StevekDon/NaI-Tl-scintillator-gamma-ray-Digital-Multi-Channel-Analyzer/hardware/mechnical/zynq_box.stl

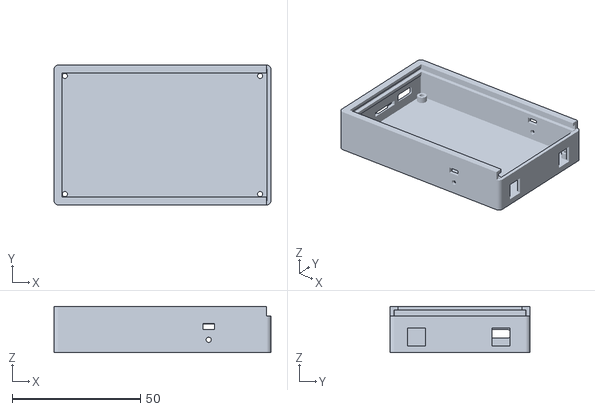
[picture p1: CAD file, 2026-01-17]
hardware/mechnical/zynq_box.stl
84.5 x 54.5 x 18.0
