StevekDon/NaI-Tl-scintillator-gamma-ray-Digital-Multi-Channel-Analyzer/hardware/mechnical/detector_cover.stl

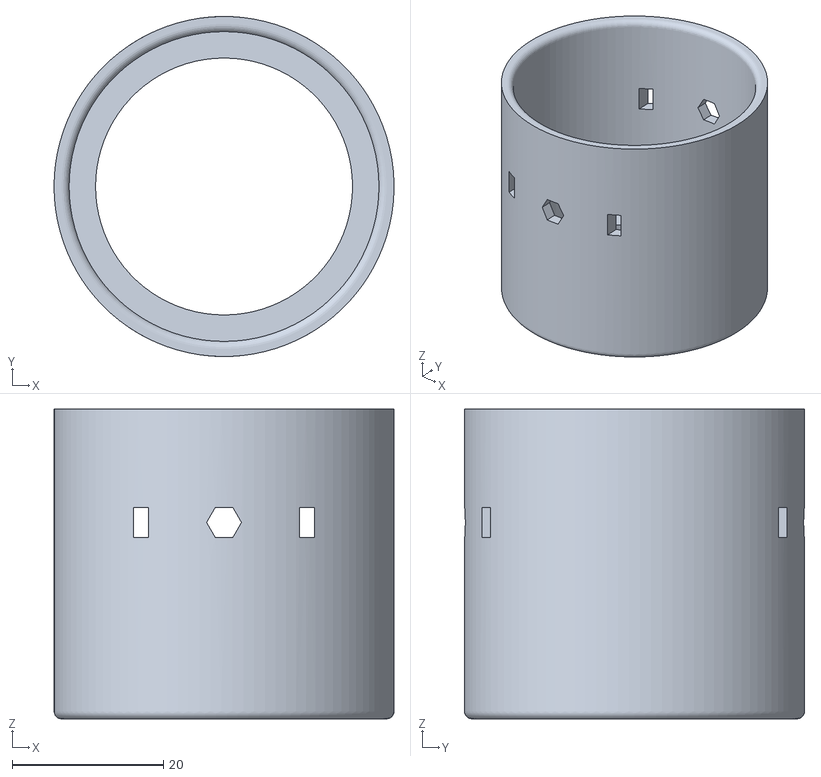
[picture p2: CAD file, 2026-01-17]
hardware/mechnical/detector_cover.stl
45.0 x 45.0 x 41.0
