StevekDon/NaI-Tl-scintillator-gamma-ray-Digital-Multi-Channel-Analyzer/hardware/mechnical/zynq_cover.stl

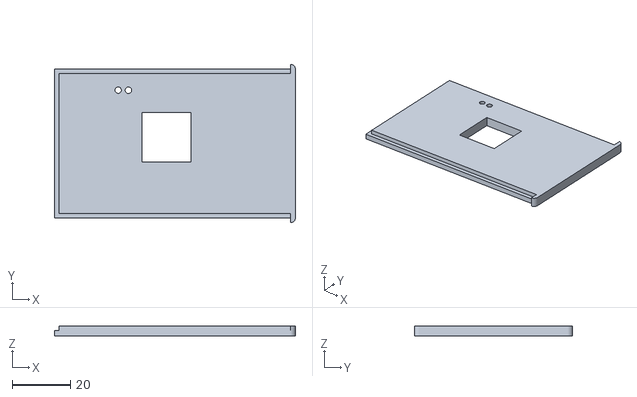
[picture p3: CAD file, 2026-01-17]
hardware/mechnical/zynq_cover.stl
82.9 x 54.5 x 3.60
