StevekDon/NaI-Tl-scintillator-gamma-ray-Digital-Multi-Channel-Analyzer/hardware/mechnical/3d_side_arm v6.stl

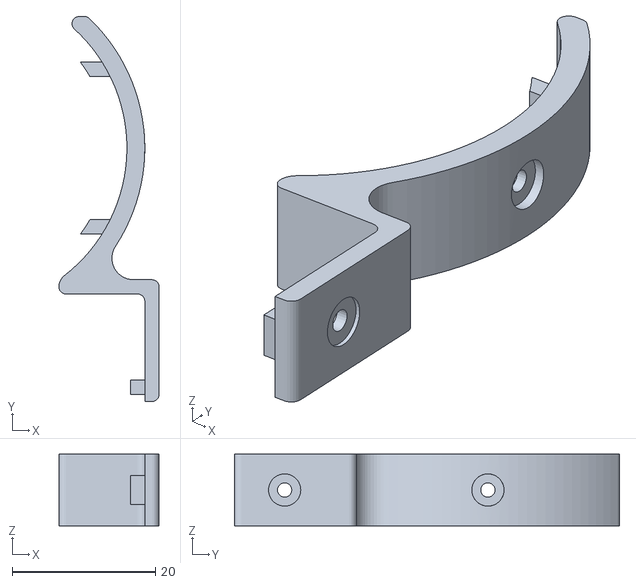
[picture p4: CAD file, 2026-01-17]
hardware/mechnical/3d_side_arm v6.stl
14.0 x 53.7 x 10.0
