StevekDon/NaI-Tl-scintillator-gamma-ray-Digital-Multi-Channel-Analyzer/hardware/schematics/PMT_PWR.pdf

## PMT负高压源 输入升压+12V

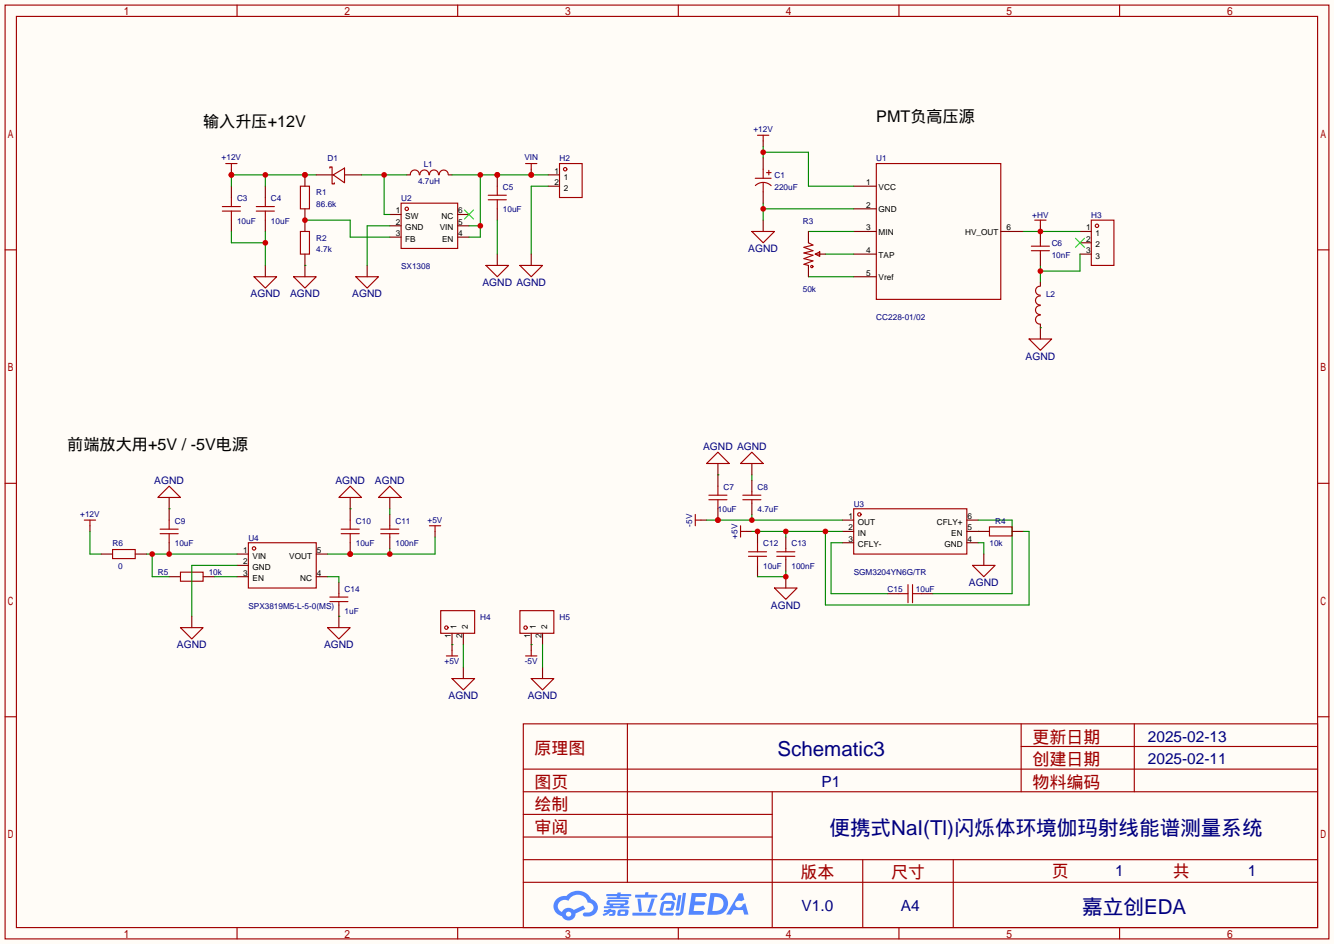
[picture p5: page 1]
