StevekDon/NaI-Tl-scintillator-gamma-ray-Digital-Multi-Channel-Analyzer/hardware/schematics/xilin_downloader.pdf

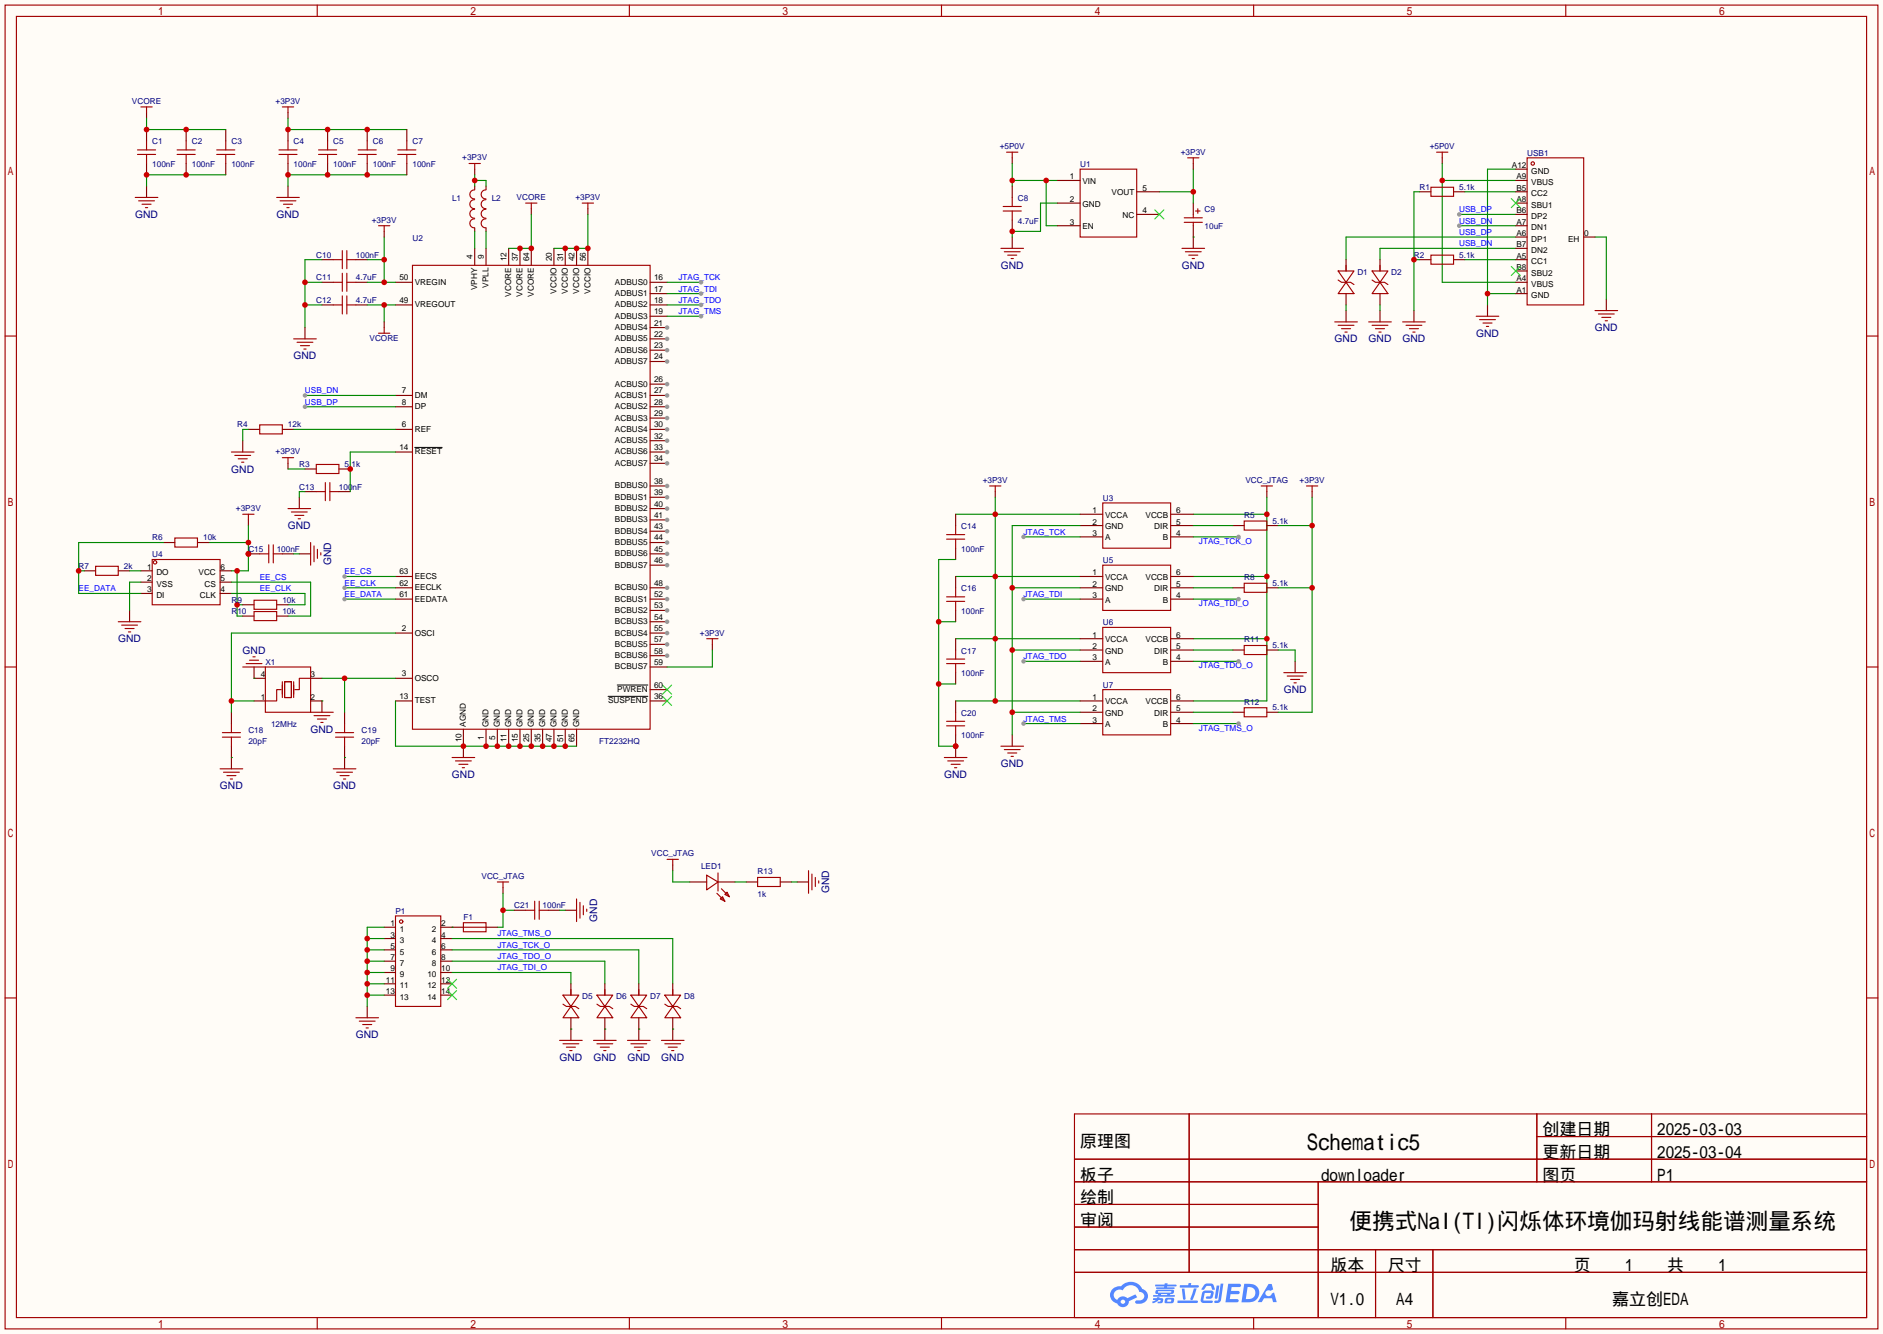
[picture p6: page 1]

GND GND

原理图 | Schematic5 | 创建日期 | 2025-03-03

更新日期 | 2025-03-04

板子 | downloader | 图页 | P1
绘制 | | 便携式NaI(Tl)闪烁体环境伽玛射线能谱测量系统
审阅

V1.0 | A4 | 嘉立创EDA
