StevekDon/NaI-Tl-scintillator-gamma-ray-Digital-Multi-Channel-Analyzer/hardware/schematics/zynq7020.pdf

审阅

绘制

版本

## 创建日期 物料编码

页 | 共

## 原理图

## 更新日期

尺寸

图页

V1.0 | A3

# 便携式NaI(Tl)闪烁体环境伽玛射线能谱测量系统

2025-08-05

# 2025-02-11 Schematic1_1

# BLOCK

# XC7Z020-2CLG400I

DDR3 2Gb | QSPI-FLASH | TF-CARD

AD9245

# 80MHz

# UART-PS PL-UARTLite JTAG

# PL 50.00MHz PS 33.33MHz

审阅

绘制

## 创建日期 物料编码

## 原理图

## 更新日期

图页

# 便携式NaI(Tl)闪烁体环境伽玛射线能谱测量系统

2025-07-16

# 2025-02-11 Schematic1_1

# POWER_TREE

+5P0V_IN | +1V0_S0 | +1V8_S0 | +1V35_S0 | +3V3_S0

# PS: VCCINT(1.0V) -> VCCPAUX&VCCPLL(1.8V) -> VCC_1.35V -> VCC_3V3 PL: VCCINT&VCCBRAM(1.0V) -> VCCAUX&VCCAUX_IO&VCCO_1V8(1.8V) -> VCC_3V3

+3V3_ADC | -3V3_ADC

+1.0V @ 3A

# PS: VCCINT(1.0V) -> VCCPAUX&VCCPLL(1.8V) -> VCC_1.35V -> VCC_3V3

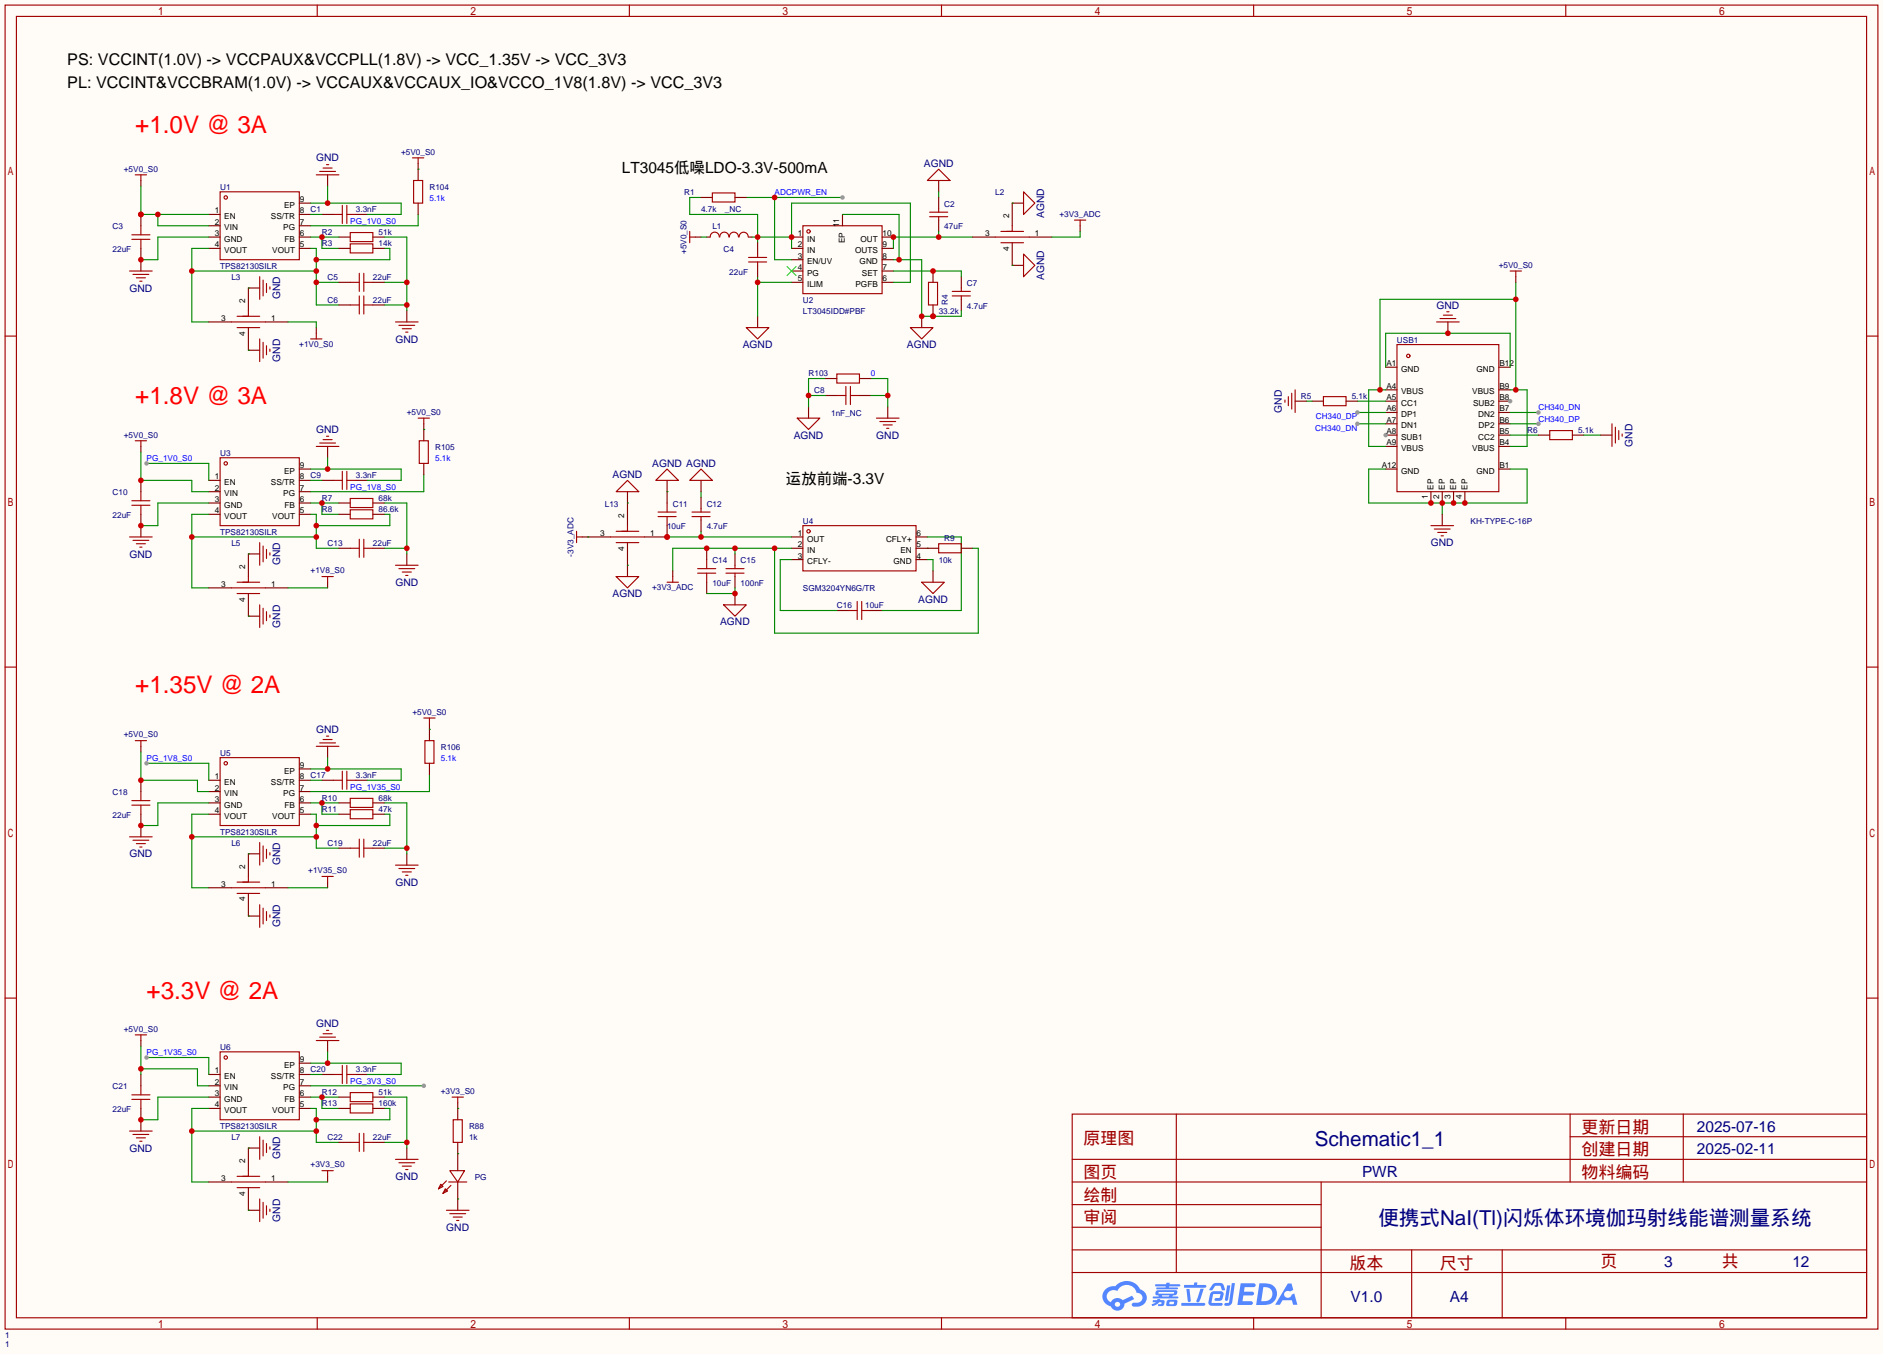
[picture p7: page 3]

PL: VCCINT&VCCBRAM(1.0V) -> VCCAUX&VCCAUX_IO&VCCO_1V8(1.8V) -> VCC_3V3

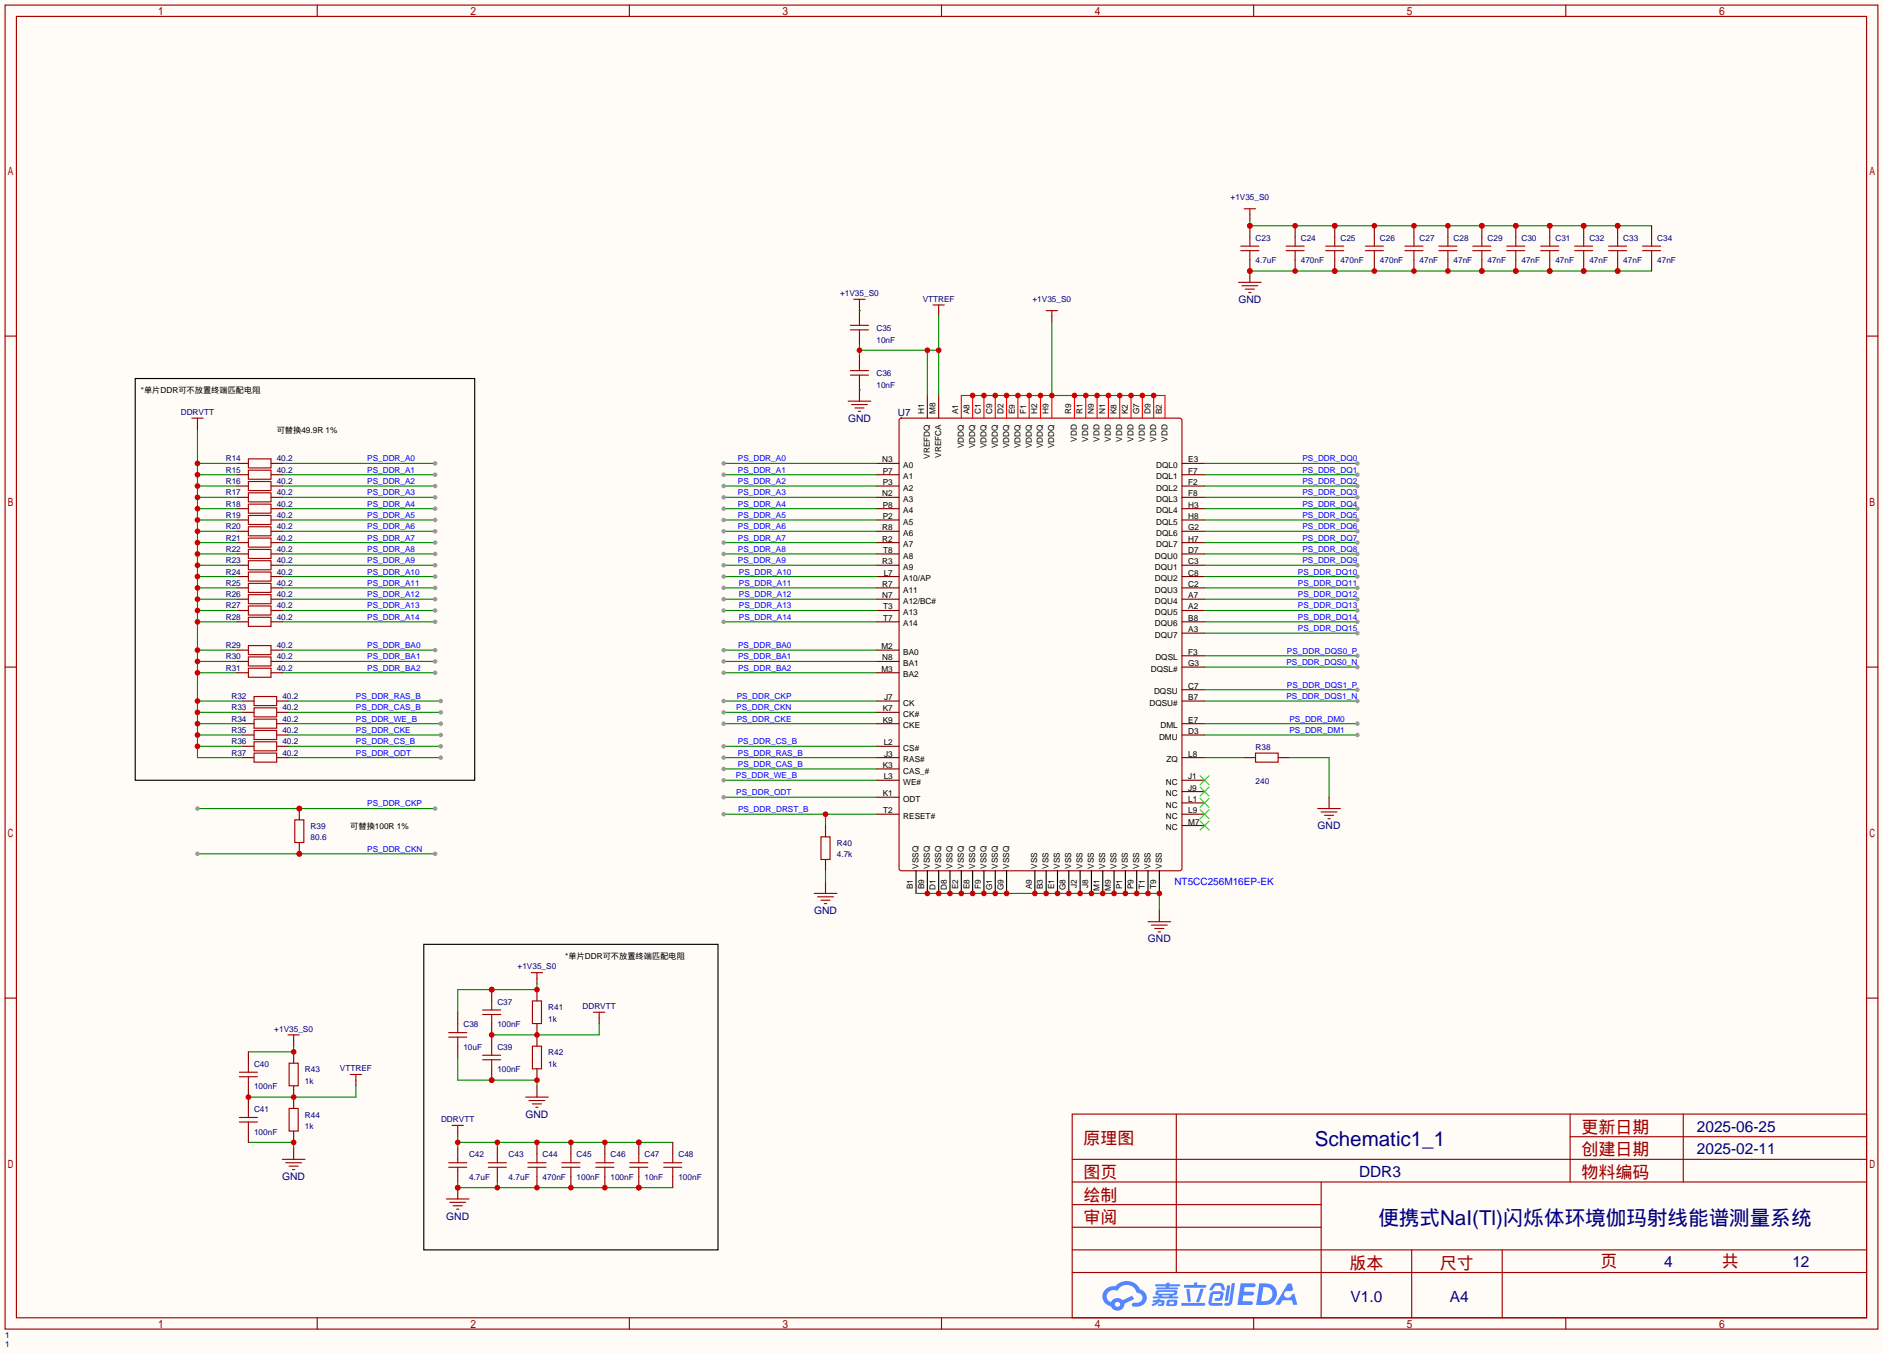
[picture p8: page 4]

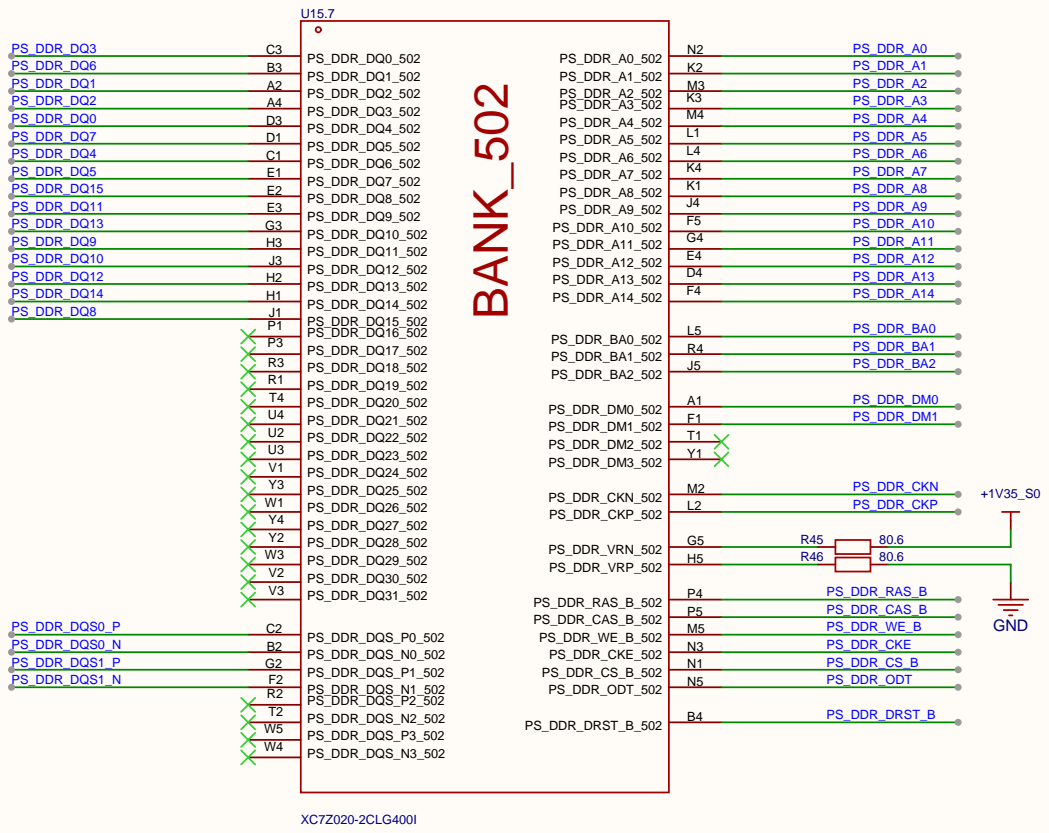
[picture p9: page 5]

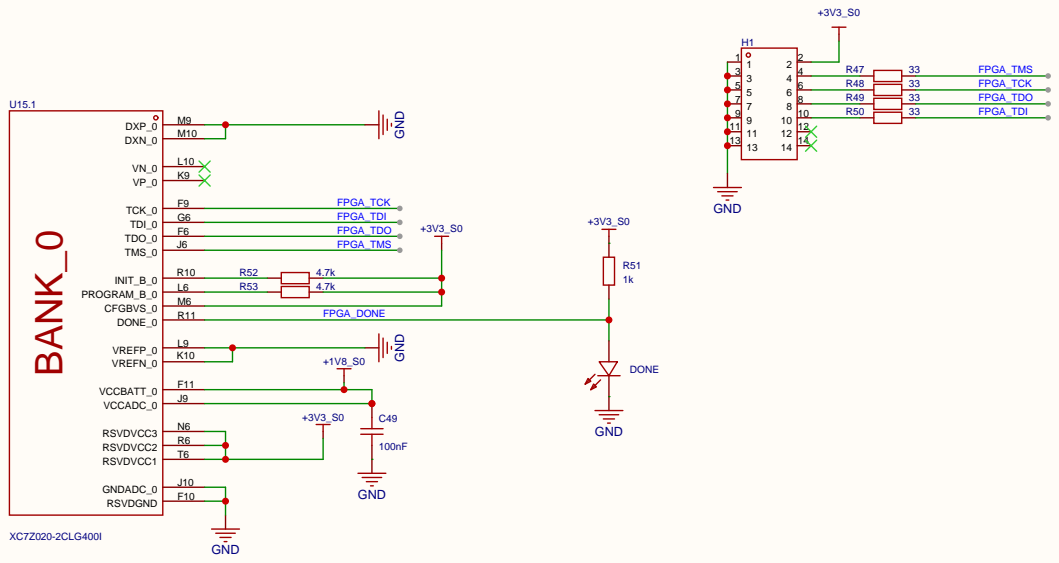
[picture p10: page 6]

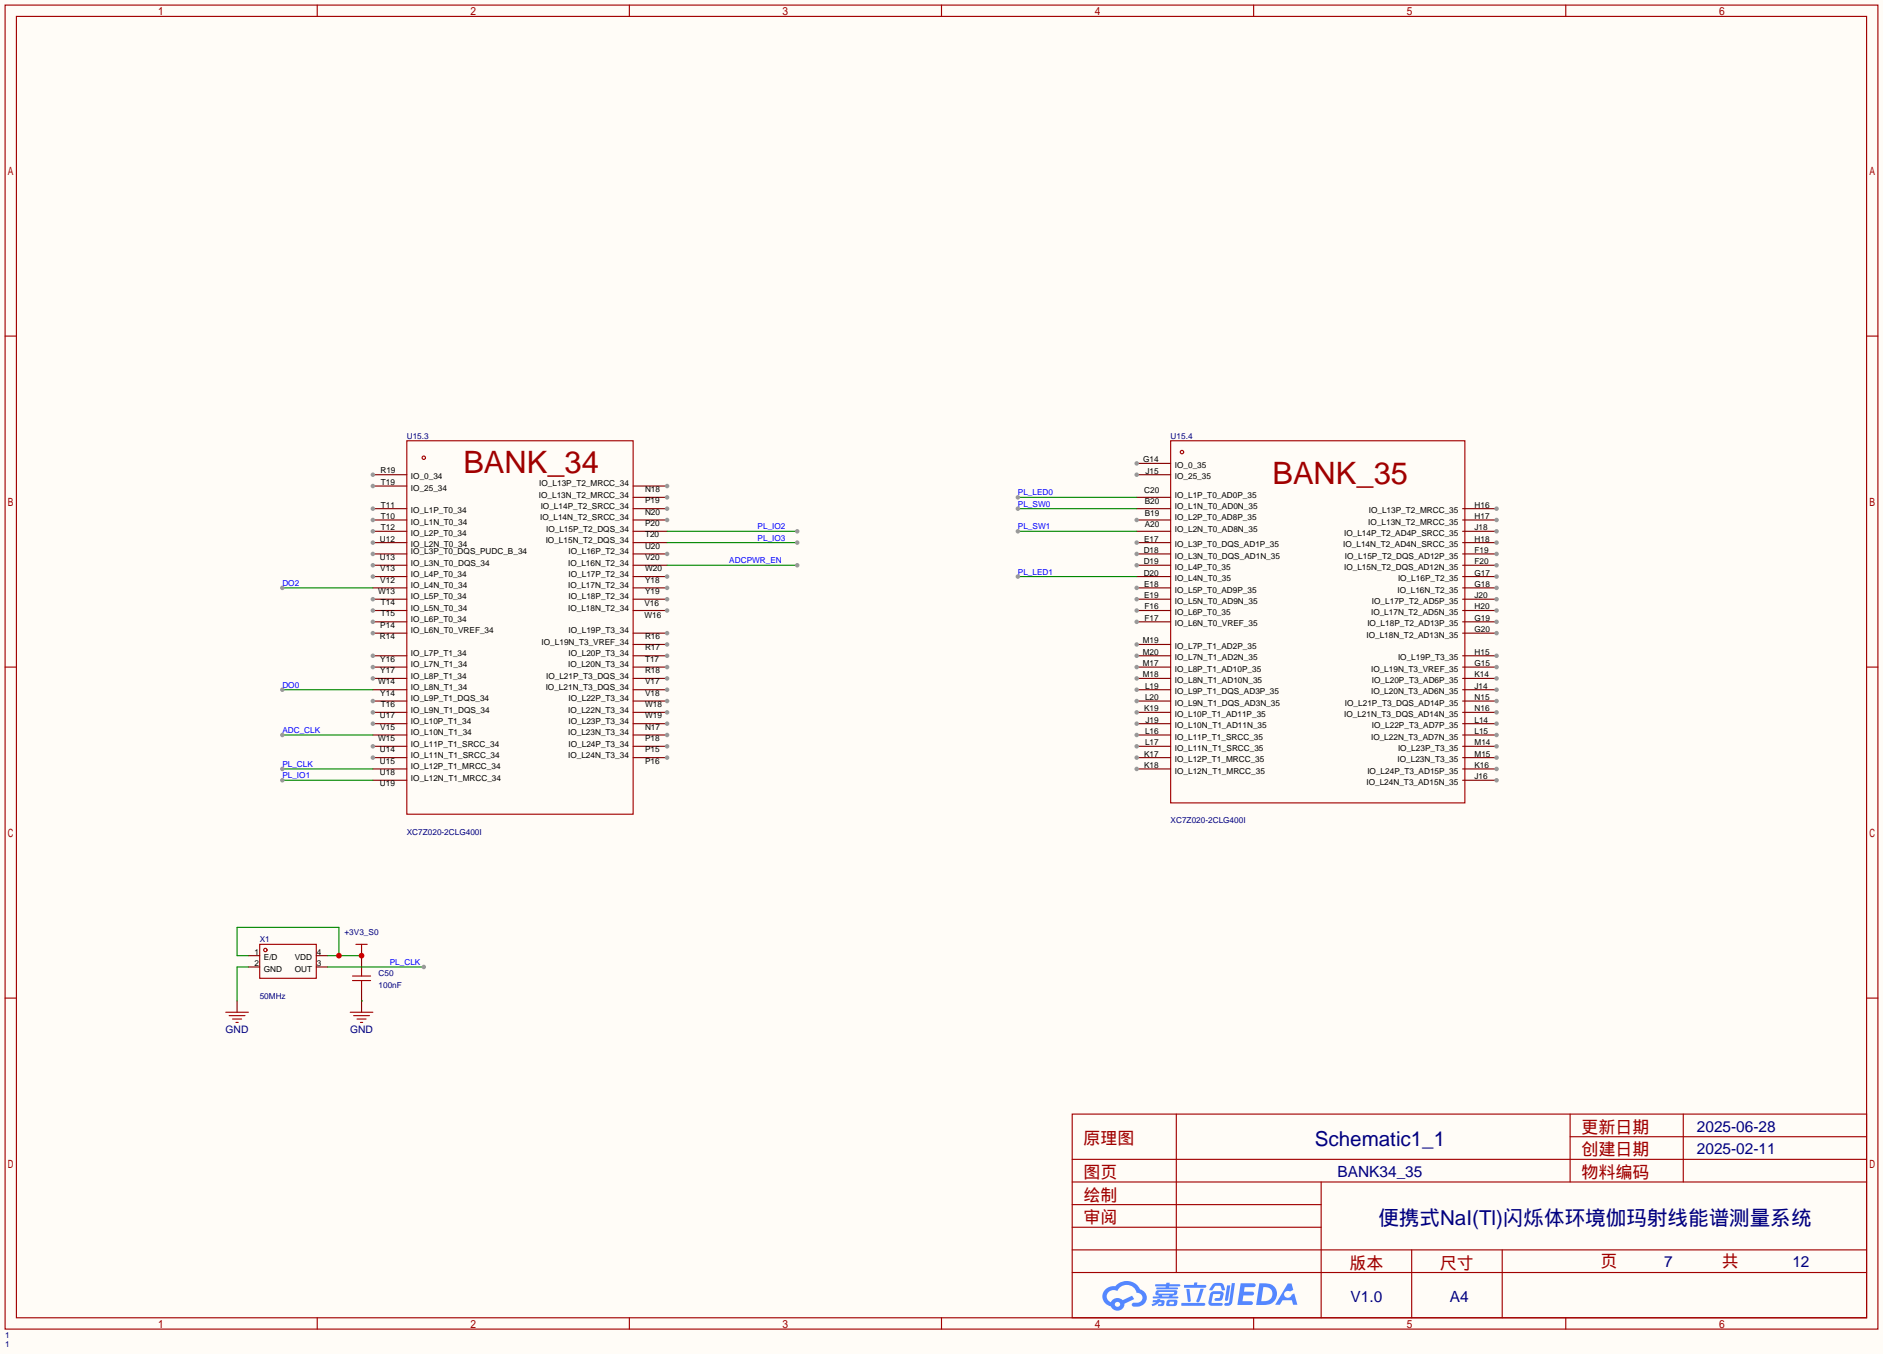
[picture p11: page 7]

# *BOOT OPTION

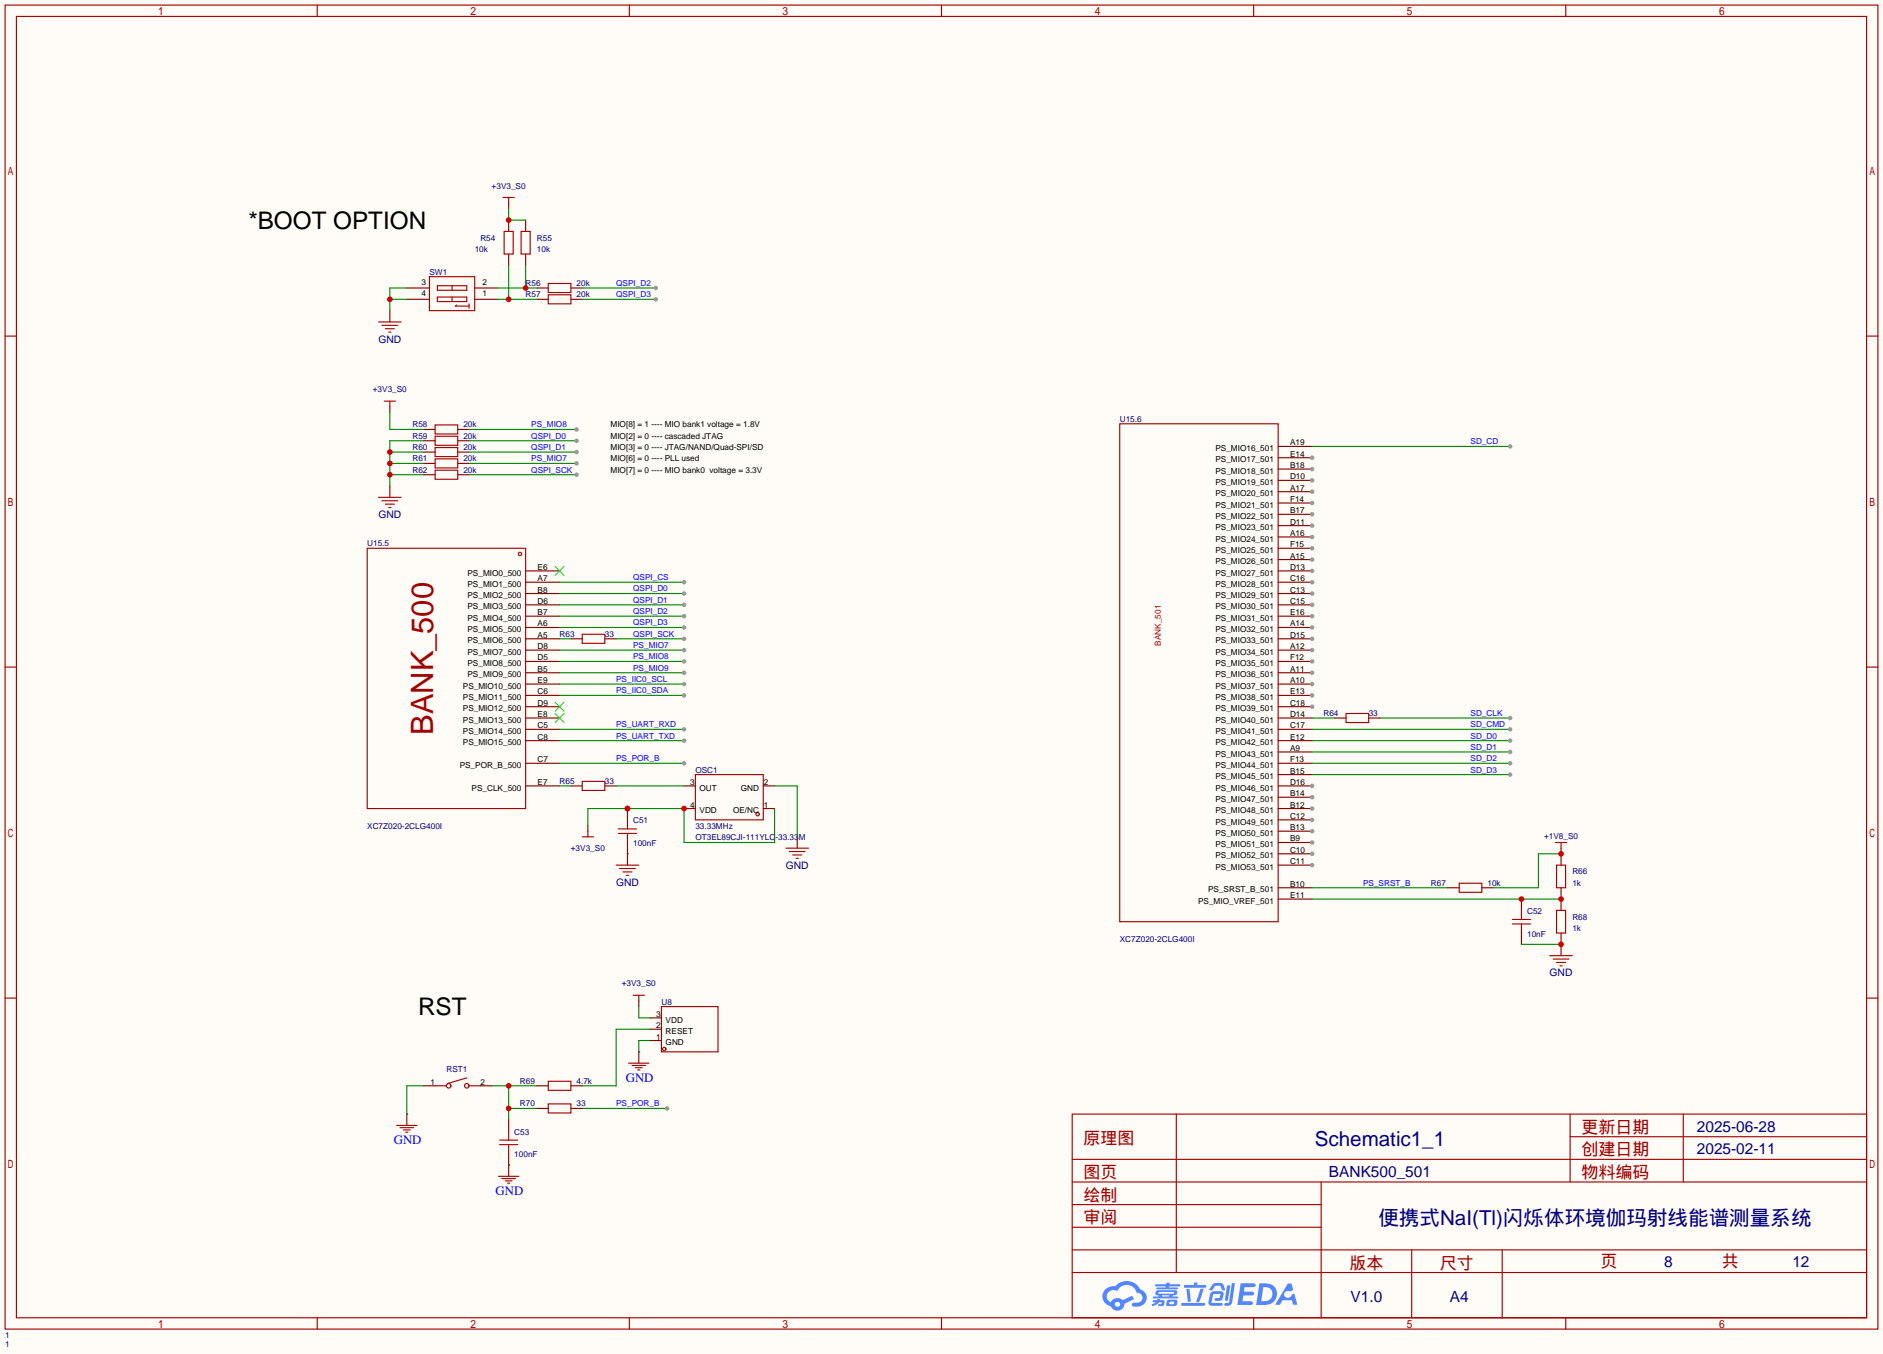
[picture p12: page 8]

MIO[8] = 1 ---- MIO bank1 voltage = 1.8V
MIO[2] = 0 ---- cascaded JTAG
MIO[3] = 0 ---- JTAG/NAND/Quad-SPI/SD
MIO[6] = 0 ---- PLL used
MIO[7] = 0 ---- MIO bank0 voltage = 3.3V

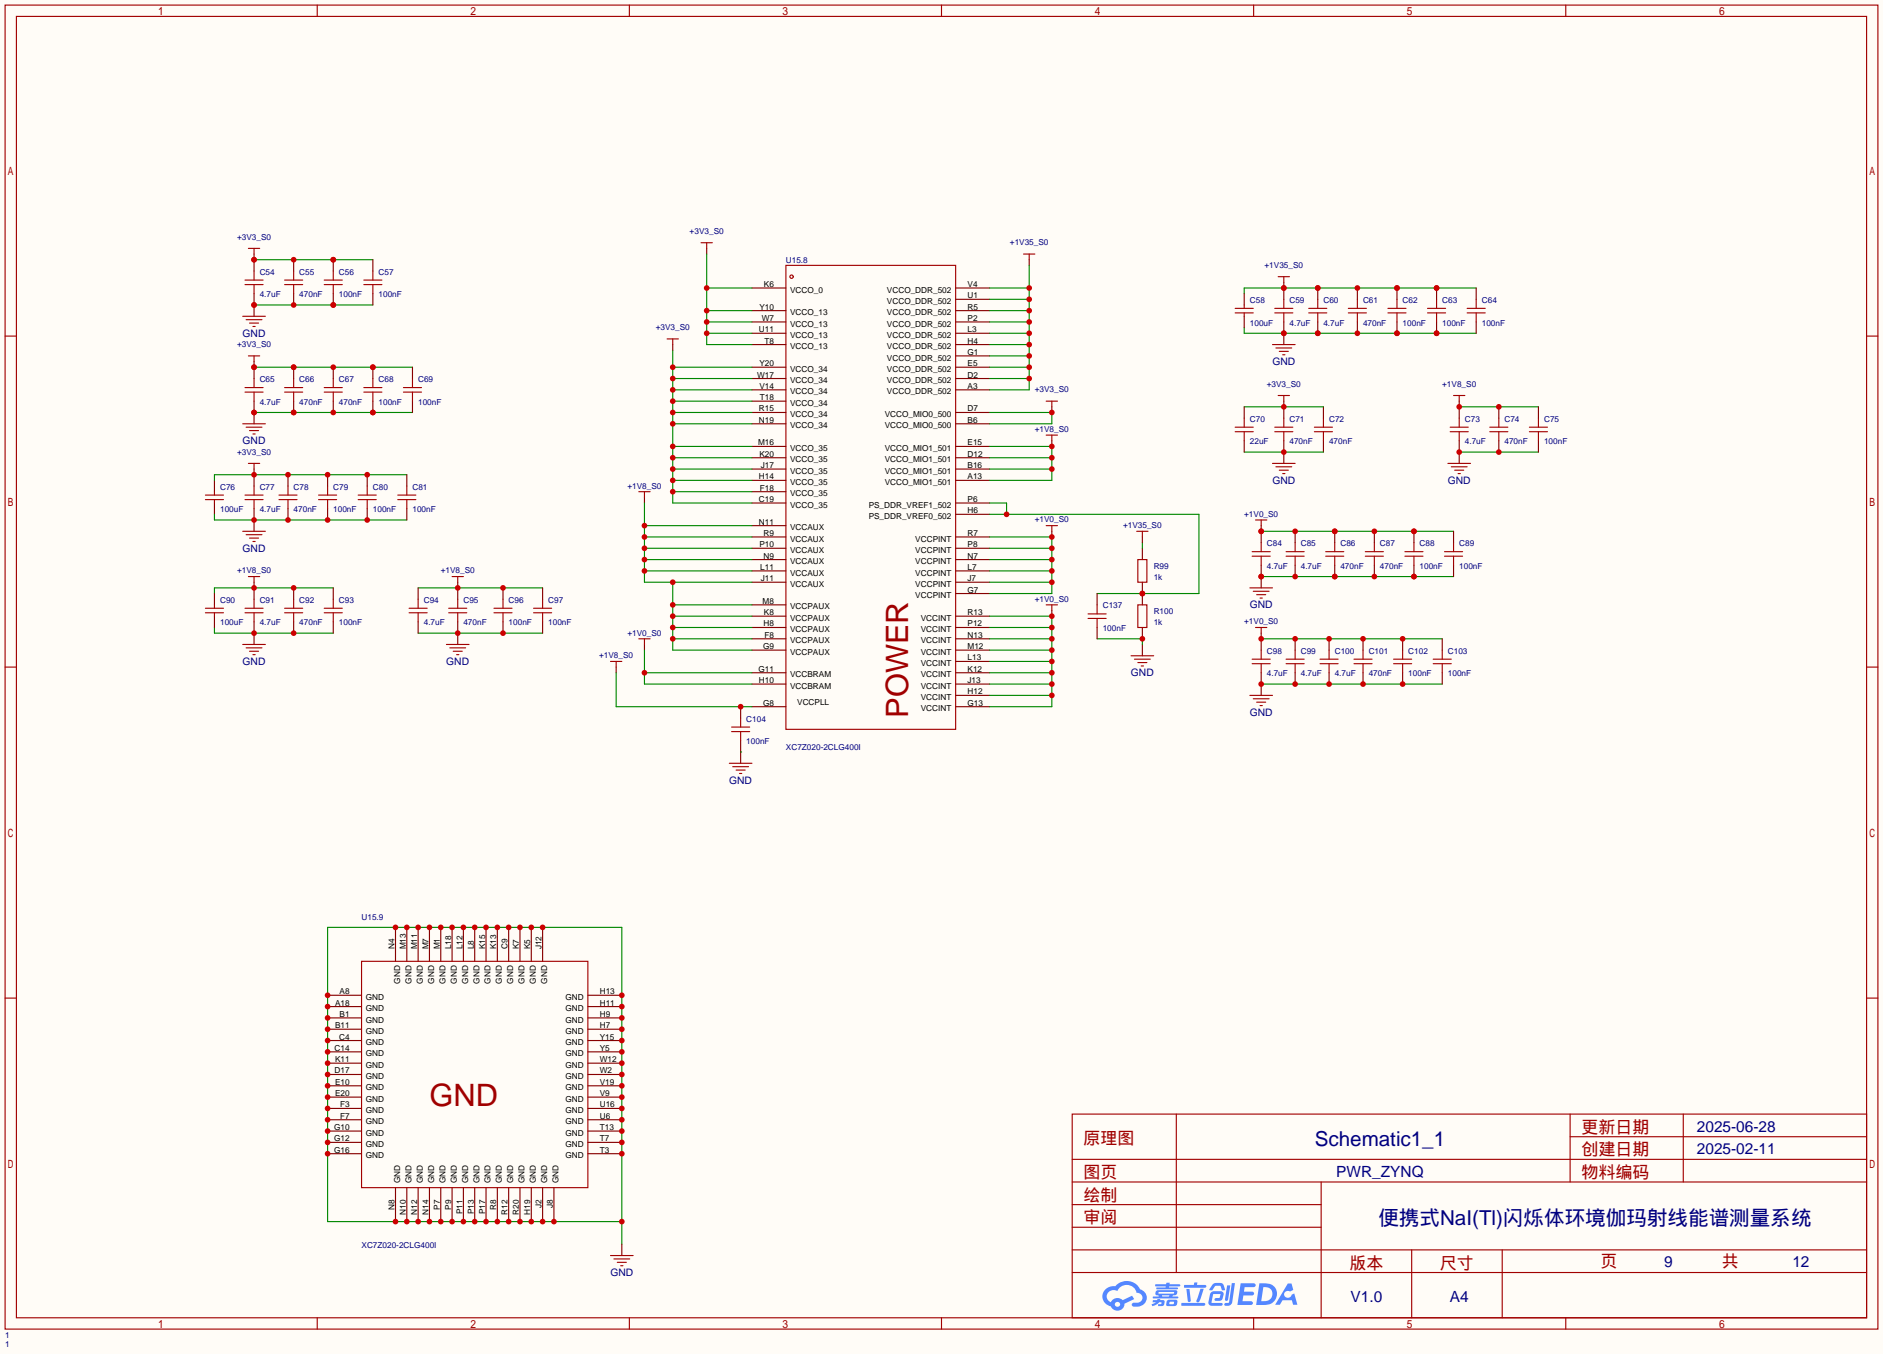
[picture p13: page 9]

GND J8 GND J12 GND K5 GND K7 GND C9 GND K13 GND K15 GND L8 GND L12 GND L18 GND M1 GND M7 GND M11 GND M13 GND N4 GND N8 GND N10 GND N12 GND N14 GND P7 GND P9 GND P11 GND P13 GND P17 GND R8 GND R12 GND R20

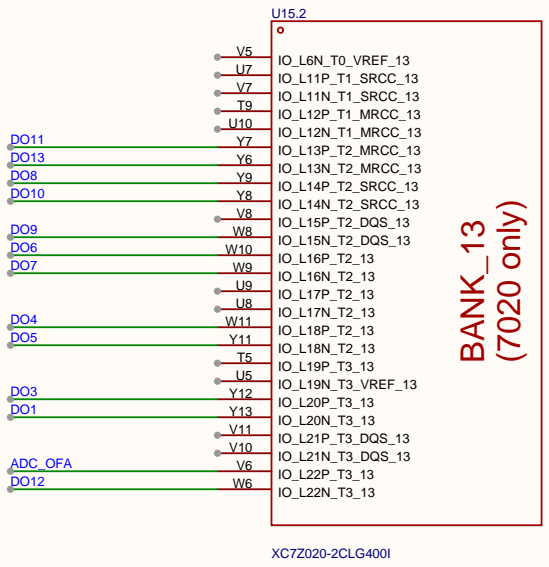
[picture p14: figure]
IO_L6N_T0_VREF_13 V5 IO_L11P_T1_SRCC_13 U7 IO_L11N_T1_SRCC_13 V7 IO_L12P_T1_MRCC_13 T9 IO_L12N_T1_MRCC_13 U10 IO_L13P_T2_MRCC_13 Y7 IO_L13N_T2_MRCC_13 Y6 IO_L14P_T2_SRCC_13 Y9 IO_L14N_T2_SRCC_13 Y8 IO_L15P_T2_DQS_13 V8 IO_L15N_T2_DQS_13 W8 IO_L16P_T2_13 W10 IO_L16N_T2_13 W9 IO_L17P_T2_13 U9 IO_L17N_T2_13 U8 IO_L18P_T2_13 W11 IO_L18N_T2_13 Y11 IO_L19P_T3_13 T5 IO_L19N_T3_VREF_13 U5 IO_L20P_T3_13 Y12 IO_L20N_T3_13 Y13 IO_L21P_T3_DQS_13 V11 IO_L21N_T3_DQS_13 V10 IO_L22P_T3_13 V6 IO_L22N_T3_13 W6; BANK_13; (7020 only); XC7Z020-2CLG400I; ADC_OFA DO12

审阅

绘制

## 创建日期 物料编码 页

共

## 原理图

## 更新日期

图页

# 便携式NaI(Tl)闪烁体环境伽玛射线能谱测量系统

2025-06-28

# 2025-02-11 Schematic1_1

# BANK13

# AD9245-80M

# *具体电阻取值或增益调整参考datasheet的Setting the Closed-Loop Gain & Terminating a Single-Ended Input部分

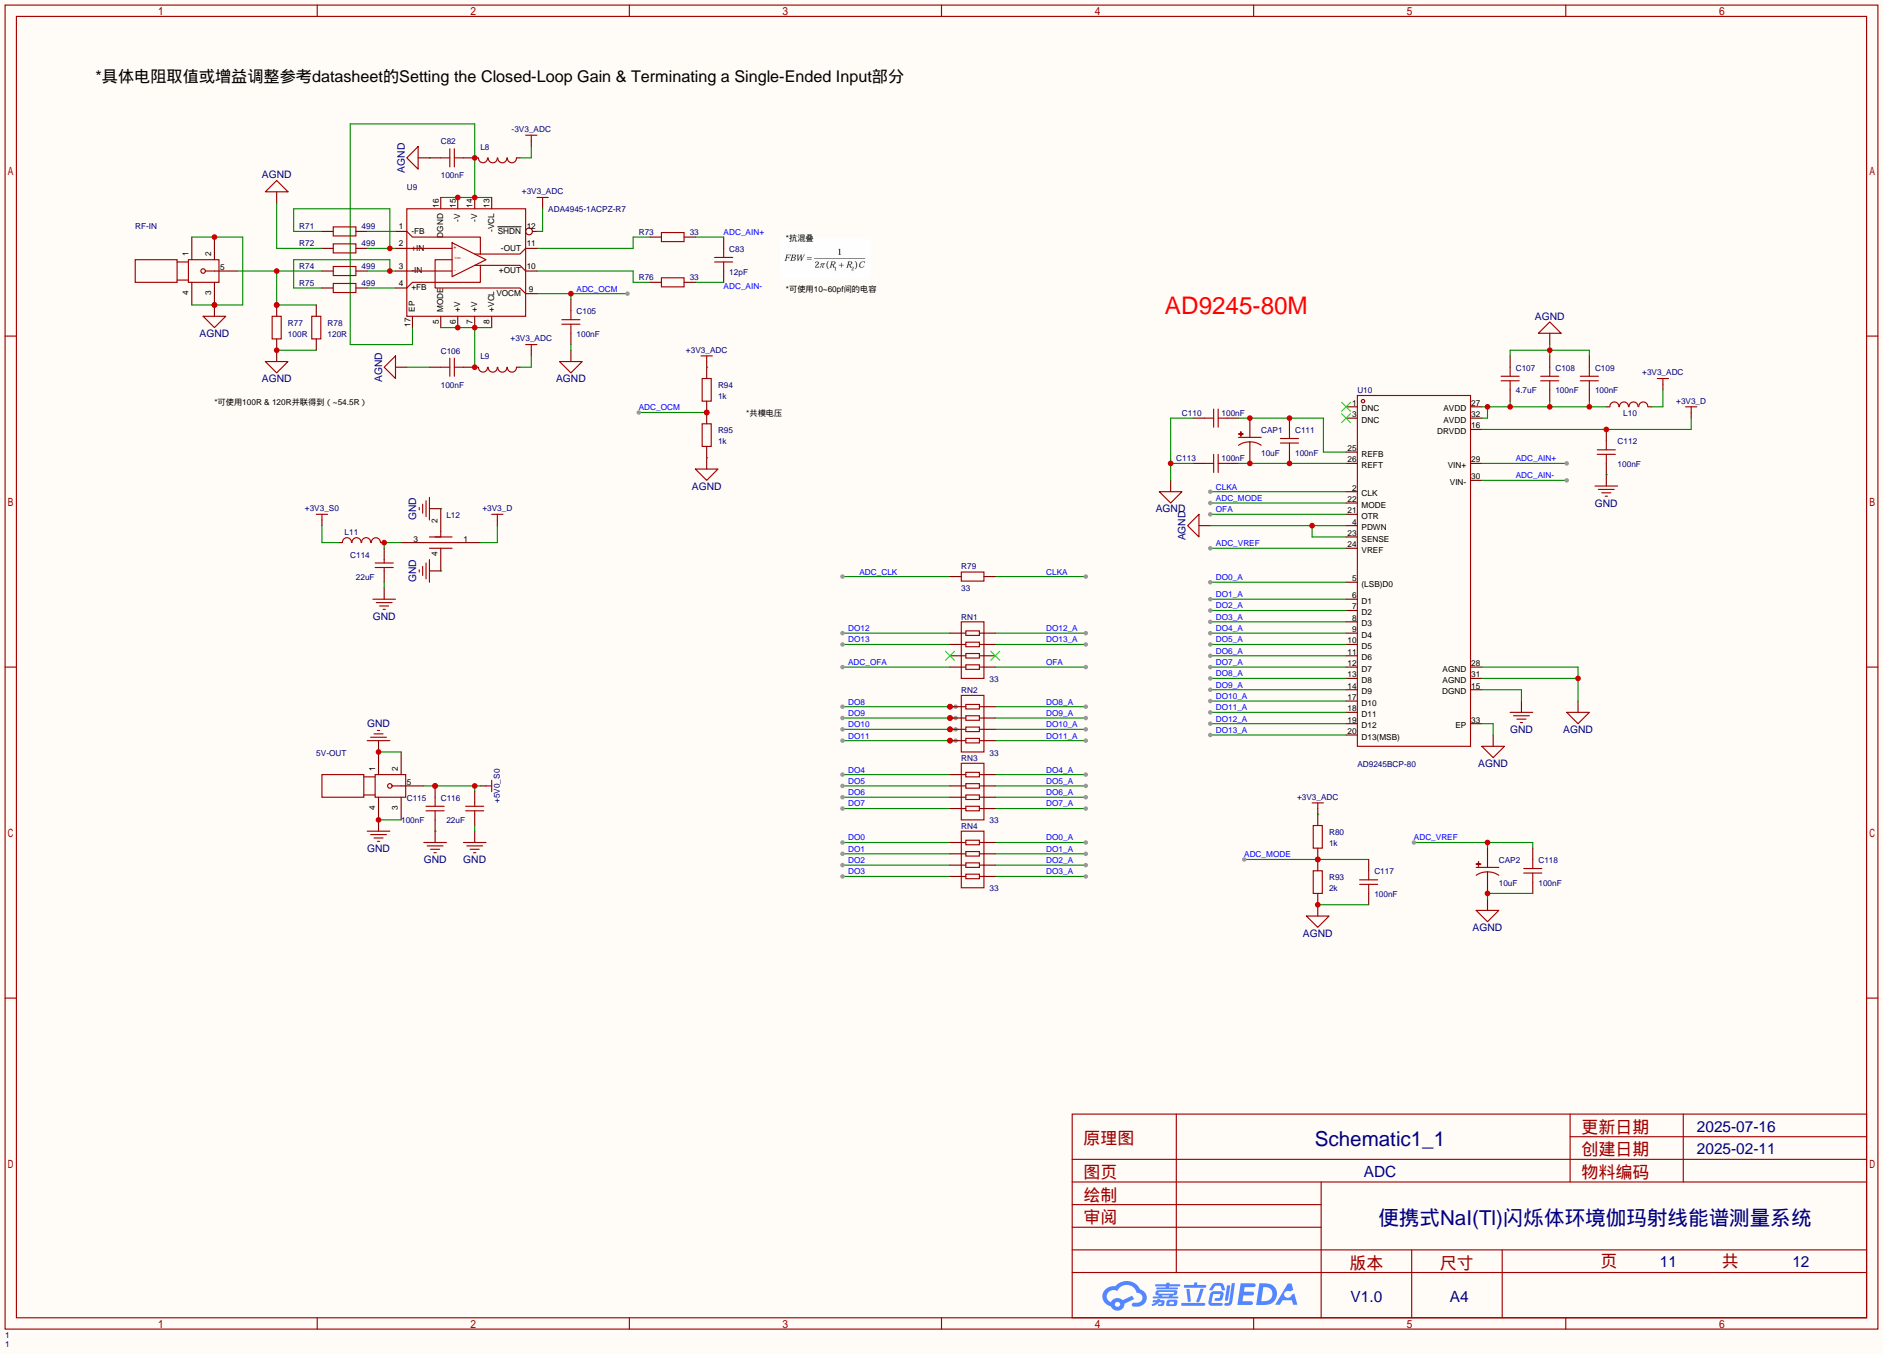
[picture p15: page 11]

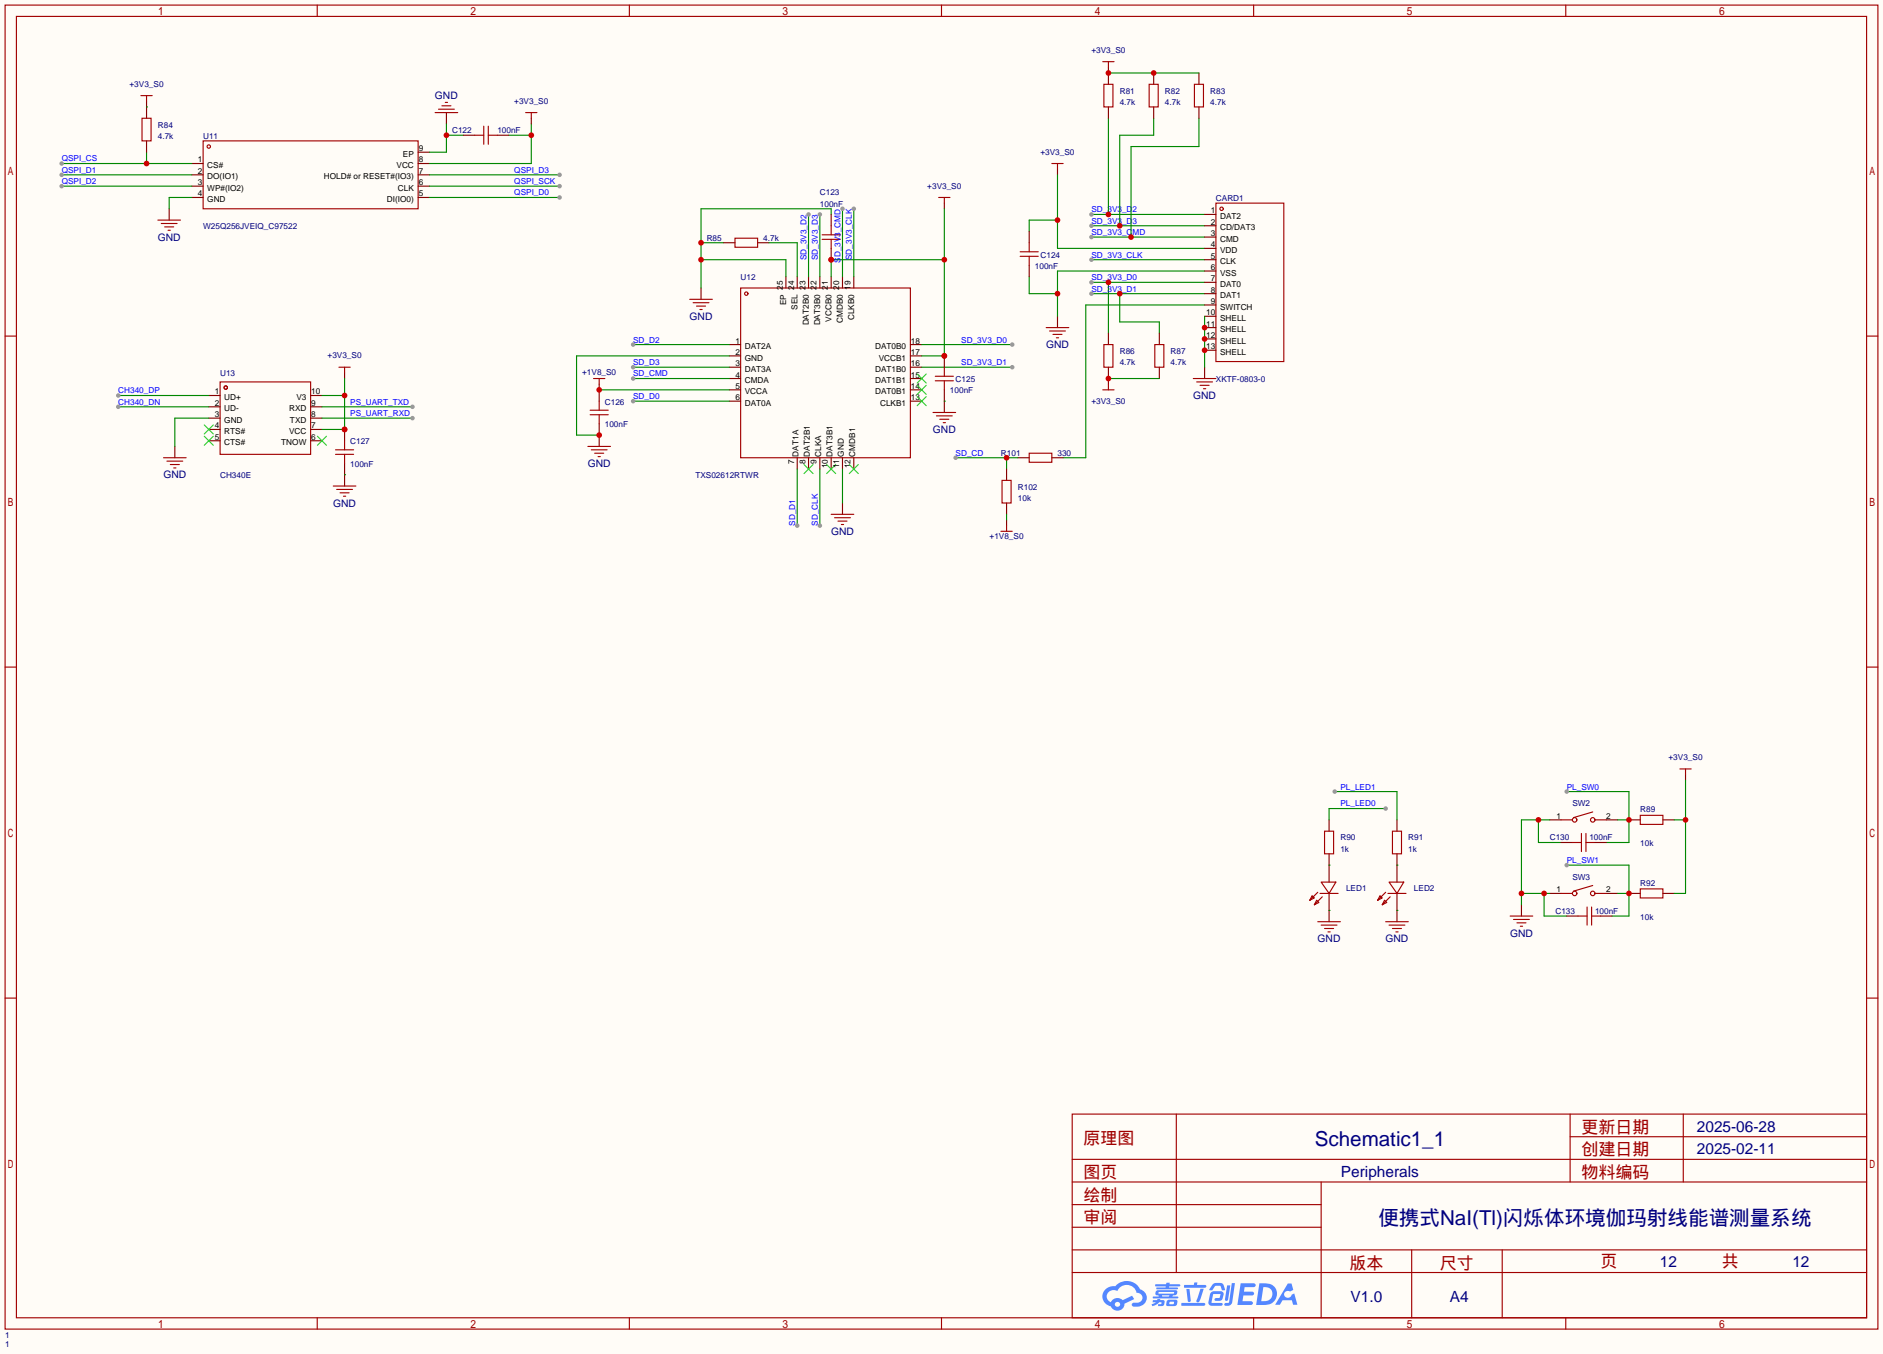
[picture p16: page 12]
