StevekDon/NaI-Tl-scintillator-gamma-ray-Digital-Multi-Channel-Analyzer/hardware/schematics/PMT_preAmp_1.pdf

## （包含preAmp、preAmp_2）

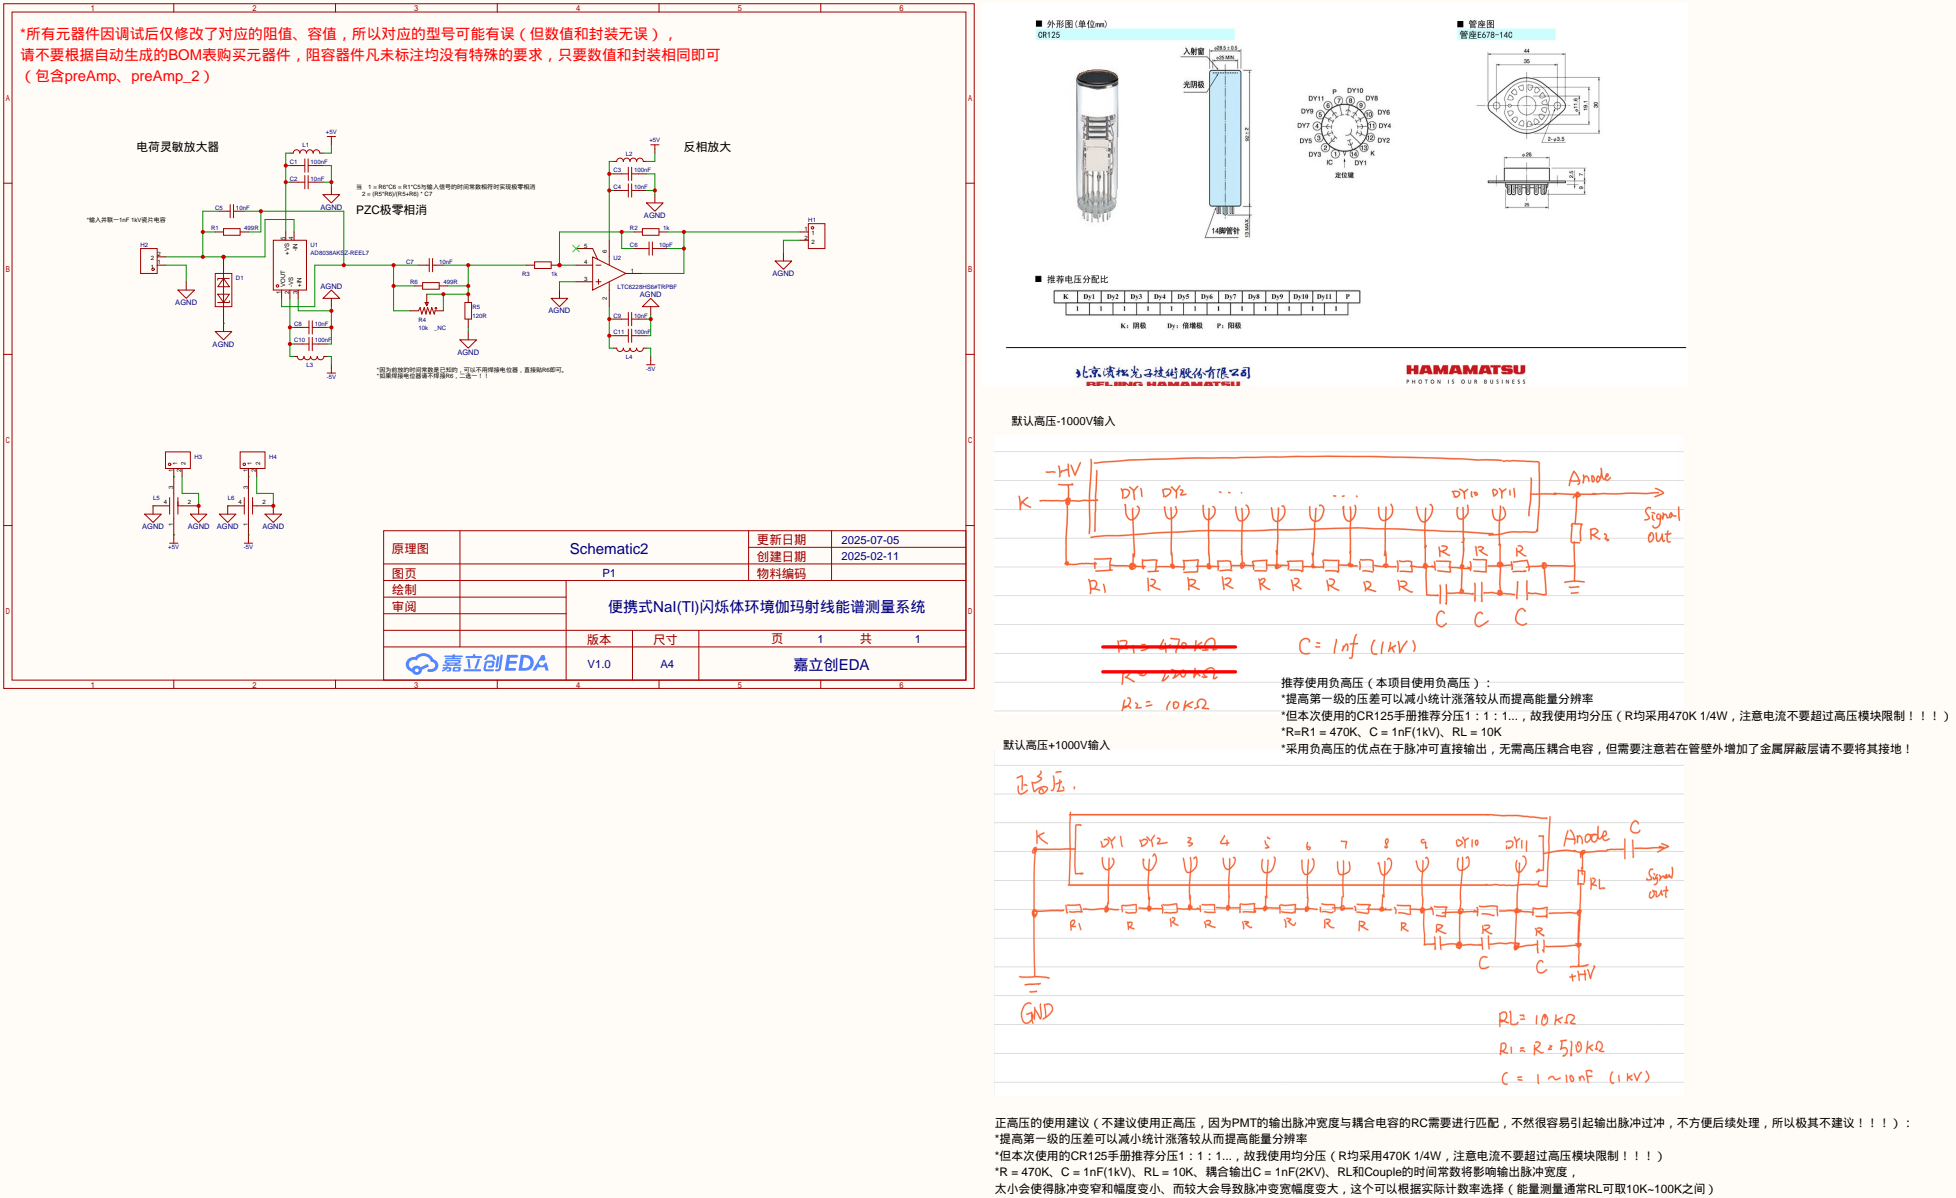
[picture p17: page 1]

*所有元器件因调试后仅修改了对应的阻值、容值，所以对应的型号可能有误（但数值和封装无误），
请不要根据自动生成的BOM表购买元器件，阻容器件凡未标注均没有特殊的要求，只要数值和封装相同即可

正高压的使用建议（不建议使用正高压，因为PMT的输出脉冲宽度与耦合电容的RC需要进行匹配，不然很容易引起输出脉冲过冲，不方便后续处理，所以极其不建议！！！）：
*提高第一级的压差可以减小统计涨落较从而提高能量分辨率
*但本次使用的CR125手册推荐分压1：1：1...，故我使用均分压（R均采用470K 1/4W，注意电流不要超过高压模块限制！！！）
*R = 470K、C = 1nF(1kV)、RL = 10K、耦合输出C = 1nF(2KV)、RL和Couple的时间常数将影响输出脉冲宽度，
太小会使得脉冲变窄和幅度变小、而较大会导致脉冲变宽幅度变大，这个可以根据实际计数率选择（能量测量通常RL可取10K~100K之间）
