StevekDon/NaI-Tl-scintillator-gamma-ray-Digital-Multi-Channel-Analyzer/hardware/schematics/PMT_preAmp_2.pdf

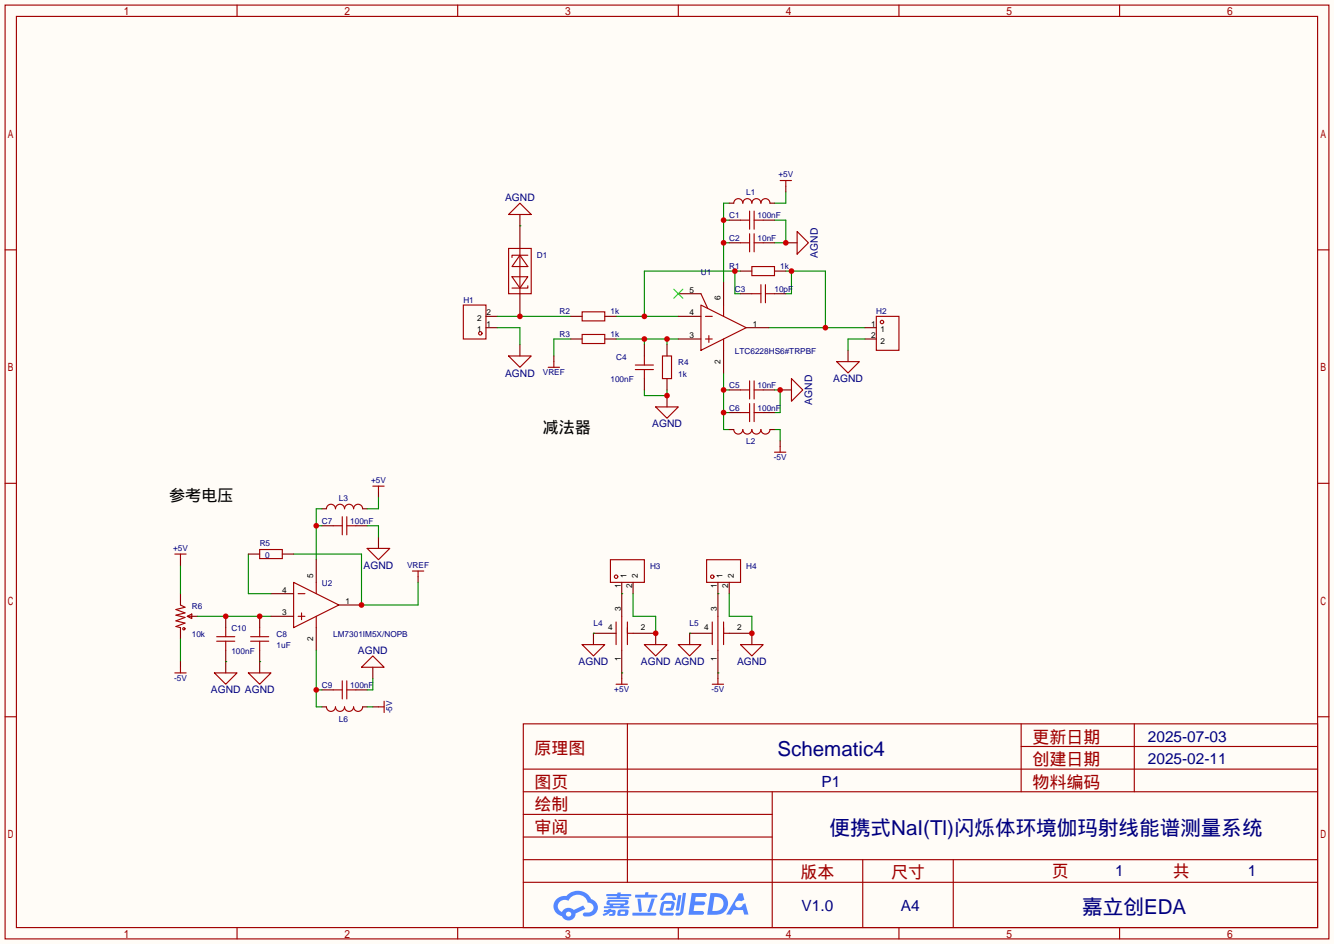
[picture p18: page 1]
