StevekDon/NaI-Tl-scintillator-gamma-ray-Digital-Multi-Channel-Analyzer/firmware/vivado/zynq_dmca.gen/sources_1/bd/system/ip/system_dmca_top_0_0/synth/system_dmca_top_0_0.v

// (c) Copyright 1995-2025 Xilinx, Inc. All rights reserved.
// 
// This file contains confidential and proprietary information
// of Xilinx, Inc. and is protected under U.S. and
// international copyright and other intellectual property
// laws.
// 
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
// CRITICAL APPLICATIONS
// Xilinx products are not designed or intended to be fail-
// safe, or for use in any application requiring fail-safe
// performance, such as life-support or safety devices or
// systems, Class III medical devices, nuclear facilities,
// applications related to the deployment of airbags, or any
// other applications that could lead to death, personal
// injury, or severe property or environmental damage
// (individually and collectively, "Critical
// Applications"). Customer assumes the sole risk and
// liability of any use of Xilinx products in Critical
// Applications, subject only to applicable laws and
// regulations governing limitations on product liability.
// 
// THIS COPYRIGHT NOTICE AND DISCLAIMER MUST BE RETAINED AS
// PART OF THIS FILE AT ALL TIMES.
// 
// DO NOT MODIFY THIS FILE.


// IP VLNV: xilinx.com:module_ref:dmca_top:1.0
// IP Revision: 1

(* X_CORE_INFO = "dmca_top,Vivado 2022.2" *)
(* CHECK_LICENSE_TYPE = "system_dmca_top_0_0,dmca_top,{}" *)
(* CORE_GENERATION_INFO = "system_dmca_top_0_0,dmca_top,{x_ipProduct=Vivado 2022.2,x_ipVendor=xilinx.com,x_ipLibrary=module_ref,x_ipName=dmca_top,x_ipVersion=1.0,x_ipCoreRevision=1,x_ipLanguage=VERILOG,x_ipSimLanguage=MIXED,AXISTREAM_DATA_W=32,REG_GLOBAL_LIMIT=300,ADC_BIT=14,CLK_FREQ_MHZ=80}" *)
(* IP_DEFINITION_SOURCE = "module_ref" *)
(* DowngradeIPIdentifiedWarnings = "yes" *)
module system_dmca_top_0_0 (
  sys_clk,
  sys_rstn,
  adc_datain,
  adc_dataout,
  adc_fir_datain,
  trapezd_data,
  triangle_data,
  M_AXIS_TVALID,
  M_AXIS_TDATA,
  M_AXIS_TLAST,
  M_AXIS_TREADY,
  M_AXIS_ARESETN,
  ms_en,
  na,
  nb,
  na_1,
  d_na,
  peak_thd,
  peak_thd_count,
  peak_top_delay,
  timer_counter
);

(* X_INTERFACE_PARAMETER = "XIL_INTERFACENAME sys_clk, ASSOCIATED_RESET sys_rstn, FREQ_HZ 8e+07, FREQ_TOLERANCE_HZ 0, PHASE 0.0, CLK_DOMAIN system_processing_system7_0_0_FCLK_CLK0, INSERT_VIP 0" *)
(* X_INTERFACE_INFO = "xilinx.com:signal:clock:1.0 sys_clk CLK" *)
input wire sys_clk;
(* X_INTERFACE_PARAMETER = "XIL_INTERFACENAME sys_rstn, POLARITY ACTIVE_LOW, INSERT_VIP 0" *)
(* X_INTERFACE_INFO = "xilinx.com:signal:reset:1.0 sys_rstn RST" *)
input wire sys_rstn;
input wire [13 : 0] adc_datain;
output wire [13 : 0] adc_dataout;
input wire [13 : 0] adc_fir_datain;
output wire [16 : 0] trapezd_data;
output wire [16 : 0] triangle_data;
(* X_INTERFACE_INFO = "xilinx.com:interface:axis:1.0 M_AXIS TVALID" *)
output wire M_AXIS_TVALID;
(* X_INTERFACE_INFO = "xilinx.com:interface:axis:1.0 M_AXIS TDATA" *)
output wire [31 : 0] M_AXIS_TDATA;
(* X_INTERFACE_INFO = "xilinx.com:interface:axis:1.0 M_AXIS TLAST" *)
output wire M_AXIS_TLAST;
(* X_INTERFACE_PARAMETER = "XIL_INTERFACENAME M_AXIS, TDATA_NUM_BYTES 4, TDEST_WIDTH 0, TID_WIDTH 0, TUSER_WIDTH 0, HAS_TREADY 1, HAS_TSTRB 0, HAS_TKEEP 0, HAS_TLAST 1, FREQ_HZ 80000000, PHASE 0.0, LAYERED_METADATA undef, INSERT_VIP 0" *)
(* X_INTERFACE_INFO = "xilinx.com:interface:axis:1.0 M_AXIS TREADY" *)
input wire M_AXIS_TREADY;
(* X_INTERFACE_PARAMETER = "XIL_INTERFACENAME M_AXIS_ARESETN, POLARITY ACTIVE_LOW, INSERT_VIP 0" *)
(* X_INTERFACE_INFO = "xilinx.com:signal:reset:1.0 M_AXIS_ARESETN RST" *)
input wire M_AXIS_ARESETN;
input wire ms_en;
input wire [9 : 0] na;
input wire [9 : 0] nb;
input wire [15 : 0] na_1;
input wire [15 : 0] d_na;
input wire [15 : 0] peak_thd;
input wire [7 : 0] peak_thd_count;
input wire [7 : 0] peak_top_delay;
output wire [31 : 0] timer_counter;

  dmca_top #(
    .AXISTREAM_DATA_W(32),
    .REG_GLOBAL_LIMIT(300),
    .ADC_BIT(14),
    .CLK_FREQ_MHZ(80)
  ) inst (
    .sys_clk(sys_clk),
    .sys_rstn(sys_rstn),
    .adc_datain(adc_datain),
    .adc_dataout(adc_dataout),
    .adc_fir_datain(adc_fir_datain),
    .trapezd_data(trapezd_data),
    .triangle_data(triangle_data),
    .M_AXIS_TVALID(M_AXIS_TVALID),
    .M_AXIS_TDATA(M_AXIS_TDATA),
    .M_AXIS_TLAST(M_AXIS_TLAST),
    .M_AXIS_TREADY(M_AXIS_TREADY),
    .M_AXIS_ARESETN(M_AXIS_ARESETN),
    .ms_en(ms_en),
    .na(na),
    .nb(nb),
    .na_1(na_1),
    .d_na(d_na),
    .peak_thd(peak_thd),
    .peak_thd_count(peak_thd_count),
    .peak_top_delay(peak_top_delay),
    .timer_counter(timer_counter)
  );
endmodule
