StevekDon/NaI-Tl-scintillator-gamma-ray-Digital-Multi-Channel-Analyzer/firmware/vivado/zynq_dmca.gen/sources_1/bd/system/ip/system_axi_ctrl_0_0/system_axi_ctrl_0_0_stub.vhdl

-- Copyright 1986-2022 Xilinx, Inc. All Rights Reserved.
-- --------------------------------------------------------------------------------
-- Tool Version: Vivado v.2022.2 (win64) Build 3671981 Fri Oct 14 05:00:03 MDT 2022
-- Date        : Wed Jun  4 22:19:16 2025
-- Host        : Steve running 64-bit major release  (build 9200)
-- Command     : write_vhdl -force -mode synth_stub
--               c:/Users/Steve/Desktop/zynq7020/vivado_prj/zynq_dmca/zynq_dmca/zynq_dmca.gen/sources_1/bd/system/ip/system_axi_ctrl_0_0/system_axi_ctrl_0_0_stub.vhdl
-- Design      : system_axi_ctrl_0_0
-- Purpose     : Stub declaration of top-level module interface
-- Device      : xc7z020clg400-2
-- --------------------------------------------------------------------------------
library IEEE;
use IEEE.STD_LOGIC_1164.ALL;

entity system_axi_ctrl_0_0 is
  Port ( 
    s00_axi_aclk : in STD_LOGIC;
    s00_axi_aresetn : in STD_LOGIC;
    s00_axi_awaddr : in STD_LOGIC_VECTOR ( 4 downto 0 );
    s00_axi_awprot : in STD_LOGIC_VECTOR ( 2 downto 0 );
    s00_axi_awvalid : in STD_LOGIC;
    s00_axi_awready : out STD_LOGIC;
    s00_axi_wdata : in STD_LOGIC_VECTOR ( 31 downto 0 );
    s00_axi_wstrb : in STD_LOGIC_VECTOR ( 3 downto 0 );
    s00_axi_wvalid : in STD_LOGIC;
    s00_axi_wready : out STD_LOGIC;
    s00_axi_bresp : out STD_LOGIC_VECTOR ( 1 downto 0 );
    s00_axi_bvalid : out STD_LOGIC;
    s00_axi_bready : in STD_LOGIC;
    s00_axi_araddr : in STD_LOGIC_VECTOR ( 4 downto 0 );
    s00_axi_arprot : in STD_LOGIC_VECTOR ( 2 downto 0 );
    s00_axi_arvalid : in STD_LOGIC;
    s00_axi_arready : out STD_LOGIC;
    s00_axi_rdata : out STD_LOGIC_VECTOR ( 31 downto 0 );
    s00_axi_rresp : out STD_LOGIC_VECTOR ( 1 downto 0 );
    s00_axi_rvalid : out STD_LOGIC;
    s00_axi_rready : in STD_LOGIC;
    timer_counter : in STD_LOGIC_VECTOR ( 31 downto 0 );
    na : out STD_LOGIC_VECTOR ( 15 downto 0 );
    nb : out STD_LOGIC_VECTOR ( 15 downto 0 );
    na_1 : out STD_LOGIC_VECTOR ( 15 downto 0 );
    d_na : out STD_LOGIC_VECTOR ( 15 downto 0 );
    peak_thd : out STD_LOGIC_VECTOR ( 15 downto 0 );
    peak_thd_count : out STD_LOGIC_VECTOR ( 7 downto 0 );
    peak_top_delay : out STD_LOGIC_VECTOR ( 7 downto 0 );
    adc_pwr_en : out STD_LOGIC;
    ms_en : out STD_LOGIC
  );

end system_axi_ctrl_0_0;

architecture stub of system_axi_ctrl_0_0 is
attribute syn_black_box : boolean;
attribute black_box_pad_pin : string;
attribute syn_black_box of stub : architecture is true;
attribute black_box_pad_pin of stub : architecture is "s00_axi_aclk,s00_axi_aresetn,s00_axi_awaddr[4:0],s00_axi_awprot[2:0],s00_axi_awvalid,s00_axi_awready,s00_axi_wdata[31:0],s00_axi_wstrb[3:0],s00_axi_wvalid,s00_axi_wready,s00_axi_bresp[1:0],s00_axi_bvalid,s00_axi_bready,s00_axi_araddr[4:0],s00_axi_arprot[2:0],s00_axi_arvalid,s00_axi_arready,s00_axi_rdata[31:0],s00_axi_rresp[1:0],s00_axi_rvalid,s00_axi_rready,timer_counter[31:0],na[15:0],nb[15:0],na_1[15:0],d_na[15:0],peak_thd[15:0],peak_thd_count[7:0],peak_top_delay[7:0],adc_pwr_en,ms_en";
attribute X_CORE_INFO : string;
attribute X_CORE_INFO of stub : architecture is "axi_ctrl_v0_1_0,Vivado 2022.2";
begin
end;
