StevekDon/NaI-Tl-scintillator-gamma-ray-Digital-Multi-Channel-Analyzer/firmware/vivado/zynq_dmca.gen/sources_1/bd/system/ip/system_xlconcat_0_0/synth/system_xlconcat_0_0.v

// (c) Copyright 1995-2025 Xilinx, Inc. All rights reserved.
// 
// This file contains confidential and proprietary information
// of Xilinx, Inc. and is protected under U.S. and
// international copyright and other intellectual property
// laws.
// 
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
// CRITICAL APPLICATIONS
// Xilinx products are not designed or intended to be fail-
// safe, or for use in any application requiring fail-safe
// performance, such as life-support or safety devices or
// systems, Class III medical devices, nuclear facilities,
// applications related to the deployment of airbags, or any
// other applications that could lead to death, personal
// injury, or severe property or environmental damage
// (individually and collectively, "Critical
// Applications"). Customer assumes the sole risk and
// liability of any use of Xilinx products in Critical
// Applications, subject only to applicable laws and
// regulations governing limitations on product liability.
// 
// THIS COPYRIGHT NOTICE AND DISCLAIMER MUST BE RETAINED AS
// PART OF THIS FILE AT ALL TIMES.
// 
// DO NOT MODIFY THIS FILE.


// IP VLNV: xilinx.com:ip:xlconcat:2.1
// IP Revision: 4

(* X_CORE_INFO = "xlconcat_v2_1_4_xlconcat,Vivado 2022.2" *)
(* CHECK_LICENSE_TYPE = "system_xlconcat_0_0,xlconcat_v2_1_4_xlconcat,{}" *)
(* CORE_GENERATION_INFO = "system_xlconcat_0_0,xlconcat_v2_1_4_xlconcat,{x_ipProduct=Vivado 2022.2,x_ipVendor=xilinx.com,x_ipLibrary=ip,x_ipName=xlconcat,x_ipVersion=2.1,x_ipCoreRevision=4,x_ipLanguage=VERILOG,x_ipSimLanguage=MIXED,IN0_WIDTH=1,IN1_WIDTH=1,IN2_WIDTH=1,IN3_WIDTH=1,IN4_WIDTH=1,IN5_WIDTH=1,IN6_WIDTH=1,IN7_WIDTH=1,IN8_WIDTH=1,IN9_WIDTH=1,IN10_WIDTH=1,IN11_WIDTH=1,IN12_WIDTH=1,IN13_WIDTH=1,IN14_WIDTH=1,IN15_WIDTH=1,IN16_WIDTH=1,IN17_WIDTH=1,IN18_WIDTH=1,IN19_WIDTH=1,IN20_WIDTH=1,IN21_WIDTH=1,IN22_WIDTH=1,IN23_W\
IDTH=1,IN24_WIDTH=1,IN25_WIDTH=1,IN26_WIDTH=1,IN27_WIDTH=1,IN28_WIDTH=1,IN29_WIDTH=1,IN30_WIDTH=1,IN31_WIDTH=1,IN32_WIDTH=1,IN33_WIDTH=1,IN34_WIDTH=1,IN35_WIDTH=1,IN36_WIDTH=1,IN37_WIDTH=1,IN38_WIDTH=1,IN39_WIDTH=1,IN40_WIDTH=1,IN41_WIDTH=1,IN42_WIDTH=1,IN43_WIDTH=1,IN44_WIDTH=1,IN45_WIDTH=1,IN46_WIDTH=1,IN47_WIDTH=1,IN48_WIDTH=1,IN49_WIDTH=1,IN50_WIDTH=1,IN51_WIDTH=1,IN52_WIDTH=1,IN53_WIDTH=1,IN54_WIDTH=1,IN55_WIDTH=1,IN56_WIDTH=1,IN57_WIDTH=1,IN58_WIDTH=1,IN59_WIDTH=1,IN60_WIDTH=1,IN61_WIDTH=1\
,IN62_WIDTH=1,IN63_WIDTH=1,IN64_WIDTH=1,IN65_WIDTH=1,IN66_WIDTH=1,IN67_WIDTH=1,IN68_WIDTH=1,IN69_WIDTH=1,IN70_WIDTH=1,IN71_WIDTH=1,IN72_WIDTH=1,IN73_WIDTH=1,IN74_WIDTH=1,IN75_WIDTH=1,IN76_WIDTH=1,IN77_WIDTH=1,IN78_WIDTH=1,IN79_WIDTH=1,IN80_WIDTH=1,IN81_WIDTH=1,IN82_WIDTH=1,IN83_WIDTH=1,IN84_WIDTH=1,IN85_WIDTH=1,IN86_WIDTH=1,IN87_WIDTH=1,IN88_WIDTH=1,IN89_WIDTH=1,IN90_WIDTH=1,IN91_WIDTH=1,IN92_WIDTH=1,IN93_WIDTH=1,IN94_WIDTH=1,IN95_WIDTH=1,IN96_WIDTH=1,IN97_WIDTH=1,IN98_WIDTH=1,IN99_WIDTH=1,IN100\
_WIDTH=1,IN101_WIDTH=1,IN102_WIDTH=1,IN103_WIDTH=1,IN104_WIDTH=1,IN105_WIDTH=1,IN106_WIDTH=1,IN107_WIDTH=1,IN108_WIDTH=1,IN109_WIDTH=1,IN110_WIDTH=1,IN111_WIDTH=1,IN112_WIDTH=1,IN113_WIDTH=1,IN114_WIDTH=1,IN115_WIDTH=1,IN116_WIDTH=1,IN117_WIDTH=1,IN118_WIDTH=1,IN119_WIDTH=1,IN120_WIDTH=1,IN121_WIDTH=1,IN122_WIDTH=1,IN123_WIDTH=1,IN124_WIDTH=1,IN125_WIDTH=1,IN126_WIDTH=1,IN127_WIDTH=1,dout_width=2,NUM_PORTS=2}" *)
(* DowngradeIPIdentifiedWarnings = "yes" *)
module system_xlconcat_0_0 (
  In0,
  In1,
  dout
);

input wire [0 : 0] In0;
input wire [0 : 0] In1;
output wire [1 : 0] dout;

  xlconcat_v2_1_4_xlconcat #(
    .IN0_WIDTH(1),
    .IN1_WIDTH(1),
    .IN2_WIDTH(1),
    .IN3_WIDTH(1),
    .IN4_WIDTH(1),
    .IN5_WIDTH(1),
    .IN6_WIDTH(1),
    .IN7_WIDTH(1),
    .IN8_WIDTH(1),
    .IN9_WIDTH(1),
    .IN10_WIDTH(1),
    .IN11_WIDTH(1),
    .IN12_WIDTH(1),
    .IN13_WIDTH(1),
    .IN14_WIDTH(1),
    .IN15_WIDTH(1),
    .IN16_WIDTH(1),
    .IN17_WIDTH(1),
    .IN18_WIDTH(1),
    .IN19_WIDTH(1),
    .IN20_WIDTH(1),
    .IN21_WIDTH(1),
    .IN22_WIDTH(1),
    .IN23_WIDTH(1),
    .IN24_WIDTH(1),
    .IN25_WIDTH(1),
    .IN26_WIDTH(1),
    .IN27_WIDTH(1),
    .IN28_WIDTH(1),
    .IN29_WIDTH(1),
    .IN30_WIDTH(1),
    .IN31_WIDTH(1),
    .IN32_WIDTH(1),
    .IN33_WIDTH(1),
    .IN34_WIDTH(1),
    .IN35_WIDTH(1),
    .IN36_WIDTH(1),
    .IN37_WIDTH(1),
    .IN38_WIDTH(1),
    .IN39_WIDTH(1),
    .IN40_WIDTH(1),
    .IN41_WIDTH(1),
    .IN42_WIDTH(1),
    .IN43_WIDTH(1),
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
    .In114(1'B0),
    .In115(1'B0),
    .In116(1'B0),
    .In117(1'B0),
    .In118(1'B0),
    .In119(1'B0),
    .In120(1'B0),
    .In121(1'B0),
    .In122(1'B0),
    .In123(1'B0),
    .In124(1'B0),
    .In125(1'B0),
    .In126(1'B0),
    .In127(1'B0),
    .dout(dout)
  );
endmodule
