StevekDon/NaI-Tl-scintillator-gamma-ray-Digital-Multi-Channel-Analyzer/firmware/vivado/zynq_dmca.gen/sources_1/bd/system/synth/system.v

//Copyright 1986-2022 Xilinx, Inc. All Rights Reserved.
//--------------------------------------------------------------------------------
//Tool Version: Vivado v.2022.2 (win64) Build 3671981 Fri Oct 14 05:00:03 MDT 2022
//Date        : Sun Jul  6 14:56:05 2025
//Host        : Steve running 64-bit major release  (build 9200)
//Command     : generate_target system.bd
//Design      : system
//Purpose     : IP block netlist
//--------------------------------------------------------------------------------
`timescale 1 ps / 1 ps

module m00_couplers_imp_1H7AUOX
   (M_ACLK,
    M_ARESETN,
    M_AXI_araddr,
    M_AXI_arready,
    M_AXI_arvalid,
    M_AXI_awaddr,
    M_AXI_awready,
    M_AXI_awvalid,
    M_AXI_bready,
    M_AXI_bresp,
    M_AXI_bvalid,
    M_AXI_rdata,
    M_AXI_rready,
    M_AXI_rresp,
    M_AXI_rvalid,
    M_AXI_wdata,
    M_AXI_wready,
    M_AXI_wvalid,
    S_ACLK,
    S_ARESETN,
    S_AXI_araddr,
    S_AXI_arready,
    S_AXI_arvalid,
    S_AXI_awaddr,
    S_AXI_awready,
    S_AXI_awvalid,
    S_AXI_bready,
    S_AXI_bresp,
    S_AXI_bvalid,
    S_AXI_rdata,
    S_AXI_rready,
    S_AXI_rresp,
    S_AXI_rvalid,
    S_AXI_wdata,
    S_AXI_wready,
    S_AXI_wvalid);
  input M_ACLK;
  input M_ARESETN;
  output [31:0]M_AXI_araddr;
  input [0:0]M_AXI_arready;
  output [0:0]M_AXI_arvalid;
  output [31:0]M_AXI_awaddr;
  input [0:0]M_AXI_awready;
  output [0:0]M_AXI_awvalid;
  output [0:0]M_AXI_bready;
  input [1:0]M_AXI_bresp;
  input [0:0]M_AXI_bvalid;
  input [31:0]M_AXI_rdata;
  output [0:0]M_AXI_rready;
  input [1:0]M_AXI_rresp;
  input [0:0]M_AXI_rvalid;
  output [31:0]M_AXI_wdata;
  input [0:0]M_AXI_wready;
  output [0:0]M_AXI_wvalid;
  input S_ACLK;
  input S_ARESETN;
  input [31:0]S_AXI_araddr;
  output [0:0]S_AXI_arready;
  input [0:0]S_AXI_arvalid;
  input [31:0]S_AXI_awaddr;
  output [0:0]S_AXI_awready;
  input [0:0]S_AXI_awvalid;
  input [0:0]S_AXI_bready;
  output [1:0]S_AXI_bresp;
  output [0:0]S_AXI_bvalid;
  output [31:0]S_AXI_rdata;
  input [0:0]S_AXI_rready;
  output [1:0]S_AXI_rresp;
  output [0:0]S_AXI_rvalid;
  input [31:0]S_AXI_wdata;
  output [0:0]S_AXI_wready;
  input [0:0]S_AXI_wvalid;

  wire [31:0]m00_couplers_to_m00_couplers_ARADDR;
  wire [0:0]m00_couplers_to_m00_couplers_ARREADY;
  wire [0:0]m00_couplers_to_m00_couplers_ARVALID;
  wire [31:0]m00_couplers_to_m00_couplers_AWADDR;
  wire [0:0]m00_couplers_to_m00_couplers_AWREADY;
  wire [0:0]m00_couplers_to_m00_couplers_AWVALID;
  wire [0:0]m00_couplers_to_m00_couplers_BREADY;
  wire [1:0]m00_couplers_to_m00_couplers_BRESP;
  wire [0:0]m00_couplers_to_m00_couplers_BVALID;
  wire [31:0]m00_couplers_to_m00_couplers_RDATA;
  wire [0:0]m00_couplers_to_m00_couplers_RREADY;
  wire [1:0]m00_couplers_to_m00_couplers_RRESP;
  wire [0:0]m00_couplers_to_m00_couplers_RVALID;
  wire [31:0]m00_couplers_to_m00_couplers_WDATA;
  wire [0:0]m00_couplers_to_m00_couplers_WREADY;
  wire [0:0]m00_couplers_to_m00_couplers_WVALID;

  assign M_AXI_araddr[31:0] = m00_couplers_to_m00_couplers_ARADDR;
  assign M_AXI_arvalid[0] = m00_couplers_to_m00_couplers_ARVALID;
  assign M_AXI_awaddr[31:0] = m00_couplers_to_m00_couplers_AWADDR;
  assign M_AXI_awvalid[0] = m00_couplers_to_m00_couplers_AWVALID;
  assign M_AXI_bready[0] = m00_couplers_to_m00_couplers_BREADY;
  assign M_AXI_rready[0] = m00_couplers_to_m00_couplers_RREADY;
  assign M_AXI_wdata[31:0] = m00_couplers_to_m00_couplers_WDATA;
  assign M_AXI_wvalid[0] = m00_couplers_to_m00_couplers_WVALID;
  assign S_AXI_arready[0] = m00_couplers_to_m00_couplers_ARREADY;
  assign S_AXI_awready[0] = m00_couplers_to_m00_couplers_AWREADY;
  assign S_AXI_bresp[1:0] = m00_couplers_to_m00_couplers_BRESP;
  assign S_AXI_bvalid[0] = m00_couplers_to_m00_couplers_BVALID;
  assign S_AXI_rdata[31:0] = m00_couplers_to_m00_couplers_RDATA;
  assign S_AXI_rresp[1:0] = m00_couplers_to_m00_couplers_RRESP;
  assign S_AXI_rvalid[0] = m00_couplers_to_m00_couplers_RVALID;
  assign S_AXI_wready[0] = m00_couplers_to_m00_couplers_WREADY;
  assign m00_couplers_to_m00_couplers_ARADDR = S_AXI_araddr[31:0];
  assign m00_couplers_to_m00_couplers_ARREADY = M_AXI_arready[0];
  assign m00_couplers_to_m00_couplers_ARVALID = S_AXI_arvalid[0];
  assign m00_couplers_to_m00_couplers_AWADDR = S_AXI_awaddr[31:0];
  assign m00_couplers_to_m00_couplers_AWREADY = M_AXI_awready[0];
  assign m00_couplers_to_m00_couplers_AWVALID = S_AXI_awvalid[0];
  assign m00_couplers_to_m00_couplers_BREADY = S_AXI_bready[0];
  assign m00_couplers_to_m00_couplers_BRESP = M_AXI_bresp[1:0];
  assign m00_couplers_to_m00_couplers_BVALID = M_AXI_bvalid[0];
  assign m00_couplers_to_m00_couplers_RDATA = M_AXI_rdata[31:0];
  assign m00_couplers_to_m00_couplers_RREADY = S_AXI_rready[0];
  assign m00_couplers_to_m00_couplers_RRESP = M_AXI_rresp[1:0];
  assign m00_couplers_to_m00_couplers_RVALID = M_AXI_rvalid[0];
  assign m00_couplers_to_m00_couplers_WDATA = S_AXI_wdata[31:0];
  assign m00_couplers_to_m00_couplers_WREADY = M_AXI_wready[0];
  assign m00_couplers_to_m00_couplers_WVALID = S_AXI_wvalid[0];
endmodule

module m01_couplers_imp_4Y7TYO
   (M_ACLK,
    M_ARESETN,
    M_AXI_araddr,
    M_AXI_arready,
    M_AXI_arvalid,
    M_AXI_awaddr,
    M_AXI_awready,
    M_AXI_awvalid,
    M_AXI_bready,
    M_AXI_bresp,
    M_AXI_bvalid,
    M_AXI_rdata,
    M_AXI_rready,
    M_AXI_rresp,
    M_AXI_rvalid,
    M_AXI_wdata,
    M_AXI_wready,
    M_AXI_wstrb,
    M_AXI_wvalid,
    S_ACLK,
    S_ARESETN,
    S_AXI_araddr,
    S_AXI_arready,
    S_AXI_arvalid,
    S_AXI_awaddr,
    S_AXI_awready,
    S_AXI_awvalid,
    S_AXI_bready,
    S_AXI_bresp,
    S_AXI_bvalid,
    S_AXI_rdata,
    S_AXI_rready,
    S_AXI_rresp,
    S_AXI_rvalid,
    S_AXI_wdata,
    S_AXI_wready,
    S_AXI_wstrb,
    S_AXI_wvalid);
  input M_ACLK;
  input M_ARESETN;
  output [31:0]M_AXI_araddr;
  input [0:0]M_AXI_arready;
  output [0:0]M_AXI_arvalid;
  output [31:0]M_AXI_awaddr;
  input [0:0]M_AXI_awready;
  output [0:0]M_AXI_awvalid;
  output [0:0]M_AXI_bready;
  input [1:0]M_AXI_bresp;
  input [0:0]M_AXI_bvalid;
  input [31:0]M_AXI_rdata;
  output [0:0]M_AXI_rready;
  input [1:0]M_AXI_rresp;
  input [0:0]M_AXI_rvalid;
  output [31:0]M_AXI_wdata;
  input [0:0]M_AXI_wready;
  output [3:0]M_AXI_wstrb;
  output [0:0]M_AXI_wvalid;
  input S_ACLK;
  input S_ARESETN;
  input [31:0]S_AXI_araddr;
  output [0:0]S_AXI_arready;
  input [0:0]S_AXI_arvalid;
  input [31:0]S_AXI_awaddr;
  output [0:0]S_AXI_awready;
  input [0:0]S_AXI_awvalid;
  input [0:0]S_AXI_bready;
  output [1:0]S_AXI_bresp;
  output [0:0]S_AXI_bvalid;
  output [31:0]S_AXI_rdata;
  input [0:0]S_AXI_rready;
  output [1:0]S_AXI_rresp;
  output [0:0]S_AXI_rvalid;
  input [31:0]S_AXI_wdata;
  output [0:0]S_AXI_wready;
  input [3:0]S_AXI_wstrb;
  input [0:0]S_AXI_wvalid;

  wire [31:0]m01_couplers_to_m01_couplers_ARADDR;
  wire [0:0]m01_couplers_to_m01_couplers_ARREADY;
  wire [0:0]m01_couplers_to_m01_couplers_ARVALID;
  wire [31:0]m01_couplers_to_m01_couplers_AWADDR;
  wire [0:0]m01_couplers_to_m01_couplers_AWREADY;
  wire [0:0]m01_couplers_to_m01_couplers_AWVALID;
  wire [0:0]m01_couplers_to_m01_couplers_BREADY;
  wire [1:0]m01_couplers_to_m01_couplers_BRESP;
  wire [0:0]m01_couplers_to_m01_couplers_BVALID;
  wire [31:0]m01_couplers_to_m01_couplers_RDATA;
  wire [0:0]m01_couplers_to_m01_couplers_RREADY;
  wire [1:0]m01_couplers_to_m01_couplers_RRESP;
  wire [0:0]m01_couplers_to_m01_couplers_RVALID;
  wire [31:0]m01_couplers_to_m01_couplers_WDATA;
  wire [0:0]m01_couplers_to_m01_couplers_WREADY;
  wire [3:0]m01_couplers_to_m01_couplers_WSTRB;
  wire [0:0]m01_couplers_to_m01_couplers_WVALID;

  assign M_AXI_araddr[31:0] = m01_couplers_to_m01_couplers_ARADDR;
  assign M_AXI_arvalid[0] = m01_couplers_to_m01_couplers_ARVALID;
  assign M_AXI_awaddr[31:0] = m01_couplers_to_m01_couplers_AWADDR;
  assign M_AXI_awvalid[0] = m01_couplers_to_m01_couplers_AWVALID;
  assign M_AXI_bready[0] = m01_couplers_to_m01_couplers_BREADY;
  assign M_AXI_rready[0] = m01_couplers_to_m01_couplers_RREADY;
  assign M_AXI_wdata[31:0] = m01_couplers_to_m01_couplers_WDATA;
  assign M_AXI_wstrb[3:0] = m01_couplers_to_m01_couplers_WSTRB;
  assign M_AXI_wvalid[0] = m01_couplers_to_m01_couplers_WVALID;
  assign S_AXI_arready[0] = m01_couplers_to_m01_couplers_ARREADY;
  assign S_AXI_awready[0] = m01_couplers_to_m01_couplers_AWREADY;
  assign S_AXI_bresp[1:0] = m01_couplers_to_m01_couplers_BRESP;
  assign S_AXI_bvalid[0] = m01_couplers_to_m01_couplers_BVALID;
  assign S_AXI_rdata[31:0] = m01_couplers_to_m01_couplers_RDATA;
  assign S_AXI_rresp[1:0] = m01_couplers_to_m01_couplers_RRESP;
  assign S_AXI_rvalid[0] = m01_couplers_to_m01_couplers_RVALID;
  assign S_AXI_wready[0] = m01_couplers_to_m01_couplers_WREADY;
  assign m01_couplers_to_m01_couplers_ARADDR = S_AXI_araddr[31:0];
  assign m01_couplers_to_m01_couplers_ARREADY = M_AXI_arready[0];
  assign m01_couplers_to_m01_couplers_ARVALID = S_AXI_arvalid[0];
  assign m01_couplers_to_m01_couplers_AWADDR = S_AXI_awaddr[31:0];
  assign m01_couplers_to_m01_couplers_AWREADY = M_AXI_awready[0];
  assign m01_couplers_to_m01_couplers_AWVALID = S_AXI_awvalid[0];
  assign m01_couplers_to_m01_couplers_BREADY = S_AXI_bready[0];
  assign m01_couplers_to_m01_couplers_BRESP = M_AXI_bresp[1:0];
  assign m01_couplers_to_m01_couplers_BVALID = M_AXI_bvalid[0];
  assign m01_couplers_to_m01_couplers_RDATA = M_AXI_rdata[31:0];
  assign m01_couplers_to_m01_couplers_RREADY = S_AXI_rready[0];
  assign m01_couplers_to_m01_couplers_RRESP = M_AXI_rresp[1:0];
  assign m01_couplers_to_m01_couplers_RVALID = M_AXI_rvalid[0];
  assign m01_couplers_to_m01_couplers_WDATA = S_AXI_wdata[31:0];
  assign m01_couplers_to_m01_couplers_WREADY = M_AXI_wready[0];
  assign m01_couplers_to_m01_couplers_WSTRB = S_AXI_wstrb[3:0];
  assign m01_couplers_to_m01_couplers_WVALID = S_AXI_wvalid[0];
endmodule

module m02_couplers_imp_FKL2TE
   (M_ACLK,
    M_ARESETN,
    M_AXI_araddr,
    M_AXI_arprot,
    M_AXI_arready,
    M_AXI_arvalid,
    M_AXI_awaddr,
    M_AXI_awprot,
    M_AXI_awready,
    M_AXI_awvalid,
    M_AXI_bready,
    M_AXI_bresp,
    M_AXI_bvalid,
    M_AXI_rdata,
    M_AXI_rready,
    M_AXI_rresp,
    M_AXI_rvalid,
    M_AXI_wdata,
    M_AXI_wready,
    M_AXI_wstrb,
    M_AXI_wvalid,
    S_ACLK,
    S_ARESETN,
    S_AXI_araddr,
    S_AXI_arprot,
    S_AXI_arready,
    S_AXI_arvalid,
    S_AXI_awaddr,
    S_AXI_awprot,
    S_AXI_awready,
    S_AXI_awvalid,
    S_AXI_bready,
    S_AXI_bresp,
    S_AXI_bvalid,
    S_AXI_rdata,
    S_AXI_rready,
    S_AXI_rresp,
    S_AXI_rvalid,
    S_AXI_wdata,
    S_AXI_wready,
    S_AXI_wstrb,
    S_AXI_wvalid);
  input M_ACLK;
  input M_ARESETN;
  output [31:0]M_AXI_araddr;
  output [2:0]M_AXI_arprot;
  input M_AXI_arready;
  output M_AXI_arvalid;
  output [31:0]M_AXI_awaddr;
  output [2:0]M_AXI_awprot;
  input M_AXI_awready;
  output M_AXI_awvalid;
  output M_AXI_bready;
  input [1:0]M_AXI_bresp;
  input M_AXI_bvalid;
  input [31:0]M_AXI_rdata;
  output M_AXI_rready;
  input [1:0]M_AXI_rresp;
  input M_AXI_rvalid;
  output [31:0]M_AXI_wdata;
  input M_AXI_wready;
  output [3:0]M_AXI_wstrb;
  output M_AXI_wvalid;
  input S_ACLK;
  input S_ARESETN;
  input [31:0]S_AXI_araddr;
  input [2:0]S_AXI_arprot;
  output S_AXI_arready;
  input S_AXI_arvalid;
  input [31:0]S_AXI_awaddr;
  input [2:0]S_AXI_awprot;
  output S_AXI_awready;
  input S_AXI_awvalid;
  input S_AXI_bready;
  output [1:0]S_AXI_bresp;
  output S_AXI_bvalid;
  output [31:0]S_AXI_rdata;
  input S_AXI_rready;
  output [1:0]S_AXI_rresp;
  output S_AXI_rvalid;
  input [31:0]S_AXI_wdata;
  output S_AXI_wready;
  input [3:0]S_AXI_wstrb;
  input S_AXI_wvalid;

  wire [31:0]m02_couplers_to_m02_couplers_ARADDR;
  wire [2:0]m02_couplers_to_m02_couplers_ARPROT;
  wire m02_couplers_to_m02_couplers_ARREADY;
  wire m02_couplers_to_m02_couplers_ARVALID;
  wire [31:0]m02_couplers_to_m02_couplers_AWADDR;
  wire [2:0]m02_couplers_to_m02_couplers_AWPROT;
  wire m02_couplers_to_m02_couplers_AWREADY;
  wire m02_couplers_to_m02_couplers_AWVALID;
  wire m02_couplers_to_m02_couplers_BREADY;
  wire [1:0]m02_couplers_to_m02_couplers_BRESP;
  wire m02_couplers_to_m02_couplers_BVALID;
  wire [31:0]m02_couplers_to_m02_couplers_RDATA;
  wire m02_couplers_to_m02_couplers_RREADY;
  wire [1:0]m02_couplers_to_m02_couplers_RRESP;
  wire m02_couplers_to_m02_couplers_RVALID;
  wire [31:0]m02_couplers_to_m02_couplers_WDATA;
  wire m02_couplers_to_m02_couplers_WREADY;
  wire [3:0]m02_couplers_to_m02_couplers_WSTRB;
  wire m02_couplers_to_m02_couplers_WVALID;

  assign M_AXI_araddr[31:0] = m02_couplers_to_m02_couplers_ARADDR;
  assign M_AXI_arprot[2:0] = m02_couplers_to_m02_couplers_ARPROT;
  assign M_AXI_arvalid = m02_couplers_to_m02_couplers_ARVALID;
  assign M_AXI_awaddr[31:0] = m02_couplers_to_m02_couplers_AWADDR;
  assign M_AXI_awprot[2:0] = m02_couplers_to_m02_couplers_AWPROT;
  assign M_AXI_awvalid = m02_couplers_to_m02_couplers_AWVALID;
  assign M_AXI_bready = m02_couplers_to_m02_couplers_BREADY;
  assign M_AXI_rready = m02_couplers_to_m02_couplers_RREADY;
  assign M_AXI_wdata[31:0] = m02_couplers_to_m02_couplers_WDATA;
  assign M_AXI_wstrb[3:0] = m02_couplers_to_m02_couplers_WSTRB;
  assign M_AXI_wvalid = m02_couplers_to_m02_couplers_WVALID;
  assign S_AXI_arready = m02_couplers_to_m02_couplers_ARREADY;
  assign S_AXI_awready = m02_couplers_to_m02_couplers_AWREADY;
  assign S_AXI_bresp[1:0] = m02_couplers_to_m02_couplers_BRESP;
  assign S_AXI_bvalid = m02_couplers_to_m02_couplers_BVALID;
  assign S_AXI_rdata[31:0] = m02_couplers_to_m02_couplers_RDATA;
  assign S_AXI_rresp[1:0] = m02_couplers_to_m02_couplers_RRESP;
  assign S_AXI_rvalid = m02_couplers_to_m02_couplers_RVALID;
  assign S_AXI_wready = m02_couplers_to_m02_couplers_WREADY;
  assign m02_couplers_to_m02_couplers_ARADDR = S_AXI_araddr[31:0];
  assign m02_couplers_to_m02_couplers_ARPROT = S_AXI_arprot[2:0];
  assign m02_couplers_to_m02_couplers_ARREADY = M_AXI_arready;
  assign m02_couplers_to_m02_couplers_ARVALID = S_AXI_arvalid;
  assign m02_couplers_to_m02_couplers_AWADDR = S_AXI_awaddr[31:0];
  assign m02_couplers_to_m02_couplers_AWPROT = S_AXI_awprot[2:0];
  assign m02_couplers_to_m02_couplers_AWREADY = M_AXI_awready;
  assign m02_couplers_to_m02_couplers_AWVALID = S_AXI_awvalid;
  assign m02_couplers_to_m02_couplers_BREADY = S_AXI_bready;
  assign m02_couplers_to_m02_couplers_BRESP = M_AXI_bresp[1:0];
  assign m02_couplers_to_m02_couplers_BVALID = M_AXI_bvalid;
  assign m02_couplers_to_m02_couplers_RDATA = M_AXI_rdata[31:0];
  assign m02_couplers_to_m02_couplers_RREADY = S_AXI_rready;
  assign m02_couplers_to_m02_couplers_RRESP = M_AXI_rresp[1:0];
  assign m02_couplers_to_m02_couplers_RVALID = M_AXI_rvalid;
  assign m02_couplers_to_m02_couplers_WDATA = S_AXI_wdata[31:0];
  assign m02_couplers_to_m02_couplers_WREADY = M_AXI_wready;
  assign m02_couplers_to_m02_couplers_WSTRB = S_AXI_wstrb[3:0];
  assign m02_couplers_to_m02_couplers_WVALID = S_AXI_wvalid;
endmodule

module s00_couplers_imp_11SE3QO
   (M_ACLK,
    M_ARESETN,
    M_AXI_araddr,
    M_AXI_arprot,
    M_AXI_arready,
    M_AXI_arvalid,
    M_AXI_awaddr,
    M_AXI_awprot,
    M_AXI_awready,
    M_AXI_awvalid,
    M_AXI_bready,
    M_AXI_bresp,
    M_AXI_bvalid,
    M_AXI_rdata,
    M_AXI_rready,
    M_AXI_rresp,
    M_AXI_rvalid,
    M_AXI_wdata,
    M_AXI_wready,
    M_AXI_wstrb,
    M_AXI_wvalid,
    S_ACLK,
    S_ARESETN,
    S_AXI_araddr,
    S_AXI_arburst,
    S_AXI_arcache,
    S_AXI_arlen,
    S_AXI_arlock,
    S_AXI_arprot,
    S_AXI_arqos,
    S_AXI_arready,
    S_AXI_arsize,
    S_AXI_arvalid,
    S_AXI_awaddr,
    S_AXI_awburst,
    S_AXI_awcache,
    S_AXI_awlen,
    S_AXI_awlock,
    S_AXI_awprot,
    S_AXI_awqos,
    S_AXI_awready,
    S_AXI_awsize,
    S_AXI_awvalid,
    S_AXI_bready,
    S_AXI_bresp,
    S_AXI_bvalid,
    S_AXI_rdata,
    S_AXI_rlast,
    S_AXI_rready,
    S_AXI_rresp,
    S_AXI_rvalid,
    S_AXI_wdata,
    S_AXI_wlast,
    S_AXI_wready,
    S_AXI_wstrb,
    S_AXI_wvalid);
  input M_ACLK;
  input M_ARESETN;
  output [31:0]M_AXI_araddr;
  output [2:0]M_AXI_arprot;
  input M_AXI_arready;
  output M_AXI_arvalid;
  output [31:0]M_AXI_awaddr;
  output [2:0]M_AXI_awprot;
  input M_AXI_awready;
  output M_AXI_awvalid;
  output M_AXI_bready;
  input [1:0]M_AXI_bresp;
  input M_AXI_bvalid;
  input [31:0]M_AXI_rdata;
  output M_AXI_rready;
  input [1:0]M_AXI_rresp;
  input M_AXI_rvalid;
  output [31:0]M_AXI_wdata;
  input M_AXI_wready;
  output [3:0]M_AXI_wstrb;
  output M_AXI_wvalid;
  input S_ACLK;
  input S_ARESETN;
  input [31:0]S_AXI_araddr;
  input [1:0]S_AXI_arburst;
  input [3:0]S_AXI_arcache;
  input [3:0]S_AXI_arlen;
  input [1:0]S_AXI_arlock;
  input [2:0]S_AXI_arprot;
  input [3:0]S_AXI_arqos;
  output S_AXI_arready;
  input [2:0]S_AXI_arsize;
  input S_AXI_arvalid;
  input [31:0]S_AXI_awaddr;
  input [1:0]S_AXI_awburst;
  input [3:0]S_AXI_awcache;
  input [3:0]S_AXI_awlen;
  input [1:0]S_AXI_awlock;
  input [2:0]S_AXI_awprot;
  input [3:0]S_AXI_awqos;
  output S_AXI_awready;
  input [2:0]S_AXI_awsize;
  input S_AXI_awvalid;
  input S_AXI_bready;
  output [1:0]S_AXI_bresp;
  output S_AXI_bvalid;
  output [31:0]S_AXI_rdata;
  output S_AXI_rlast;
  input S_AXI_rready;
  output [1:0]S_AXI_rresp;
  output S_AXI_rvalid;
  input [31:0]S_AXI_wdata;
  input S_AXI_wlast;
  output S_AXI_wready;
  input [3:0]S_AXI_wstrb;
  input S_AXI_wvalid;

  wire S_ACLK_1;
  wire S_ARESETN_1;
  wire [31:0]auto_pc_to_s00_couplers_ARADDR;
  wire [2:0]auto_pc_to_s00_couplers_ARPROT;
  wire auto_pc_to_s00_couplers_ARREADY;
  wire auto_pc_to_s00_couplers_ARVALID;
  wire [31:0]auto_pc_to_s00_couplers_AWADDR;
  wire [2:0]auto_pc_to_s00_couplers_AWPROT;
  wire auto_pc_to_s00_couplers_AWREADY;
  wire auto_pc_to_s00_couplers_AWVALID;
  wire auto_pc_to_s00_couplers_BREADY;
  wire [1:0]auto_pc_to_s00_couplers_BRESP;
  wire auto_pc_to_s00_couplers_BVALID;
  wire [31:0]auto_pc_to_s00_couplers_RDATA;
  wire auto_pc_to_s00_couplers_RREADY;
  wire [1:0]auto_pc_to_s00_couplers_RRESP;
  wire auto_pc_to_s00_couplers_RVALID;
  wire [31:0]auto_pc_to_s00_couplers_WDATA;
  wire auto_pc_to_s00_couplers_WREADY;
  wire [3:0]auto_pc_to_s00_couplers_WSTRB;
  wire auto_pc_to_s00_couplers_WVALID;
  wire [31:0]s00_couplers_to_auto_pc_ARADDR;
  wire [1:0]s00_couplers_to_auto_pc_ARBURST;
  wire [3:0]s00_couplers_to_auto_pc_ARCACHE;
  wire [3:0]s00_couplers_to_auto_pc_ARLEN;
  wire [1:0]s00_couplers_to_auto_pc_ARLOCK;
  wire [2:0]s00_couplers_to_auto_pc_ARPROT;
  wire [3:0]s00_couplers_to_auto_pc_ARQOS;
  wire s00_couplers_to_auto_pc_ARREADY;
  wire [2:0]s00_couplers_to_auto_pc_ARSIZE;
  wire s00_couplers_to_auto_pc_ARVALID;
  wire [31:0]s00_couplers_to_auto_pc_AWADDR;
  wire [1:0]s00_couplers_to_auto_pc_AWBURST;
  wire [3:0]s00_couplers_to_auto_pc_AWCACHE;
  wire [3:0]s00_couplers_to_auto_pc_AWLEN;
  wire [1:0]s00_couplers_to_auto_pc_AWLOCK;
  wire [2:0]s00_couplers_to_auto_pc_AWPROT;
  wire [3:0]s00_couplers_to_auto_pc_AWQOS;
  wire s00_couplers_to_auto_pc_AWREADY;
  wire [2:0]s00_couplers_to_auto_pc_AWSIZE;
  wire s00_couplers_to_auto_pc_AWVALID;
  wire s00_couplers_to_auto_pc_BREADY;
  wire [1:0]s00_couplers_to_auto_pc_BRESP;
  wire s00_couplers_to_auto_pc_BVALID;
  wire [31:0]s00_couplers_to_auto_pc_RDATA;
  wire s00_couplers_to_auto_pc_RLAST;
  wire s00_couplers_to_auto_pc_RREADY;
  wire [1:0]s00_couplers_to_auto_pc_RRESP;
  wire s00_couplers_to_auto_pc_RVALID;
  wire [31:0]s00_couplers_to_auto_pc_WDATA;
  wire s00_couplers_to_auto_pc_WLAST;
  wire s00_couplers_to_auto_pc_WREADY;
  wire [3:0]s00_couplers_to_auto_pc_WSTRB;
  wire s00_couplers_to_auto_pc_WVALID;

  assign M_AXI_araddr[31:0] = auto_pc_to_s00_couplers_ARADDR;
  assign M_AXI_arprot[2:0] = auto_pc_to_s00_couplers_ARPROT;
  assign M_AXI_arvalid = auto_pc_to_s00_couplers_ARVALID;
  assign M_AXI_awaddr[31:0] = auto_pc_to_s00_couplers_AWADDR;
  assign M_AXI_awprot[2:0] = auto_pc_to_s00_couplers_AWPROT;
  assign M_AXI_awvalid = auto_pc_to_s00_couplers_AWVALID;
  assign M_AXI_bready = auto_pc_to_s00_couplers_BREADY;
  assign M_AXI_rready = auto_pc_to_s00_couplers_RREADY;
  assign M_AXI_wdata[31:0] = auto_pc_to_s00_couplers_WDATA;
  assign M_AXI_wstrb[3:0] = auto_pc_to_s00_couplers_WSTRB;
  assign M_AXI_wvalid = auto_pc_to_s00_couplers_WVALID;
  assign S_ACLK_1 = S_ACLK;
  assign S_ARESETN_1 = S_ARESETN;
  assign S_AXI_arready = s00_couplers_to_auto_pc_ARREADY;
  assign S_AXI_awready = s00_couplers_to_auto_pc_AWREADY;
  assign S_AXI_bresp[1:0] = s00_couplers_to_auto_pc_BRESP;
  assign S_AXI_bvalid = s00_couplers_to_auto_pc_BVALID;
  assign S_AXI_rdata[31:0] = s00_couplers_to_auto_pc_RDATA;
  assign S_AXI_rlast = s00_couplers_to_auto_pc_RLAST;
  assign S_AXI_rresp[1:0] = s00_couplers_to_auto_pc_RRESP;
  assign S_AXI_rvalid = s00_couplers_to_auto_pc_RVALID;
  assign S_AXI_wready = s00_couplers_to_auto_pc_WREADY;
  assign auto_pc_to_s00_couplers_ARREADY = M_AXI_arready;
  assign auto_pc_to_s00_couplers_AWREADY = M_AXI_awready;
  assign auto_pc_to_s00_couplers_BRESP = M_AXI_bresp[1:0];
  assign auto_pc_to_s00_couplers_BVALID = M_AXI_bvalid;
  assign auto_pc_to_s00_couplers_RDATA = M_AXI_rdata[31:0];
  assign auto_pc_to_s00_couplers_RRESP = M_AXI_rresp[1:0];
  assign auto_pc_to_s00_couplers_RVALID = M_AXI_rvalid;
  assign auto_pc_to_s00_couplers_WREADY = M_AXI_wready;
  assign s00_couplers_to_auto_pc_ARADDR = S_AXI_araddr[31:0];
  assign s00_couplers_to_auto_pc_ARBURST = S_AXI_arburst[1:0];
  assign s00_couplers_to_auto_pc_ARCACHE = S_AXI_arcache[3:0];
  assign s00_couplers_to_auto_pc_ARLEN = S_AXI_arlen[3:0];
  assign s00_couplers_to_auto_pc_ARLOCK = S_AXI_arlock[1:0];
  assign s00_couplers_to_auto_pc_ARPROT = S_AXI_arprot[2:0];
  assign s00_couplers_to_auto_pc_ARQOS = S_AXI_arqos[3:0];
  assign s00_couplers_to_auto_pc_ARSIZE = S_AXI_arsize[2:0];
  assign s00_couplers_to_auto_pc_ARVALID = S_AXI_arvalid;
  assign s00_couplers_to_auto_pc_AWADDR = S_AXI_awaddr[31:0];
  assign s00_couplers_to_auto_pc_AWBURST = S_AXI_awburst[1:0];
  assign s00_couplers_to_auto_pc_AWCACHE = S_AXI_awcache[3:0];
  assign s00_couplers_to_auto_pc_AWLEN = S_AXI_awlen[3:0];
  assign s00_couplers_to_auto_pc_AWLOCK = S_AXI_awlock[1:0];
  assign s00_couplers_to_auto_pc_AWPROT = S_AXI_awprot[2:0];
  assign s00_couplers_to_auto_pc_AWQOS = S_AXI_awqos[3:0];
  assign s00_couplers_to_auto_pc_AWSIZE = S_AXI_awsize[2:0];
  assign s00_couplers_to_auto_pc_AWVALID = S_AXI_awvalid;
  assign s00_couplers_to_auto_pc_BREADY = S_AXI_bready;
  assign s00_couplers_to_auto_pc_RREADY = S_AXI_rready;
  assign s00_couplers_to_auto_pc_WDATA = S_AXI_wdata[31:0];
  assign s00_couplers_to_auto_pc_WLAST = S_AXI_wlast;
  assign s00_couplers_to_auto_pc_WSTRB = S_AXI_wstrb[3:0];
  assign s00_couplers_to_auto_pc_WVALID = S_AXI_wvalid;
  system_auto_pc_0 auto_pc
       (.aclk(S_ACLK_1),
        .aresetn(S_ARESETN_1),
        .m_axi_araddr(auto_pc_to_s00_couplers_ARADDR),
        .m_axi_arprot(auto_pc_to_s00_couplers_ARPROT),
        .m_axi_arready(auto_pc_to_s00_couplers_ARREADY),
        .m_axi_arvalid(auto_pc_to_s00_couplers_ARVALID),
        .m_axi_awaddr(auto_pc_to_s00_couplers_AWADDR),
        .m_axi_awprot(auto_pc_to_s00_couplers_AWPROT),
        .m_axi_awready(auto_pc_to_s00_couplers_AWREADY),
        .m_axi_awvalid(auto_pc_to_s00_couplers_AWVALID),
        .m_axi_bready(auto_pc_to_s00_couplers_BREADY),
        .m_axi_bresp(auto_pc_to_s00_couplers_BRESP),
        .m_axi_bvalid(auto_pc_to_s00_couplers_BVALID),
        .m_axi_rdata(auto_pc_to_s00_couplers_RDATA),
        .m_axi_rready(auto_pc_to_s00_couplers_RREADY),
        .m_axi_rresp(auto_pc_to_s00_couplers_RRESP),
        .m_axi_rvalid(auto_pc_to_s00_couplers_RVALID),
        .m_axi_wdata(auto_pc_to_s00_couplers_WDATA),
        .m_axi_wready(auto_pc_to_s00_couplers_WREADY),
        .m_axi_wstrb(auto_pc_to_s00_couplers_WSTRB),
        .m_axi_wvalid(auto_pc_to_s00_couplers_WVALID),
        .s_axi_araddr(s00_couplers_to_auto_pc_ARADDR),
        .s_axi_arburst(s00_couplers_to_auto_pc_ARBURST),
        .s_axi_arcache(s00_couplers_to_auto_pc_ARCACHE),
        .s_axi_arlen(s00_couplers_to_auto_pc_ARLEN),
        .s_axi_arlock(s00_couplers_to_auto_pc_ARLOCK),
        .s_axi_arprot(s00_couplers_to_auto_pc_ARPROT),
        .s_axi_arqos(s00_couplers_to_auto_pc_ARQOS),
        .s_axi_arready(s00_couplers_to_auto_pc_ARREADY),
        .s_axi_arsize(s00_couplers_to_auto_pc_ARSIZE),
        .s_axi_arvalid(s00_couplers_to_auto_pc_ARVALID),
        .s_axi_awaddr(s00_couplers_to_auto_pc_AWADDR),
        .s_axi_awburst(s00_couplers_to_auto_pc_AWBURST),
        .s_axi_awcache(s00_couplers_to_auto_pc_AWCACHE),
        .s_axi_awlen(s00_couplers_to_auto_pc_AWLEN),
        .s_axi_awlock(s00_couplers_to_auto_pc_AWLOCK),
        .s_axi_awprot(s00_couplers_to_auto_pc_AWPROT),
        .s_axi_awqos(s00_couplers_to_auto_pc_AWQOS),
        .s_axi_awready(s00_couplers_to_auto_pc_AWREADY),
        .s_axi_awsize(s00_couplers_to_auto_pc_AWSIZE),
        .s_axi_awvalid(s00_couplers_to_auto_pc_AWVALID),
        .s_axi_bready(s00_couplers_to_auto_pc_BREADY),
        .s_axi_bresp(s00_couplers_to_auto_pc_BRESP),
        .s_axi_bvalid(s00_couplers_to_auto_pc_BVALID),
        .s_axi_rdata(s00_couplers_to_auto_pc_RDATA),
        .s_axi_rlast(s00_couplers_to_auto_pc_RLAST),
        .s_axi_rready(s00_couplers_to_auto_pc_RREADY),
        .s_axi_rresp(s00_couplers_to_auto_pc_RRESP),
        .s_axi_rvalid(s00_couplers_to_auto_pc_RVALID),
        .s_axi_wdata(s00_couplers_to_auto_pc_WDATA),
        .s_axi_wlast(s00_couplers_to_auto_pc_WLAST),
        .s_axi_wready(s00_couplers_to_auto_pc_WREADY),
        .s_axi_wstrb(s00_couplers_to_auto_pc_WSTRB),
        .s_axi_wvalid(s00_couplers_to_auto_pc_WVALID));
endmodule

module s00_couplers_imp_1P403ZT
   (M_ACLK,
    M_ARESETN,
    M_AXI_araddr,
    M_AXI_arburst,
    M_AXI_arcache,
    M_AXI_arlen,
    M_AXI_arlock,
    M_AXI_arprot,
    M_AXI_arqos,
    M_AXI_arready,
    M_AXI_arsize,
    M_AXI_arvalid,
    M_AXI_awaddr,
    M_AXI_awburst,
    M_AXI_awcache,
    M_AXI_awlen,
    M_AXI_awlock,
    M_AXI_awprot,
    M_AXI_awqos,
    M_AXI_awready,
    M_AXI_awsize,
    M_AXI_awvalid,
    M_AXI_bready,
    M_AXI_bresp,
    M_AXI_bvalid,
    M_AXI_rdata,
    M_AXI_rlast,
    M_AXI_rready,
    M_AXI_rresp,
    M_AXI_rvalid,
    M_AXI_wdata,
    M_AXI_wlast,
    M_AXI_wready,
    M_AXI_wstrb,
    M_AXI_wvalid,
    S_ACLK,
    S_ARESETN,
    S_AXI_awaddr,
    S_AXI_awburst,
    S_AXI_awcache,
    S_AXI_awlen,
    S_AXI_awprot,
    S_AXI_awready,
    S_AXI_awsize,
    S_AXI_awvalid,
    S_AXI_bready,
    S_AXI_bresp,
    S_AXI_bvalid,
    S_AXI_wdata,
    S_AXI_wlast,
    S_AXI_wready,
    S_AXI_wstrb,
    S_AXI_wvalid);
  input M_ACLK;
  input M_ARESETN;
  output [31:0]M_AXI_araddr;
  output [1:0]M_AXI_arburst;
  output [3:0]M_AXI_arcache;
  output [7:0]M_AXI_arlen;
  output [0:0]M_AXI_arlock;
  output [2:0]M_AXI_arprot;
  output [3:0]M_AXI_arqos;
  input M_AXI_arready;
  output [2:0]M_AXI_arsize;
  output M_AXI_arvalid;
  output [31:0]M_AXI_awaddr;
  output [1:0]M_AXI_awburst;
  output [3:0]M_AXI_awcache;
  output [7:0]M_AXI_awlen;
  output [0:0]M_AXI_awlock;
  output [2:0]M_AXI_awprot;
  output [3:0]M_AXI_awqos;
  input M_AXI_awready;
  output [2:0]M_AXI_awsize;
  output M_AXI_awvalid;
  output M_AXI_bready;
  input [1:0]M_AXI_bresp;
  input M_AXI_bvalid;
  input [63:0]M_AXI_rdata;
  input M_AXI_rlast;
  output M_AXI_rready;
  input [1:0]M_AXI_rresp;
  input M_AXI_rvalid;
  output [63:0]M_AXI_wdata;
  output M_AXI_wlast;
  input M_AXI_wready;
  output [7:0]M_AXI_wstrb;
  output M_AXI_wvalid;
  input S_ACLK;
  input S_ARESETN;
  input [31:0]S_AXI_awaddr;
  input [1:0]S_AXI_awburst;
  input [3:0]S_AXI_awcache;
  input [7:0]S_AXI_awlen;
  input [2:0]S_AXI_awprot;
  output S_AXI_awready;
  input [2:0]S_AXI_awsize;
  input S_AXI_awvalid;
  input S_AXI_bready;
  output [1:0]S_AXI_bresp;
  output S_AXI_bvalid;
  input [31:0]S_AXI_wdata;
  input S_AXI_wlast;
  output S_AXI_wready;
  input [3:0]S_AXI_wstrb;
  input S_AXI_wvalid;

  wire S_ACLK_1;
  wire S_ARESETN_1;
  wire [31:0]auto_pc_to_auto_us_ARADDR;
  wire [1:0]auto_pc_to_auto_us_ARBURST;
  wire [3:0]auto_pc_to_auto_us_ARCACHE;
  wire [3:0]auto_pc_to_auto_us_ARLEN;
  wire [1:0]auto_pc_to_auto_us_ARLOCK;
  wire [2:0]auto_pc_to_auto_us_ARPROT;
  wire [3:0]auto_pc_to_auto_us_ARQOS;
  wire auto_pc_to_auto_us_ARREADY;
  wire [2:0]auto_pc_to_auto_us_ARSIZE;
  wire auto_pc_to_auto_us_ARVALID;
  wire [31:0]auto_pc_to_auto_us_AWADDR;
  wire [1:0]auto_pc_to_auto_us_AWBURST;
  wire [3:0]auto_pc_to_auto_us_AWCACHE;
  wire [3:0]auto_pc_to_auto_us_AWLEN;
  wire [1:0]auto_pc_to_auto_us_AWLOCK;
  wire [2:0]auto_pc_to_auto_us_AWPROT;
  wire [3:0]auto_pc_to_auto_us_AWQOS;
  wire auto_pc_to_auto_us_AWREADY;
  wire [2:0]auto_pc_to_auto_us_AWSIZE;
  wire auto_pc_to_auto_us_AWVALID;
  wire auto_pc_to_auto_us_BREADY;
  wire [1:0]auto_pc_to_auto_us_BRESP;
  wire auto_pc_to_auto_us_BVALID;
  wire [31:0]auto_pc_to_auto_us_RDATA;
  wire auto_pc_to_auto_us_RLAST;
  wire auto_pc_to_auto_us_RREADY;
  wire [1:0]auto_pc_to_auto_us_RRESP;
  wire auto_pc_to_auto_us_RVALID;
  wire [31:0]auto_pc_to_auto_us_WDATA;
  wire auto_pc_to_auto_us_WLAST;
  wire auto_pc_to_auto_us_WREADY;
  wire [3:0]auto_pc_to_auto_us_WSTRB;
  wire auto_pc_to_auto_us_WVALID;
  wire [31:0]auto_us_to_s00_couplers_ARADDR;
  wire [1:0]auto_us_to_s00_couplers_ARBURST;
  wire [3:0]auto_us_to_s00_couplers_ARCACHE;
  wire [7:0]auto_us_to_s00_couplers_ARLEN;
  wire [0:0]auto_us_to_s00_couplers_ARLOCK;
  wire [2:0]auto_us_to_s00_couplers_ARPROT;
  wire [3:0]auto_us_to_s00_couplers_ARQOS;
  wire auto_us_to_s00_couplers_ARREADY;
  wire [2:0]auto_us_to_s00_couplers_ARSIZE;
  wire auto_us_to_s00_couplers_ARVALID;
  wire [31:0]auto_us_to_s00_couplers_AWADDR;
  wire [1:0]auto_us_to_s00_couplers_AWBURST;
  wire [3:0]auto_us_to_s00_couplers_AWCACHE;
  wire [7:0]auto_us_to_s00_couplers_AWLEN;
  wire [0:0]auto_us_to_s00_couplers_AWLOCK;
  wire [2:0]auto_us_to_s00_couplers_AWPROT;
  wire [3:0]auto_us_to_s00_couplers_AWQOS;
  wire auto_us_to_s00_couplers_AWREADY;
  wire [2:0]auto_us_to_s00_couplers_AWSIZE;
  wire auto_us_to_s00_couplers_AWVALID;
  wire auto_us_to_s00_couplers_BREADY;
  wire [1:0]auto_us_to_s00_couplers_BRESP;
  wire auto_us_to_s00_couplers_BVALID;
  wire [63:0]auto_us_to_s00_couplers_RDATA;
  wire auto_us_to_s00_couplers_RLAST;
  wire auto_us_to_s00_couplers_RREADY;
  wire [1:0]auto_us_to_s00_couplers_RRESP;
  wire auto_us_to_s00_couplers_RVALID;
  wire [63:0]auto_us_to_s00_couplers_WDATA;
  wire auto_us_to_s00_couplers_WLAST;
  wire auto_us_to_s00_couplers_WREADY;
  wire [7:0]auto_us_to_s00_couplers_WSTRB;
  wire auto_us_to_s00_couplers_WVALID;
  wire [31:0]s00_couplers_to_auto_pc_AWADDR;
  wire [1:0]s00_couplers_to_auto_pc_AWBURST;
  wire [3:0]s00_couplers_to_auto_pc_AWCACHE;
  wire [7:0]s00_couplers_to_auto_pc_AWLEN;
  wire [2:0]s00_couplers_to_auto_pc_AWPROT;
  wire s00_couplers_to_auto_pc_AWREADY;
  wire [2:0]s00_couplers_to_auto_pc_AWSIZE;
  wire s00_couplers_to_auto_pc_AWVALID;
  wire s00_couplers_to_auto_pc_BREADY;
  wire [1:0]s00_couplers_to_auto_pc_BRESP;
  wire s00_couplers_to_auto_pc_BVALID;
  wire [31:0]s00_couplers_to_auto_pc_WDATA;
  wire s00_couplers_to_auto_pc_WLAST;
  wire s00_couplers_to_auto_pc_WREADY;
  wire [3:0]s00_couplers_to_auto_pc_WSTRB;
  wire s00_couplers_to_auto_pc_WVALID;

  assign M_AXI_araddr[31:0] = auto_us_to_s00_couplers_ARADDR;
  assign M_AXI_arburst[1:0] = auto_us_to_s00_couplers_ARBURST;
  assign M_AXI_arcache[3:0] = auto_us_to_s00_couplers_ARCACHE;
  assign M_AXI_arlen[7:0] = auto_us_to_s00_couplers_ARLEN;
  assign M_AXI_arlock[0] = auto_us_to_s00_couplers_ARLOCK;
  assign M_AXI_arprot[2:0] = auto_us_to_s00_couplers_ARPROT;
  assign M_AXI_arqos[3:0] = auto_us_to_s00_couplers_ARQOS;
  assign M_AXI_arsize[2:0] = auto_us_to_s00_couplers_ARSIZE;
  assign M_AXI_arvalid = auto_us_to_s00_couplers_ARVALID;
  assign M_AXI_awaddr[31:0] = auto_us_to_s00_couplers_AWADDR;
  assign M_AXI_awburst[1:0] = auto_us_to_s00_couplers_AWBURST;
  assign M_AXI_awcache[3:0] = auto_us_to_s00_couplers_AWCACHE;
  assign M_AXI_awlen[7:0] = auto_us_to_s00_couplers_AWLEN;
  assign M_AXI_awlock[0] = auto_us_to_s00_couplers_AWLOCK;
  assign M_AXI_awprot[2:0] = auto_us_to_s00_couplers_AWPROT;
  assign M_AXI_awqos[3:0] = auto_us_to_s00_couplers_AWQOS;
  assign M_AXI_awsize[2:0] = auto_us_to_s00_couplers_AWSIZE;
  assign M_AXI_awvalid = auto_us_to_s00_couplers_AWVALID;
  assign M_AXI_bready = auto_us_to_s00_couplers_BREADY;
  assign M_AXI_rready = auto_us_to_s00_couplers_RREADY;
  assign M_AXI_wdata[63:0] = auto_us_to_s00_couplers_WDATA;
  assign M_AXI_wlast = auto_us_to_s00_couplers_WLAST;
  assign M_AXI_wstrb[7:0] = auto_us_to_s00_couplers_WSTRB;
  assign M_AXI_wvalid = auto_us_to_s00_couplers_WVALID;
  assign S_ACLK_1 = S_ACLK;
  assign S_ARESETN_1 = S_ARESETN;
  assign S_AXI_awready = s00_couplers_to_auto_pc_AWREADY;
  assign S_AXI_bresp[1:0] = s00_couplers_to_auto_pc_BRESP;
  assign S_AXI_bvalid = s00_couplers_to_auto_pc_BVALID;
  assign S_AXI_wready = s00_couplers_to_auto_pc_WREADY;
  assign auto_us_to_s00_couplers_ARREADY = M_AXI_arready;
  assign auto_us_to_s00_couplers_AWREADY = M_AXI_awready;
  assign auto_us_to_s00_couplers_BRESP = M_AXI_bresp[1:0];
  assign auto_us_to_s00_couplers_BVALID = M_AXI_bvalid;
  assign auto_us_to_s00_couplers_RDATA = M_AXI_rdata[63:0];
  assign auto_us_to_s00_couplers_RLAST = M_AXI_rlast;
  assign auto_us_to_s00_couplers_RRESP = M_AXI_rresp[1:0];
  assign auto_us_to_s00_couplers_RVALID = M_AXI_rvalid;
  assign auto_us_to_s00_couplers_WREADY = M_AXI_wready;
  assign s00_couplers_to_auto_pc_AWADDR = S_AXI_awaddr[31:0];
  assign s00_couplers_to_auto_pc_AWBURST = S_AXI_awburst[1:0];
  assign s00_couplers_to_auto_pc_AWCACHE = S_AXI_awcache[3:0];
  assign s00_couplers_to_auto_pc_AWLEN = S_AXI_awlen[7:0];
  assign s00_couplers_to_auto_pc_AWPROT = S_AXI_awprot[2:0];
  assign s00_couplers_to_auto_pc_AWSIZE = S_AXI_awsize[2:0];
  assign s00_couplers_to_auto_pc_AWVALID = S_AXI_awvalid;
  assign s00_couplers_to_auto_pc_BREADY = S_AXI_bready;
  assign s00_couplers_to_auto_pc_WDATA = S_AXI_wdata[31:0];
  assign s00_couplers_to_auto_pc_WLAST = S_AXI_wlast;
  assign s00_couplers_to_auto_pc_WSTRB = S_AXI_wstrb[3:0];
  assign s00_couplers_to_auto_pc_WVALID = S_AXI_wvalid;
  system_auto_pc_1 auto_pc
       (.aclk(S_ACLK_1),
        .aresetn(S_ARESETN_1),
        .m_axi_araddr(auto_pc_to_auto_us_ARADDR),
        .m_axi_arburst(auto_pc_to_auto_us_ARBURST),
        .m_axi_arcache(auto_pc_to_auto_us_ARCACHE),
        .m_axi_arlen(auto_pc_to_auto_us_ARLEN),
        .m_axi_arlock(auto_pc_to_auto_us_ARLOCK),
        .m_axi_arprot(auto_pc_to_auto_us_ARPROT),
        .m_axi_arqos(auto_pc_to_auto_us_ARQOS),
        .m_axi_arready(auto_pc_to_auto_us_ARREADY),
        .m_axi_arsize(auto_pc_to_auto_us_ARSIZE),
        .m_axi_arvalid(auto_pc_to_auto_us_ARVALID),
        .m_axi_awaddr(auto_pc_to_auto_us_AWADDR),
        .m_axi_awburst(auto_pc_to_auto_us_AWBURST),
        .m_axi_awcache(auto_pc_to_auto_us_AWCACHE),
        .m_axi_awlen(auto_pc_to_auto_us_AWLEN),
        .m_axi_awlock(auto_pc_to_auto_us_AWLOCK),
        .m_axi_awprot(auto_pc_to_auto_us_AWPROT),
        .m_axi_awqos(auto_pc_to_auto_us_AWQOS),
        .m_axi_awready(auto_pc_to_auto_us_AWREADY),
        .m_axi_awsize(auto_pc_to_auto_us_AWSIZE),
        .m_axi_awvalid(auto_pc_to_auto_us_AWVALID),
        .m_axi_bready(auto_pc_to_auto_us_BREADY),
        .m_axi_bresp(auto_pc_to_auto_us_BRESP),
        .m_axi_bvalid(auto_pc_to_auto_us_BVALID),
        .m_axi_rdata(auto_pc_to_auto_us_RDATA),
        .m_axi_rlast(auto_pc_to_auto_us_RLAST),
        .m_axi_rready(auto_pc_to_auto_us_RREADY),
        .m_axi_rresp(auto_pc_to_auto_us_RRESP),
        .m_axi_rvalid(auto_pc_to_auto_us_RVALID),
        .m_axi_wdata(auto_pc_to_auto_us_WDATA),
        .m_axi_wlast(auto_pc_to_auto_us_WLAST),
        .m_axi_wready(auto_pc_to_auto_us_WREADY),
        .m_axi_wstrb(auto_pc_to_auto_us_WSTRB),
        .m_axi_wvalid(auto_pc_to_auto_us_WVALID),
        .s_axi_araddr({1'b0,1'b0,1'b0,1'b0,1'b0,1'b0,1'b0,1'b0,1'b0,1'b0,1'b0,1'b0,1'b0,1'b0,1'b0,1'b0,1'b0,1'b0,1'b0,1'b0,1'b0,1'b0,1'b0,1'b0,1'b0,1'b0,1'b0,1'b0,1'b0,1'b0,1'b0,1'b0}),
        .s_axi_arburst({1'b0,1'b1}),
        .s_axi_arcache({1'b0,1'b0,1'b1,1'b1}),
        .s_axi_arlen({1'b0,1'b0,1'b0,1'b0,1'b0,1'b0,1'b0,1'b0}),
        .s_axi_arlock(1'b0),
        .s_axi_arprot({1'b0,1'b0,1'b0}),
        .s_axi_arqos({1'b0,1'b0,1'b0,1'b0}),
        .s_axi_arregion({1'b0,1'b0,1'b0,1'b0}),
        .s_axi_arsize({1'b0,1'b1,1'b0}),
        .s_axi_arvalid(1'b0),
        .s_axi_awaddr(s00_couplers_to_auto_pc_AWADDR),
        .s_axi_awburst(s00_couplers_to_auto_pc_AWBURST),
        .s_axi_awcache(s00_couplers_to_auto_pc_AWCACHE),
        .s_axi_awlen(s00_couplers_to_auto_pc_AWLEN),
        .s_axi_awlock(1'b0),
        .s_axi_awprot(s00_couplers_to_auto_pc_AWPROT),
        .s_axi_awqos({1'b0,1'b0,1'b0,1'b0}),
        .s_axi_awready(s00_couplers_to_auto_pc_AWREADY),
        .s_axi_awregion({1'b0,1'b0,1'b0,1'b0}),
        .s_axi_awsize(s00_couplers_to_auto_pc_AWSIZE),
        .s_axi_awvalid(s00_couplers_to_auto_pc_AWVALID),
        .s_axi_bready(s00_couplers_to_auto_pc_BREADY),
        .s_axi_bresp(s00_couplers_to_auto_pc_BRESP),
        .s_axi_bvalid(s00_couplers_to_auto_pc_BVALID),
        .s_axi_rready(1'b0),
        .s_axi_wdata(s00_couplers_to_auto_pc_WDATA),
        .s_axi_wlast(s00_couplers_to_auto_pc_WLAST),
        .s_axi_wready(s00_couplers_to_auto_pc_WREADY),
        .s_axi_wstrb(s00_couplers_to_auto_pc_WSTRB),
        .s_axi_wvalid(s00_couplers_to_auto_pc_WVALID));
  system_auto_us_0 auto_us
       (.m_axi_araddr(auto_us_to_s00_couplers_ARADDR),
        .m_axi_arburst(auto_us_to_s00_couplers_ARBURST),
        .m_axi_arcache(auto_us_to_s00_couplers_ARCACHE),
        .m_axi_arlen(auto_us_to_s00_couplers_ARLEN),
        .m_axi_arlock(auto_us_to_s00_couplers_ARLOCK),
        .m_axi_arprot(auto_us_to_s00_couplers_ARPROT),
        .m_axi_arqos(auto_us_to_s00_couplers_ARQOS),
        .m_axi_arready(auto_us_to_s00_couplers_ARREADY),
        .m_axi_arsize(auto_us_to_s00_couplers_ARSIZE),
        .m_axi_arvalid(auto_us_to_s00_couplers_ARVALID),
        .m_axi_awaddr(auto_us_to_s00_couplers_AWADDR),
        .m_axi_awburst(auto_us_to_s00_couplers_AWBURST),
        .m_axi_awcache(auto_us_to_s00_couplers_AWCACHE),
        .m_axi_awlen(auto_us_to_s00_couplers_AWLEN),
        .m_axi_awlock(auto_us_to_s00_couplers_AWLOCK),
        .m_axi_awprot(auto_us_to_s00_couplers_AWPROT),
        .m_axi_awqos(auto_us_to_s00_couplers_AWQOS),
        .m_axi_awready(auto_us_to_s00_couplers_AWREADY),
        .m_axi_awsize(auto_us_to_s00_couplers_AWSIZE),
        .m_axi_awvalid(auto_us_to_s00_couplers_AWVALID),
        .m_axi_bready(auto_us_to_s00_couplers_BREADY),
        .m_axi_bresp(auto_us_to_s00_couplers_BRESP),
        .m_axi_bvalid(auto_us_to_s00_couplers_BVALID),
        .m_axi_rdata(auto_us_to_s00_couplers_RDATA),
        .m_axi_rlast(auto_us_to_s00_couplers_RLAST),
        .m_axi_rready(auto_us_to_s00_couplers_RREADY),
        .m_axi_rresp(auto_us_to_s00_couplers_RRESP),
        .m_axi_rvalid(auto_us_to_s00_couplers_RVALID),
        .m_axi_wdata(auto_us_to_s00_couplers_WDATA),
        .m_axi_wlast(auto_us_to_s00_couplers_WLAST),
        .m_axi_wready(auto_us_to_s00_couplers_WREADY),
        .m_axi_wstrb(auto_us_to_s00_couplers_WSTRB),
        .m_axi_wvalid(auto_us_to_s00_couplers_WVALID),
        .s_axi_aclk(S_ACLK_1),
        .s_axi_araddr(auto_pc_to_auto_us_ARADDR),
        .s_axi_arburst(auto_pc_to_auto_us_ARBURST),
        .s_axi_arcache(auto_pc_to_auto_us_ARCACHE),
        .s_axi_aresetn(S_ARESETN_1),
        .s_axi_arlen({1'b0,1'b0,1'b0,1'b0,auto_pc_to_auto_us_ARLEN}),
        .s_axi_arlock(auto_pc_to_auto_us_ARLOCK[0]),
        .s_axi_arprot(auto_pc_to_auto_us_ARPROT),
        .s_axi_arqos(auto_pc_to_auto_us_ARQOS),
        .s_axi_arready(auto_pc_to_auto_us_ARREADY),
        .s_axi_arregion({1'b0,1'b0,1'b0,1'b0}),
        .s_axi_arsize(auto_pc_to_auto_us_ARSIZE),
        .s_axi_arvalid(auto_pc_to_auto_us_ARVALID),
        .s_axi_awaddr(auto_pc_to_auto_us_AWADDR),
        .s_axi_awburst(auto_pc_to_auto_us_AWBURST),
        .s_axi_awcache(auto_pc_to_auto_us_AWCACHE),
        .s_axi_awlen({1'b0,1'b0,1'b0,1'b0,auto_pc_to_auto_us_AWLEN}),
        .s_axi_awlock(auto_pc_to_auto_us_AWLOCK[0]),
        .s_axi_awprot(auto_pc_to_auto_us_AWPROT),
        .s_axi_awqos(auto_pc_to_auto_us_AWQOS),
        .s_axi_awready(auto_pc_to_auto_us_AWREADY),
        .s_axi_awregion({1'b0,1'b0,1'b0,1'b0}),
        .s_axi_awsize(auto_pc_to_auto_us_AWSIZE),
        .s_axi_awvalid(auto_pc_to_auto_us_AWVALID),
        .s_axi_bready(auto_pc_to_auto_us_BREADY),
        .s_axi_bresp(auto_pc_to_auto_us_BRESP),
        .s_axi_bvalid(auto_pc_to_auto_us_BVALID),
        .s_axi_rdata(auto_pc_to_auto_us_RDATA),
        .s_axi_rlast(auto_pc_to_auto_us_RLAST),
        .s_axi_rready(auto_pc_to_auto_us_RREADY),
        .s_axi_rresp(auto_pc_to_auto_us_RRESP),
        .s_axi_rvalid(auto_pc_to_auto_us_RVALID),
        .s_axi_wdata(auto_pc_to_auto_us_WDATA),
        .s_axi_wlast(auto_pc_to_auto_us_WLAST),
        .s_axi_wready(auto_pc_to_auto_us_WREADY),
        .s_axi_wstrb(auto_pc_to_auto_us_WSTRB),
        .s_axi_wvalid(auto_pc_to_auto_us_WVALID));
endmodule

(* CORE_GENERATION_INFO = "system,IP_Integrator,{x_ipVendor=xilinx.com,x_ipLibrary=BlockDiagram,x_ipName=system,x_ipVersion=1.00.a,x_ipLanguage=VERILOG,numBlks=20,numReposBlks=13,numNonXlnxBlks=0,numHierBlks=7,maxHierDepth=0,numSysgenBlks=0,numHlsBlks=0,numHdlrefBlks=1,numPkgbdBlks=0,bdsource=USER,da_axi4_cnt=13,da_board_cnt=2,da_clkrst_cnt=23,da_ps7_cnt=1,synth_mode=OOC_per_IP}" *) (* HW_HANDOFF = "system.hwdef" *) 
module system
   (DDR_addr,
    DDR_ba,
    DDR_cas_n,
    DDR_ck_n,
    DDR_ck_p,
    DDR_cke,
    DDR_cs_n,
    DDR_dm,
    DDR_dq,
    DDR_dqs_n,
    DDR_dqs_p,
    DDR_odt,
    DDR_ras_n,
    DDR_reset_n,
    DDR_we_n,
    FIXED_IO_ddr_vrn,
    FIXED_IO_ddr_vrp,
    FIXED_IO_mio,
    FIXED_IO_ps_clk,
    FIXED_IO_ps_porb,
    FIXED_IO_ps_srstb,
    GPIO_0_0_tri_i,
    GPIO_0_0_tri_o,
    GPIO_0_0_tri_t,
    UART_1_rxd,
    UART_1_txd,
    adc_datain,
    adc_driver_clk,
    adc_pwr_en);
  (* X_INTERFACE_INFO = "xilinx.com:interface:ddrx:1.0 DDR ADDR" *) (* X_INTERFACE_PARAMETER = "XIL_INTERFACENAME DDR, AXI_ARBITRATION_SCHEME TDM, BURST_LENGTH 8, CAN_DEBUG false, CAS_LATENCY 11, CAS_WRITE_LATENCY 11, CS_ENABLED true, DATA_MASK_ENABLED true, DATA_WIDTH 8, MEMORY_TYPE COMPONENTS, MEM_ADDR_MAP ROW_COLUMN_BANK, SLOT Single, TIMEPERIOD_PS 1250" *) inout [14:0]DDR_addr;
  (* X_INTERFACE_INFO = "xilinx.com:interface:ddrx:1.0 DDR BA" *) inout [2:0]DDR_ba;
  (* X_INTERFACE_INFO = "xilinx.com:interface:ddrx:1.0 DDR CAS_N" *) inout DDR_cas_n;
  (* X_INTERFACE_INFO = "xilinx.com:interface:ddrx:1.0 DDR CK_N" *) inout DDR_ck_n;
  (* X_INTERFACE_INFO = "xilinx.com:interface:ddrx:1.0 DDR CK_P" *) inout DDR_ck_p;
  (* X_INTERFACE_INFO = "xilinx.com:interface:ddrx:1.0 DDR CKE" *) inout DDR_cke;
  (* X_INTERFACE_INFO = "xilinx.com:interface:ddrx:1.0 DDR CS_N" *) inout DDR_cs_n;
  (* X_INTERFACE_INFO = "xilinx.com:interface:ddrx:1.0 DDR DM" *) inout [3:0]DDR_dm;
  (* X_INTERFACE_INFO = "xilinx.com:interface:ddrx:1.0 DDR DQ" *) inout [31:0]DDR_dq;
  (* X_INTERFACE_INFO = "xilinx.com:interface:ddrx:1.0 DDR DQS_N" *) inout [3:0]DDR_dqs_n;
  (* X_INTERFACE_INFO = "xilinx.com:interface:ddrx:1.0 DDR DQS_P" *) inout [3:0]DDR_dqs_p;
  (* X_INTERFACE_INFO = "xilinx.com:interface:ddrx:1.0 DDR ODT" *) inout DDR_odt;
  (* X_INTERFACE_INFO = "xilinx.com:interface:ddrx:1.0 DDR RAS_N" *) inout DDR_ras_n;
  (* X_INTERFACE_INFO = "xilinx.com:interface:ddrx:1.0 DDR RESET_N" *) inout DDR_reset_n;
  (* X_INTERFACE_INFO = "xilinx.com:interface:ddrx:1.0 DDR WE_N" *) inout DDR_we_n;
  (* X_INTERFACE_INFO = "xilinx.com:display_processing_system7:fixedio:1.0 FIXED_IO DDR_VRN" *) (* X_INTERFACE_PARAMETER = "XIL_INTERFACENAME FIXED_IO, CAN_DEBUG false" *) inout FIXED_IO_ddr_vrn;
  (* X_INTERFACE_INFO = "xilinx.com:display_processing_system7:fixedio:1.0 FIXED_IO DDR_VRP" *) inout FIXED_IO_ddr_vrp;
  (* X_INTERFACE_INFO = "xilinx.com:display_processing_system7:fixedio:1.0 FIXED_IO MIO" *) inout [53:0]FIXED_IO_mio;
  (* X_INTERFACE_INFO = "xilinx.com:display_processing_system7:fixedio:1.0 FIXED_IO PS_CLK" *) inout FIXED_IO_ps_clk;
  (* X_INTERFACE_INFO = "xilinx.com:display_processing_system7:fixedio:1.0 FIXED_IO PS_PORB" *) inout FIXED_IO_ps_porb;
  (* X_INTERFACE_INFO = "xilinx.com:display_processing_system7:fixedio:1.0 FIXED_IO PS_SRSTB" *) inout FIXED_IO_ps_srstb;
  (* X_INTERFACE_INFO = "xilinx.com:interface:gpio:1.0 GPIO_0_0 TRI_I" *) input [3:0]GPIO_0_0_tri_i;
  (* X_INTERFACE_INFO = "xilinx.com:interface:gpio:1.0 GPIO_0_0 TRI_O" *) output [3:0]GPIO_0_0_tri_o;
  (* X_INTERFACE_INFO = "xilinx.com:interface:gpio:1.0 GPIO_0_0 TRI_T" *) output [3:0]GPIO_0_0_tri_t;
  (* X_INTERFACE_INFO = "xilinx.com:interface:uart:1.0 UART_1 RxD" *) input UART_1_rxd;
  (* X_INTERFACE_INFO = "xilinx.com:interface:uart:1.0 UART_1 TxD" *) output UART_1_txd;
  input [13:0]adc_datain;
  (* X_INTERFACE_INFO = "xilinx.com:signal:clock:1.0 CLK.ADC_DRIVER_CLK CLK" *) (* X_INTERFACE_PARAMETER = "XIL_INTERFACENAME CLK.ADC_DRIVER_CLK, CLK_DOMAIN /clk_wiz_1_clk_out1, FREQ_HZ 80000000, FREQ_TOLERANCE_HZ 0, INSERT_VIP 0, PHASE -90.0" *) output adc_driver_clk;
  output adc_pwr_en;

  wire [13:0]adc_datain_1;
  wire [13:0]adc_fir_0_adc_fir_dataout;
  wire [31:0]axi_dma_0_M_AXI_S2MM_AWADDR;
  wire [1:0]axi_dma_0_M_AXI_S2MM_AWBURST;
  wire [3:0]axi_dma_0_M_AXI_S2MM_AWCACHE;
  wire [7:0]axi_dma_0_M_AXI_S2MM_AWLEN;
  wire [2:0]axi_dma_0_M_AXI_S2MM_AWPROT;
  wire axi_dma_0_M_AXI_S2MM_AWREADY;
  wire [2:0]axi_dma_0_M_AXI_S2MM_AWSIZE;
  wire axi_dma_0_M_AXI_S2MM_AWVALID;
  wire axi_dma_0_M_AXI_S2MM_BREADY;
  wire [1:0]axi_dma_0_M_AXI_S2MM_BRESP;
  wire axi_dma_0_M_AXI_S2MM_BVALID;
  wire [31:0]axi_dma_0_M_AXI_S2MM_WDATA;
  wire axi_dma_0_M_AXI_S2MM_WLAST;
  wire axi_dma_0_M_AXI_S2MM_WREADY;
  wire [3:0]axi_dma_0_M_AXI_S2MM_WSTRB;
  wire axi_dma_0_M_AXI_S2MM_WVALID;
  wire axi_dma_0_s2mm_introut;
  wire axi_dma_0_s2mm_prmry_reset_out_n;
  wire [31:0]axi_mem_intercon_M00_AXI_ARADDR;
  wire [1:0]axi_mem_intercon_M00_AXI_ARBURST;
  wire [3:0]axi_mem_intercon_M00_AXI_ARCACHE;
  wire [7:0]axi_mem_intercon_M00_AXI_ARLEN;
  wire [0:0]axi_mem_intercon_M00_AXI_ARLOCK;
  wire [2:0]axi_mem_intercon_M00_AXI_ARPROT;
  wire [3:0]axi_mem_intercon_M00_AXI_ARQOS;
  wire axi_mem_intercon_M00_AXI_ARREADY;
  wire [2:0]axi_mem_intercon_M00_AXI_ARSIZE;
  wire axi_mem_intercon_M00_AXI_ARVALID;
  wire [31:0]axi_mem_intercon_M00_AXI_AWADDR;
  wire [1:0]axi_mem_intercon_M00_AXI_AWBURST;
  wire [3:0]axi_mem_intercon_M00_AXI_AWCACHE;
  wire [7:0]axi_mem_intercon_M00_AXI_AWLEN;
  wire [0:0]axi_mem_intercon_M00_AXI_AWLOCK;
  wire [2:0]axi_mem_intercon_M00_AXI_AWPROT;
  wire [3:0]axi_mem_intercon_M00_AXI_AWQOS;
  wire axi_mem_intercon_M00_AXI_AWREADY;
  wire [2:0]axi_mem_intercon_M00_AXI_AWSIZE;
  wire axi_mem_intercon_M00_AXI_AWVALID;
  wire axi_mem_intercon_M00_AXI_BREADY;
  wire [1:0]axi_mem_intercon_M00_AXI_BRESP;
  wire axi_mem_intercon_M00_AXI_BVALID;
  wire [63:0]axi_mem_intercon_M00_AXI_RDATA;
  wire axi_mem_intercon_M00_AXI_RLAST;
  wire axi_mem_intercon_M00_AXI_RREADY;
  wire [1:0]axi_mem_intercon_M00_AXI_RRESP;
  wire axi_mem_intercon_M00_AXI_RVALID;
  wire [63:0]axi_mem_intercon_M00_AXI_WDATA;
  wire axi_mem_intercon_M00_AXI_WLAST;
  wire axi_mem_intercon_M00_AXI_WREADY;
  wire [7:0]axi_mem_intercon_M00_AXI_WSTRB;
  wire axi_mem_intercon_M00_AXI_WVALID;
  wire axi_uartlite_0_UART_RxD;
  wire axi_uartlite_0_UART_TxD;
  wire axi_uartlite_0_interrupt;
  wire clk_wiz_1_clk_out1;
  wire [31:0]dmca_ip_0_M00_AXIS_TDATA;
  wire dmca_ip_0_M00_AXIS_TLAST;
  wire dmca_ip_0_M00_AXIS_TREADY;
  wire dmca_ip_0_M00_AXIS_TVALID;
  wire [13:0]dmca_ip_0_adc_dataout;
  wire dmca_ip_0_adc_pwr_en;
  wire [16:0]dmca_ip_0_trapezd_data;
  wire [16:0]dmca_ip_0_triangle_data;
  wire [14:0]processing_system7_0_DDR_ADDR;
  wire [2:0]processing_system7_0_DDR_BA;
  wire processing_system7_0_DDR_CAS_N;
  wire processing_system7_0_DDR_CKE;
  wire processing_system7_0_DDR_CK_N;
  wire processing_system7_0_DDR_CK_P;
  wire processing_system7_0_DDR_CS_N;
  wire [3:0]processing_system7_0_DDR_DM;
  wire [31:0]processing_system7_0_DDR_DQ;
  wire [3:0]processing_system7_0_DDR_DQS_N;
  wire [3:0]processing_system7_0_DDR_DQS_P;
  wire processing_system7_0_DDR_ODT;
  wire processing_system7_0_DDR_RAS_N;
  wire processing_system7_0_DDR_RESET_N;
  wire processing_system7_0_DDR_WE_N;
  wire processing_system7_0_FCLK_CLK0;
  wire processing_system7_0_FCLK_RESET0_N;
  wire processing_system7_0_FIXED_IO_DDR_VRN;
  wire processing_system7_0_FIXED_IO_DDR_VRP;
  wire [53:0]processing_system7_0_FIXED_IO_MIO;
  wire processing_system7_0_FIXED_IO_PS_CLK;
  wire processing_system7_0_FIXED_IO_PS_PORB;
  wire processing_system7_0_FIXED_IO_PS_SRSTB;
  wire [3:0]processing_system7_0_GPIO_0_TRI_I;
  wire [3:0]processing_system7_0_GPIO_0_TRI_O;
  wire [3:0]processing_system7_0_GPIO_0_TRI_T;
  wire [31:0]processing_system7_0_M_AXI_GP0_ARADDR;
  wire [1:0]processing_system7_0_M_AXI_GP0_ARBURST;
  wire [3:0]processing_system7_0_M_AXI_GP0_ARCACHE;
  wire [3:0]processing_system7_0_M_AXI_GP0_ARLEN;
  wire [1:0]processing_system7_0_M_AXI_GP0_ARLOCK;
  wire [2:0]processing_system7_0_M_AXI_GP0_ARPROT;
  wire [3:0]processing_system7_0_M_AXI_GP0_ARQOS;
  wire processing_system7_0_M_AXI_GP0_ARREADY;
  wire [2:0]processing_system7_0_M_AXI_GP0_ARSIZE;
  wire processing_system7_0_M_AXI_GP0_ARVALID;
  wire [31:0]processing_system7_0_M_AXI_GP0_AWADDR;
  wire [1:0]processing_system7_0_M_AXI_GP0_AWBURST;
  wire [3:0]processing_system7_0_M_AXI_GP0_AWCACHE;
  wire [3:0]processing_system7_0_M_AXI_GP0_AWLEN;
  wire [1:0]processing_system7_0_M_AXI_GP0_AWLOCK;
  wire [2:0]processing_system7_0_M_AXI_GP0_AWPROT;
  wire [3:0]processing_system7_0_M_AXI_GP0_AWQOS;
  wire processing_system7_0_M_AXI_GP0_AWREADY;
  wire [2:0]processing_system7_0_M_AXI_GP0_AWSIZE;
  wire processing_system7_0_M_AXI_GP0_AWVALID;
  wire processing_system7_0_M_AXI_GP0_BREADY;
  wire [1:0]processing_system7_0_M_AXI_GP0_BRESP;
  wire processing_system7_0_M_AXI_GP0_BVALID;
  wire [31:0]processing_system7_0_M_AXI_GP0_RDATA;
  wire processing_system7_0_M_AXI_GP0_RLAST;
  wire processing_system7_0_M_AXI_GP0_RREADY;
  wire [1:0]processing_system7_0_M_AXI_GP0_RRESP;
  wire processing_system7_0_M_AXI_GP0_RVALID;
  wire [31:0]processing_system7_0_M_AXI_GP0_WDATA;
  wire processing_system7_0_M_AXI_GP0_WLAST;
  wire processing_system7_0_M_AXI_GP0_WREADY;
  wire [3:0]processing_system7_0_M_AXI_GP0_WSTRB;
  wire processing_system7_0_M_AXI_GP0_WVALID;
  wire [31:0]ps7_0_axi_periph_M00_AXI_ARADDR;
  wire ps7_0_axi_periph_M00_AXI_ARREADY;
  wire [0:0]ps7_0_axi_periph_M00_AXI_ARVALID;
  wire [31:0]ps7_0_axi_periph_M00_AXI_AWADDR;
  wire ps7_0_axi_periph_M00_AXI_AWREADY;
  wire [0:0]ps7_0_axi_periph_M00_AXI_AWVALID;
  wire [0:0]ps7_0_axi_periph_M00_AXI_BREADY;
  wire [1:0]ps7_0_axi_periph_M00_AXI_BRESP;
  wire ps7_0_axi_periph_M00_AXI_BVALID;
  wire [31:0]ps7_0_axi_periph_M00_AXI_RDATA;
  wire [0:0]ps7_0_axi_periph_M00_AXI_RREADY;
  wire [1:0]ps7_0_axi_periph_M00_AXI_RRESP;
  wire ps7_0_axi_periph_M00_AXI_RVALID;
  wire [31:0]ps7_0_axi_periph_M00_AXI_WDATA;
  wire ps7_0_axi_periph_M00_AXI_WREADY;
  wire [0:0]ps7_0_axi_periph_M00_AXI_WVALID;
  wire [31:0]ps7_0_axi_periph_M01_AXI_ARADDR;
  wire ps7_0_axi_periph_M01_AXI_ARREADY;
  wire [0:0]ps7_0_axi_periph_M01_AXI_ARVALID;
  wire [31:0]ps7_0_axi_periph_M01_AXI_AWADDR;
  wire ps7_0_axi_periph_M01_AXI_AWREADY;
  wire [0:0]ps7_0_axi_periph_M01_AXI_AWVALID;
  wire [0:0]ps7_0_axi_periph_M01_AXI_BREADY;
  wire [1:0]ps7_0_axi_periph_M01_AXI_BRESP;
  wire ps7_0_axi_periph_M01_AXI_BVALID;
  wire [31:0]ps7_0_axi_periph_M01_AXI_RDATA;
  wire [0:0]ps7_0_axi_periph_M01_AXI_RREADY;
  wire [1:0]ps7_0_axi_periph_M01_AXI_RRESP;
  wire ps7_0_axi_periph_M01_AXI_RVALID;
  wire [31:0]ps7_0_axi_periph_M01_AXI_WDATA;
  wire ps7_0_axi_periph_M01_AXI_WREADY;
  wire [3:0]ps7_0_axi_periph_M01_AXI_WSTRB;
  wire [0:0]ps7_0_axi_periph_M01_AXI_WVALID;
  wire [31:0]ps7_0_axi_periph_M02_AXI_ARADDR;
  wire [2:0]ps7_0_axi_periph_M02_AXI_ARPROT;
  wire ps7_0_axi_periph_M02_AXI_ARREADY;
  wire ps7_0_axi_periph_M02_AXI_ARVALID;
  wire [31:0]ps7_0_axi_periph_M02_AXI_AWADDR;
  wire [2:0]ps7_0_axi_periph_M02_AXI_AWPROT;
  wire ps7_0_axi_periph_M02_AXI_AWREADY;
  wire ps7_0_axi_periph_M02_AXI_AWVALID;
  wire ps7_0_axi_periph_M02_AXI_BREADY;
  wire [1:0]ps7_0_axi_periph_M02_AXI_BRESP;
  wire ps7_0_axi_periph_M02_AXI_BVALID;
  wire [31:0]ps7_0_axi_periph_M02_AXI_RDATA;
  wire ps7_0_axi_periph_M02_AXI_RREADY;
  wire [1:0]ps7_0_axi_periph_M02_AXI_RRESP;
  wire ps7_0_axi_periph_M02_AXI_RVALID;
  wire [31:0]ps7_0_axi_periph_M02_AXI_WDATA;
  wire ps7_0_axi_periph_M02_AXI_WREADY;
  wire [3:0]ps7_0_axi_periph_M02_AXI_WSTRB;
  wire ps7_0_axi_periph_M02_AXI_WVALID;
  wire [0:0]rst_ps7_0_80M_peripheral_aresetn1;
  wire [1:0]xlconcat_0_dout;

  assign GPIO_0_0_tri_o[3:0] = processing_system7_0_GPIO_0_TRI_O;
  assign GPIO_0_0_tri_t[3:0] = processing_system7_0_GPIO_0_TRI_T;
  assign UART_1_txd = axi_uartlite_0_UART_TxD;
  assign adc_datain_1 = adc_datain[13:0];
  assign adc_driver_clk = clk_wiz_1_clk_out1;
  assign adc_pwr_en = dmca_ip_0_adc_pwr_en;
  assign axi_uartlite_0_UART_RxD = UART_1_rxd;
  assign processing_system7_0_GPIO_0_TRI_I = GPIO_0_0_tri_i[3:0];
  system_adc_fir_0_0 adc_fir_0
       (.adc_datain(dmca_ip_0_adc_dataout),
        .adc_fir_dataout(adc_fir_0_adc_fir_dataout),
        .sys_clk(processing_system7_0_FCLK_CLK0),
        .sys_rstn(rst_ps7_0_80M_peripheral_aresetn1));
  system_axi_dma_0_1 axi_dma_0
       (.axi_resetn(rst_ps7_0_80M_peripheral_aresetn1),
        .m_axi_s2mm_aclk(processing_system7_0_FCLK_CLK0),
        .m_axi_s2mm_awaddr(axi_dma_0_M_AXI_S2MM_AWADDR),
        .m_axi_s2mm_awburst(axi_dma_0_M_AXI_S2MM_AWBURST),
        .m_axi_s2mm_awcache(axi_dma_0_M_AXI_S2MM_AWCACHE),
        .m_axi_s2mm_awlen(axi_dma_0_M_AXI_S2MM_AWLEN),
        .m_axi_s2mm_awprot(axi_dma_0_M_AXI_S2MM_AWPROT),
        .m_axi_s2mm_awready(axi_dma_0_M_AXI_S2MM_AWREADY),
        .m_axi_s2mm_awsize(axi_dma_0_M_AXI_S2MM_AWSIZE),
        .m_axi_s2mm_awvalid(axi_dma_0_M_AXI_S2MM_AWVALID),
        .m_axi_s2mm_bready(axi_dma_0_M_AXI_S2MM_BREADY),
        .m_axi_s2mm_bresp(axi_dma_0_M_AXI_S2MM_BRESP),
        .m_axi_s2mm_bvalid(axi_dma_0_M_AXI_S2MM_BVALID),
        .m_axi_s2mm_wdata(axi_dma_0_M_AXI_S2MM_WDATA),
        .m_axi_s2mm_wlast(axi_dma_0_M_AXI_S2MM_WLAST),
        .m_axi_s2mm_wready(axi_dma_0_M_AXI_S2MM_WREADY),
        .m_axi_s2mm_wstrb(axi_dma_0_M_AXI_S2MM_WSTRB),
        .m_axi_s2mm_wvalid(axi_dma_0_M_AXI_S2MM_WVALID),
        .s2mm_introut(axi_dma_0_s2mm_introut),
        .s2mm_prmry_reset_out_n(axi_dma_0_s2mm_prmry_reset_out_n),
        .s_axi_lite_aclk(processing_system7_0_FCLK_CLK0),
        .s_axi_lite_araddr(ps7_0_axi_periph_M00_AXI_ARADDR[9:0]),
        .s_axi_lite_arready(ps7_0_axi_periph_M00_AXI_ARREADY),
        .s_axi_lite_arvalid(ps7_0_axi_periph_M00_AXI_ARVALID),
        .s_axi_lite_awaddr(ps7_0_axi_periph_M00_AXI_AWADDR[9:0]),
        .s_axi_lite_awready(ps7_0_axi_periph_M00_AXI_AWREADY),
        .s_axi_lite_awvalid(ps7_0_axi_periph_M00_AXI_AWVALID),
        .s_axi_lite_bready(ps7_0_axi_periph_M00_AXI_BREADY),
        .s_axi_lite_bresp(ps7_0_axi_periph_M00_AXI_BRESP),
        .s_axi_lite_bvalid(ps7_0_axi_periph_M00_AXI_BVALID),
        .s_axi_lite_rdata(ps7_0_axi_periph_M00_AXI_RDATA),
        .s_axi_lite_rready(ps7_0_axi_periph_M00_AXI_RREADY),
        .s_axi_lite_rresp(ps7_0_axi_periph_M00_AXI_RRESP),
        .s_axi_lite_rvalid(ps7_0_axi_periph_M00_AXI_RVALID),
        .s_axi_lite_wdata(ps7_0_axi_periph_M00_AXI_WDATA),
        .s_axi_lite_wready(ps7_0_axi_periph_M00_AXI_WREADY),
        .s_axi_lite_wvalid(ps7_0_axi_periph_M00_AXI_WVALID),
        .s_axis_s2mm_tdata(dmca_ip_0_M00_AXIS_TDATA),
        .s_axis_s2mm_tkeep({1'b1,1'b1,1'b1,1'b1}),
        .s_axis_s2mm_tlast(dmca_ip_0_M00_AXIS_TLAST),
        .s_axis_s2mm_tready(dmca_ip_0_M00_AXIS_TREADY),
        .s_axis_s2mm_tvalid(dmca_ip_0_M00_AXIS_TVALID));
  system_axi_mem_intercon_1 axi_mem_intercon
       (.ACLK(processing_system7_0_FCLK_CLK0),
        .ARESETN(rst_ps7_0_80M_peripheral_aresetn1),
        .M00_ACLK(processing_system7_0_FCLK_CLK0),
        .M00_ARESETN(rst_ps7_0_80M_peripheral_aresetn1),
        .M00_AXI_araddr(axi_mem_intercon_M00_AXI_ARADDR),
        .M00_AXI_arburst(axi_mem_intercon_M00_AXI_ARBURST),
        .M00_AXI_arcache(axi_mem_intercon_M00_AXI_ARCACHE),
        .M00_AXI_arlen(axi_mem_intercon_M00_AXI_ARLEN),
        .M00_AXI_arlock(axi_mem_intercon_M00_AXI_ARLOCK),
        .M00_AXI_arprot(axi_mem_intercon_M00_AXI_ARPROT),
        .M00_AXI_arqos(axi_mem_intercon_M00_AXI_ARQOS),
        .M00_AXI_arready(axi_mem_intercon_M00_AXI_ARREADY),
        .M00_AXI_arsize(axi_mem_intercon_M00_AXI_ARSIZE),
        .M00_AXI_arvalid(axi_mem_intercon_M00_AXI_ARVALID),
        .M00_AXI_awaddr(axi_mem_intercon_M00_AXI_AWADDR),
        .M00_AXI_awburst(axi_mem_intercon_M00_AXI_AWBURST),
        .M00_AXI_awcache(axi_mem_intercon_M00_AXI_AWCACHE),
        .M00_AXI_awlen(axi_mem_intercon_M00_AXI_AWLEN),
        .M00_AXI_awlock(axi_mem_intercon_M00_AXI_AWLOCK),
        .M00_AXI_awprot(axi_mem_intercon_M00_AXI_AWPROT),
        .M00_AXI_awqos(axi_mem_intercon_M00_AXI_AWQOS),
        .M00_AXI_awready(axi_mem_intercon_M00_AXI_AWREADY),
        .M00_AXI_awsize(axi_mem_intercon_M00_AXI_AWSIZE),
        .M00_AXI_awvalid(axi_mem_intercon_M00_AXI_AWVALID),
        .M00_AXI_bready(axi_mem_intercon_M00_AXI_BREADY),
        .M00_AXI_bresp(axi_mem_intercon_M00_AXI_BRESP),
        .M00_AXI_bvalid(axi_mem_intercon_M00_AXI_BVALID),
        .M00_AXI_rdata(axi_mem_intercon_M00_AXI_RDATA),
        .M00_AXI_rlast(axi_mem_intercon_M00_AXI_RLAST),
        .M00_AXI_rready(axi_mem_intercon_M00_AXI_RREADY),
        .M00_AXI_rresp(axi_mem_intercon_M00_AXI_RRESP),
        .M00_AXI_rvalid(axi_mem_intercon_M00_AXI_RVALID),
        .M00_AXI_wdata(axi_mem_intercon_M00_AXI_WDATA),
        .M00_AXI_wlast(axi_mem_intercon_M00_AXI_WLAST),
        .M00_AXI_wready(axi_mem_intercon_M00_AXI_WREADY),
        .M00_AXI_wstrb(axi_mem_intercon_M00_AXI_WSTRB),
        .M00_AXI_wvalid(axi_mem_intercon_M00_AXI_WVALID),
        .S00_ACLK(processing_system7_0_FCLK_CLK0),
        .S00_ARESETN(rst_ps7_0_80M_peripheral_aresetn1),
        .S00_AXI_awaddr(axi_dma_0_M_AXI_S2MM_AWADDR),
        .S00_AXI_awburst(axi_dma_0_M_AXI_S2MM_AWBURST),
        .S00_AXI_awcache(axi_dma_0_M_AXI_S2MM_AWCACHE),
        .S00_AXI_awlen(axi_dma_0_M_AXI_S2MM_AWLEN),
        .S00_AXI_awprot(axi_dma_0_M_AXI_S2MM_AWPROT),
        .S00_AXI_awready(axi_dma_0_M_AXI_S2MM_AWREADY),
        .S00_AXI_awsize(axi_dma_0_M_AXI_S2MM_AWSIZE),
        .S00_AXI_awvalid(axi_dma_0_M_AXI_S2MM_AWVALID),
        .S00_AXI_bready(axi_dma_0_M_AXI_S2MM_BREADY),
        .S00_AXI_bresp(axi_dma_0_M_AXI_S2MM_BRESP),
        .S00_AXI_bvalid(axi_dma_0_M_AXI_S2MM_BVALID),
        .S00_AXI_wdata(axi_dma_0_M_AXI_S2MM_WDATA),
        .S00_AXI_wlast(axi_dma_0_M_AXI_S2MM_WLAST),
        .S00_AXI_wready(axi_dma_0_M_AXI_S2MM_WREADY),
        .S00_AXI_wstrb(axi_dma_0_M_AXI_S2MM_WSTRB),
        .S00_AXI_wvalid(axi_dma_0_M_AXI_S2MM_WVALID));
  system_axi_uartlite_0_0 axi_uartlite_0
       (.interrupt(axi_uartlite_0_interrupt),
        .rx(axi_uartlite_0_UART_RxD),
        .s_axi_aclk(processing_system7_0_FCLK_CLK0),
        .s_axi_araddr(ps7_0_axi_periph_M01_AXI_ARADDR[3:0]),
        .s_axi_aresetn(rst_ps7_0_80M_peripheral_aresetn1),
        .s_axi_arready(ps7_0_axi_periph_M01_AXI_ARREADY),
        .s_axi_arvalid(ps7_0_axi_periph_M01_AXI_ARVALID),
        .s_axi_awaddr(ps7_0_axi_periph_M01_AXI_AWADDR[3:0]),
        .s_axi_awready(ps7_0_axi_periph_M01_AXI_AWREADY),
        .s_axi_awvalid(ps7_0_axi_periph_M01_AXI_AWVALID),
        .s_axi_bready(ps7_0_axi_periph_M01_AXI_BREADY),
        .s_axi_bresp(ps7_0_axi_periph_M01_AXI_BRESP),
        .s_axi_bvalid(ps7_0_axi_periph_M01_AXI_BVALID),
        .s_axi_rdata(ps7_0_axi_periph_M01_AXI_RDATA),
        .s_axi_rready(ps7_0_axi_periph_M01_AXI_RREADY),
        .s_axi_rresp(ps7_0_axi_periph_M01_AXI_RRESP),
        .s_axi_rvalid(ps7_0_axi_periph_M01_AXI_RVALID),
        .s_axi_wdata(ps7_0_axi_periph_M01_AXI_WDATA),
        .s_axi_wready(ps7_0_axi_periph_M01_AXI_WREADY),
        .s_axi_wstrb(ps7_0_axi_periph_M01_AXI_WSTRB),
        .s_axi_wvalid(ps7_0_axi_periph_M01_AXI_WVALID),
        .tx(axi_uartlite_0_UART_TxD));
  system_clk_wiz_0_1 clk_wiz_1
       (.clk_in1(processing_system7_0_FCLK_CLK0),
        .clk_out1(clk_wiz_1_clk_out1),
        .resetn(rst_ps7_0_80M_peripheral_aresetn1));
  system_dmca_ip_0_0 dmca_ip_0
       (.M_AXIS_ARESETN(axi_dma_0_s2mm_prmry_reset_out_n),
        .M_AXIS_TDATA(dmca_ip_0_M00_AXIS_TDATA),
        .M_AXIS_TLAST(dmca_ip_0_M00_AXIS_TLAST),
        .M_AXIS_TREADY(dmca_ip_0_M00_AXIS_TREADY),
        .M_AXIS_TVALID(dmca_ip_0_M00_AXIS_TVALID),
        .adc_datain(adc_datain_1),
        .adc_dataout(dmca_ip_0_adc_dataout),
        .adc_fir_datain(adc_fir_0_adc_fir_dataout),
        .adc_pwr_en(dmca_ip_0_adc_pwr_en),
        .s00_axi_araddr(ps7_0_axi_periph_M02_AXI_ARADDR[4:0]),
        .s00_axi_arprot(ps7_0_axi_periph_M02_AXI_ARPROT),
        .s00_axi_arready(ps7_0_axi_periph_M02_AXI_ARREADY),
        .s00_axi_arvalid(ps7_0_axi_periph_M02_AXI_ARVALID),
        .s00_axi_awaddr(ps7_0_axi_periph_M02_AXI_AWADDR[4:0]),
        .s00_axi_awprot(ps7_0_axi_periph_M02_AXI_AWPROT),
        .s00_axi_awready(ps7_0_axi_periph_M02_AXI_AWREADY),
        .s00_axi_awvalid(ps7_0_axi_periph_M02_AXI_AWVALID),
        .s00_axi_bready(ps7_0_axi_periph_M02_AXI_BREADY),
        .s00_axi_bresp(ps7_0_axi_periph_M02_AXI_BRESP),
        .s00_axi_bvalid(ps7_0_axi_periph_M02_AXI_BVALID),
        .s00_axi_rdata(ps7_0_axi_periph_M02_AXI_RDATA),
        .s00_axi_rready(ps7_0_axi_periph_M02_AXI_RREADY),
        .s00_axi_rresp(ps7_0_axi_periph_M02_AXI_RRESP),
        .s00_axi_rvalid(ps7_0_axi_periph_M02_AXI_RVALID),
        .s00_axi_wdata(ps7_0_axi_periph_M02_AXI_WDATA),
        .s00_axi_wready(ps7_0_axi_periph_M02_AXI_WREADY),
        .s00_axi_wstrb(ps7_0_axi_periph_M02_AXI_WSTRB),
        .s00_axi_wvalid(ps7_0_axi_periph_M02_AXI_WVALID),
        .sys_clk(processing_system7_0_FCLK_CLK0),
        .sys_rstn(rst_ps7_0_80M_peripheral_aresetn1),
        .trapezd_data(dmca_ip_0_trapezd_data),
        .triangle_data(dmca_ip_0_triangle_data));
  system_ila_0_0 ila_0
       (.clk(processing_system7_0_FCLK_CLK0),
        .probe0(dmca_ip_0_trapezd_data),
        .probe1(dmca_ip_0_triangle_data),
        .probe2(adc_fir_0_adc_fir_dataout));
  system_processing_system7_0_0 processing_system7_0
       (.DDR_Addr(DDR_addr[14:0]),
        .DDR_BankAddr(DDR_ba[2:0]),
        .DDR_CAS_n(DDR_cas_n),
        .DDR_CKE(DDR_cke),
        .DDR_CS_n(DDR_cs_n),
        .DDR_Clk(DDR_ck_p),
        .DDR_Clk_n(DDR_ck_n),
        .DDR_DM(DDR_dm[3:0]),
        .DDR_DQ(DDR_dq[31:0]),
        .DDR_DQS(DDR_dqs_p[3:0]),
        .DDR_DQS_n(DDR_dqs_n[3:0]),
        .DDR_DRSTB(DDR_reset_n),
        .DDR_ODT(DDR_odt),
        .DDR_RAS_n(DDR_ras_n),
        .DDR_VRN(FIXED_IO_ddr_vrn),
        .DDR_VRP(FIXED_IO_ddr_vrp),
        .DDR_WEB(DDR_we_n),
        .FCLK_CLK0(processing_system7_0_FCLK_CLK0),
        .FCLK_RESET0_N(processing_system7_0_FCLK_RESET0_N),
        .GPIO_I(processing_system7_0_GPIO_0_TRI_I),
        .GPIO_O(processing_system7_0_GPIO_0_TRI_O),
        .GPIO_T(processing_system7_0_GPIO_0_TRI_T),
        .IRQ_F2P(xlconcat_0_dout),
        .MIO(FIXED_IO_mio[53:0]),
        .M_AXI_GP0_ACLK(processing_system7_0_FCLK_CLK0),
        .M_AXI_GP0_ARADDR(processing_system7_0_M_AXI_GP0_ARADDR),
        .M_AXI_GP0_ARBURST(processing_system7_0_M_AXI_GP0_ARBURST),
        .M_AXI_GP0_ARCACHE(processing_system7_0_M_AXI_GP0_ARCACHE),
        .M_AXI_GP0_ARLEN(processing_system7_0_M_AXI_GP0_ARLEN),
        .M_AXI_GP0_ARLOCK(processing_system7_0_M_AXI_GP0_ARLOCK),
        .M_AXI_GP0_ARPROT(processing_system7_0_M_AXI_GP0_ARPROT),
        .M_AXI_GP0_ARQOS(processing_system7_0_M_AXI_GP0_ARQOS),
        .M_AXI_GP0_ARREADY(processing_system7_0_M_AXI_GP0_ARREADY),
        .M_AXI_GP0_ARSIZE(processing_system7_0_M_AXI_GP0_ARSIZE),
        .M_AXI_GP0_ARVALID(processing_system7_0_M_AXI_GP0_ARVALID),
        .M_AXI_GP0_AWADDR(processing_system7_0_M_AXI_GP0_AWADDR),
        .M_AXI_GP0_AWBURST(processing_system7_0_M_AXI_GP0_AWBURST),
        .M_AXI_GP0_AWCACHE(processing_system7_0_M_AXI_GP0_AWCACHE),
        .M_AXI_GP0_AWLEN(processing_system7_0_M_AXI_GP0_AWLEN),
        .M_AXI_GP0_AWLOCK(processing_system7_0_M_AXI_GP0_AWLOCK),
        .M_AXI_GP0_AWPROT(processing_system7_0_M_AXI_GP0_AWPROT),
        .M_AXI_GP0_AWQOS(processing_system7_0_M_AXI_GP0_AWQOS),
        .M_AXI_GP0_AWREADY(processing_system7_0_M_AXI_GP0_AWREADY),
        .M_AXI_GP0_AWSIZE(processing_system7_0_M_AXI_GP0_AWSIZE),
        .M_AXI_GP0_AWVALID(processing_system7_0_M_AXI_GP0_AWVALID),
        .M_AXI_GP0_BID({1'b0,1'b0,1'b0,1'b0,1'b0,1'b0,1'b0,1'b0,1'b0,1'b0,1'b0,1'b0}),
        .M_AXI_GP0_BREADY(processing_system7_0_M_AXI_GP0_BREADY),
        .M_AXI_GP0_BRESP(processing_system7_0_M_AXI_GP0_BRESP),
        .M_AXI_GP0_BVALID(processing_system7_0_M_AXI_GP0_BVALID),
        .M_AXI_GP0_RDATA(processing_system7_0_M_AXI_GP0_RDATA),
        .M_AXI_GP0_RID({1'b0,1'b0,1'b0,1'b0,1'b0,1'b0,1'b0,1'b0,1'b0,1'b0,1'b0,1'b0}),
        .M_AXI_GP0_RLAST(processing_system7_0_M_AXI_GP0_RLAST),
        .M_AXI_GP0_RREADY(processing_system7_0_M_AXI_GP0_RREADY),
        .M_AXI_GP0_RRESP(processing_system7_0_M_AXI_GP0_RRESP),
        .M_AXI_GP0_RVALID(processing_system7_0_M_AXI_GP0_RVALID),
        .M_AXI_GP0_WDATA(processing_system7_0_M_AXI_GP0_WDATA),
        .M_AXI_GP0_WLAST(processing_system7_0_M_AXI_GP0_WLAST),
        .M_AXI_GP0_WREADY(processing_system7_0_M_AXI_GP0_WREADY),
        .M_AXI_GP0_WSTRB(processing_system7_0_M_AXI_GP0_WSTRB),
        .M_AXI_GP0_WVALID(processing_system7_0_M_AXI_GP0_WVALID),
        .PS_CLK(FIXED_IO_ps_clk),
        .PS_PORB(FIXED_IO_ps_porb),
        .PS_SRSTB(FIXED_IO_ps_srstb),
        .S_AXI_HP0_ACLK(processing_system7_0_FCLK_CLK0),
        .S_AXI_HP0_ARADDR(axi_mem_intercon_M00_AXI_ARADDR),
        .S_AXI_HP0_ARBURST(axi_mem_intercon_M00_AXI_ARBURST),
        .S_AXI_HP0_ARCACHE(axi_mem_intercon_M00_AXI_ARCACHE),
        .S_AXI_HP0_ARID({1'b0,1'b0,1'b0,1'b0,1'b0,1'b0}),
        .S_AXI_HP0_ARLEN(axi_mem_intercon_M00_AXI_ARLEN[3:0]),
        .S_AXI_HP0_ARLOCK({1'b0,axi_mem_intercon_M00_AXI_ARLOCK}),
        .S_AXI_HP0_ARPROT(axi_mem_intercon_M00_AXI_ARPROT),
        .S_AXI_HP0_ARQOS(axi_mem_intercon_M00_AXI_ARQOS),
        .S_AXI_HP0_ARREADY(axi_mem_intercon_M00_AXI_ARREADY),
        .S_AXI_HP0_ARSIZE(axi_mem_intercon_M00_AXI_ARSIZE),
        .S_AXI_HP0_ARVALID(axi_mem_intercon_M00_AXI_ARVALID),
        .S_AXI_HP0_AWADDR(axi_mem_intercon_M00_AXI_AWADDR),
        .S_AXI_HP0_AWBURST(axi_mem_intercon_M00_AXI_AWBURST),
        .S_AXI_HP0_AWCACHE(axi_mem_intercon_M00_AXI_AWCACHE),
        .S_AXI_HP0_AWID({1'b0,1'b0,1'b0,1'b0,1'b0,1'b0}),
        .S_AXI_HP0_AWLEN(axi_mem_intercon_M00_AXI_AWLEN[3:0]),
        .S_AXI_HP0_AWLOCK({1'b0,axi_mem_intercon_M00_AXI_AWLOCK}),
        .S_AXI_HP0_AWPROT(axi_mem_intercon_M00_AXI_AWPROT),
        .S_AXI_HP0_AWQOS(axi_mem_intercon_M00_AXI_AWQOS),
        .S_AXI_HP0_AWREADY(axi_mem_intercon_M00_AXI_AWREADY),
        .S_AXI_HP0_AWSIZE(axi_mem_intercon_M00_AXI_AWSIZE),
        .S_AXI_HP0_AWVALID(axi_mem_intercon_M00_AXI_AWVALID),
        .S_AXI_HP0_BREADY(axi_mem_intercon_M00_AXI_BREADY),
        .S_AXI_HP0_BRESP(axi_mem_intercon_M00_AXI_BRESP),
        .S_AXI_HP0_BVALID(axi_mem_intercon_M00_AXI_BVALID),
        .S_AXI_HP0_RDATA(axi_mem_intercon_M00_AXI_RDATA),
        .S_AXI_HP0_RDISSUECAP1_EN(1'b0),
        .S_AXI_HP0_RLAST(axi_mem_intercon_M00_AXI_RLAST),
        .S_AXI_HP0_RREADY(axi_mem_intercon_M00_AXI_RREADY),
        .S_AXI_HP0_RRESP(axi_mem_intercon_M00_AXI_RRESP),
        .S_AXI_HP0_RVALID(axi_mem_intercon_M00_AXI_RVALID),
        .S_AXI_HP0_WDATA(axi_mem_intercon_M00_AXI_WDATA),
        .S_AXI_HP0_WID({1'b0,1'b0,1'b0,1'b0,1'b0,1'b0}),
        .S_AXI_HP0_WLAST(axi_mem_intercon_M00_AXI_WLAST),
        .S_AXI_HP0_WREADY(axi_mem_intercon_M00_AXI_WREADY),
        .S_AXI_HP0_WRISSUECAP1_EN(1'b0),
        .S_AXI_HP0_WSTRB(axi_mem_intercon_M00_AXI_WSTRB),
        .S_AXI_HP0_WVALID(axi_mem_intercon_M00_AXI_WVALID));
  system_ps7_0_axi_periph_2 ps7_0_axi_periph
       (.ACLK(processing_system7_0_FCLK_CLK0),
        .ARESETN(rst_ps7_0_80M_peripheral_aresetn1),
        .M00_ACLK(processing_system7_0_FCLK_CLK0),
        .M00_ARESETN(rst_ps7_0_80M_peripheral_aresetn1),
        .M00_AXI_araddr(ps7_0_axi_periph_M00_AXI_ARADDR),
        .M00_AXI_arready(ps7_0_axi_periph_M00_AXI_ARREADY),
        .M00_AXI_arvalid(ps7_0_axi_periph_M00_AXI_ARVALID),
        .M00_AXI_awaddr(ps7_0_axi_periph_M00_AXI_AWADDR),
        .M00_AXI_awready(ps7_0_axi_periph_M00_AXI_AWREADY),
        .M00_AXI_awvalid(ps7_0_axi_periph_M00_AXI_AWVALID),
        .M00_AXI_bready(ps7_0_axi_periph_M00_AXI_BREADY),
        .M00_AXI_bresp(ps7_0_axi_periph_M00_AXI_BRESP),
        .M00_AXI_bvalid(ps7_0_axi_periph_M00_AXI_BVALID),
        .M00_AXI_rdata(ps7_0_axi_periph_M00_AXI_RDATA),
        .M00_AXI_rready(ps7_0_axi_periph_M00_AXI_RREADY),
        .M00_AXI_rresp(ps7_0_axi_periph_M00_AXI_RRESP),
        .M00_AXI_rvalid(ps7_0_axi_periph_M00_AXI_RVALID),
        .M00_AXI_wdata(ps7_0_axi_periph_M00_AXI_WDATA),
        .M00_AXI_wready(ps7_0_axi_periph_M00_AXI_WREADY),
        .M00_AXI_wvalid(ps7_0_axi_periph_M00_AXI_WVALID),
        .M01_ACLK(processing_system7_0_FCLK_CLK0),
        .M01_ARESETN(rst_ps7_0_80M_peripheral_aresetn1),
        .M01_AXI_araddr(ps7_0_axi_periph_M01_AXI_ARADDR),
        .M01_AXI_arready(ps7_0_axi_periph_M01_AXI_ARREADY),
        .M01_AXI_arvalid(ps7_0_axi_periph_M01_AXI_ARVALID),
        .M01_AXI_awaddr(ps7_0_axi_periph_M01_AXI_AWADDR),
        .M01_AXI_awready(ps7_0_axi_periph_M01_AXI_AWREADY),
        .M01_AXI_awvalid(ps7_0_axi_periph_M01_AXI_AWVALID),
        .M01_AXI_bready(ps7_0_axi_periph_M01_AXI_BREADY),
        .M01_AXI_bresp(ps7_0_axi_periph_M01_AXI_BRESP),
        .M01_AXI_bvalid(ps7_0_axi_periph_M01_AXI_BVALID),
        .M01_AXI_rdata(ps7_0_axi_periph_M01_AXI_RDATA),
        .M01_AXI_rready(ps7_0_axi_periph_M01_AXI_RREADY),
        .M01_AXI_rresp(ps7_0_axi_periph_M01_AXI_RRESP),
        .M01_AXI_rvalid(ps7_0_axi_periph_M01_AXI_RVALID),
        .M01_AXI_wdata(ps7_0_axi_periph_M01_AXI_WDATA),
        .M01_AXI_wready(ps7_0_axi_periph_M01_AXI_WREADY),
        .M01_AXI_wstrb(ps7_0_axi_periph_M01_AXI_WSTRB),
        .M01_AXI_wvalid(ps7_0_axi_periph_M01_AXI_WVALID),
        .M02_ACLK(processing_system7_0_FCLK_CLK0),
        .M02_ARESETN(rst_ps7_0_80M_peripheral_aresetn1),
        .M02_AXI_araddr(ps7_0_axi_periph_M02_AXI_ARADDR),
        .M02_AXI_arprot(ps7_0_axi_periph_M02_AXI_ARPROT),
        .M02_AXI_arready(ps7_0_axi_periph_M02_AXI_ARREADY),
        .M02_AXI_arvalid(ps7_0_axi_periph_M02_AXI_ARVALID),
        .M02_AXI_awaddr(ps7_0_axi_periph_M02_AXI_AWADDR),
        .M02_AXI_awprot(ps7_0_axi_periph_M02_AXI_AWPROT),
        .M02_AXI_awready(ps7_0_axi_periph_M02_AXI_AWREADY),
        .M02_AXI_awvalid(ps7_0_axi_periph_M02_AXI_AWVALID),
        .M02_AXI_bready(ps7_0_axi_periph_M02_AXI_BREADY),
        .M02_AXI_bresp(ps7_0_axi_periph_M02_AXI_BRESP),
        .M02_AXI_bvalid(ps7_0_axi_periph_M02_AXI_BVALID),
        .M02_AXI_rdata(ps7_0_axi_periph_M02_AXI_RDATA),
        .M02_AXI_rready(ps7_0_axi_periph_M02_AXI_RREADY),
        .M02_AXI_rresp(ps7_0_axi_periph_M02_AXI_RRESP),
        .M02_AXI_rvalid(ps7_0_axi_periph_M02_AXI_RVALID),
        .M02_AXI_wdata(ps7_0_axi_periph_M02_AXI_WDATA),
        .M02_AXI_wready(ps7_0_axi_periph_M02_AXI_WREADY),
        .M02_AXI_wstrb(ps7_0_axi_periph_M02_AXI_WSTRB),
        .M02_AXI_wvalid(ps7_0_axi_periph_M02_AXI_WVALID),
        .S00_ACLK(processing_system7_0_FCLK_CLK0),
        .S00_ARESETN(rst_ps7_0_80M_peripheral_aresetn1),
        .S00_AXI_araddr(processing_system7_0_M_AXI_GP0_ARADDR),
        .S00_AXI_arburst(processing_system7_0_M_AXI_GP0_ARBURST),
        .S00_AXI_arcache(processing_system7_0_M_AXI_GP0_ARCACHE),
        .S00_AXI_arlen(processing_system7_0_M_AXI_GP0_ARLEN),
        .S00_AXI_arlock(processing_system7_0_M_AXI_GP0_ARLOCK),
        .S00_AXI_arprot(processing_system7_0_M_AXI_GP0_ARPROT),
        .S00_AXI_arqos(processing_system7_0_M_AXI_GP0_ARQOS),
        .S00_AXI_arready(processing_system7_0_M_AXI_GP0_ARREADY),
        .S00_AXI_arsize(processing_system7_0_M_AXI_GP0_ARSIZE),
        .S00_AXI_arvalid(processing_system7_0_M_AXI_GP0_ARVALID),
        .S00_AXI_awaddr(processing_system7_0_M_AXI_GP0_AWADDR),
        .S00_AXI_awburst(processing_system7_0_M_AXI_GP0_AWBURST),
        .S00_AXI_awcache(processing_system7_0_M_AXI_GP0_AWCACHE),
        .S00_AXI_awlen(processing_system7_0_M_AXI_GP0_AWLEN),
        .S00_AXI_awlock(processing_system7_0_M_AXI_GP0_AWLOCK),
        .S00_AXI_awprot(processing_system7_0_M_AXI_GP0_AWPROT),
        .S00_AXI_awqos(processing_system7_0_M_AXI_GP0_AWQOS),
        .S00_AXI_awready(processing_system7_0_M_AXI_GP0_AWREADY),
        .S00_AXI_awsize(processing_system7_0_M_AXI_GP0_AWSIZE),
        .S00_AXI_awvalid(processing_system7_0_M_AXI_GP0_AWVALID),
        .S00_AXI_bready(processing_system7_0_M_AXI_GP0_BREADY),
        .S00_AXI_bresp(processing_system7_0_M_AXI_GP0_BRESP),
        .S00_AXI_bvalid(processing_system7_0_M_AXI_GP0_BVALID),
        .S00_AXI_rdata(processing_system7_0_M_AXI_GP0_RDATA),
        .S00_AXI_rlast(processing_system7_0_M_AXI_GP0_RLAST),
        .S00_AXI_rready(processing_system7_0_M_AXI_GP0_RREADY),
        .S00_AXI_rresp(processing_system7_0_M_AXI_GP0_RRESP),
        .S00_AXI_rvalid(processing_system7_0_M_AXI_GP0_RVALID),
        .S00_AXI_wdata(processing_system7_0_M_AXI_GP0_WDATA),
        .S00_AXI_wlast(processing_system7_0_M_AXI_GP0_WLAST),
        .S00_AXI_wready(processing_system7_0_M_AXI_GP0_WREADY),
        .S00_AXI_wstrb(processing_system7_0_M_AXI_GP0_WSTRB),
        .S00_AXI_wvalid(processing_system7_0_M_AXI_GP0_WVALID));
  system_rst_ps7_0_80M_2 rst_ps7_0_80M
       (.aux_reset_in(1'b1),
        .dcm_locked(1'b1),
        .ext_reset_in(processing_system7_0_FCLK_RESET0_N),
        .mb_debug_sys_rst(1'b0),
        .peripheral_aresetn(rst_ps7_0_80M_peripheral_aresetn1),
        .slowest_sync_clk(processing_system7_0_FCLK_CLK0));
  system_xlconcat_0_0 xlconcat_0
       (.In0(axi_dma_0_s2mm_introut),
        .In1(axi_uartlite_0_interrupt),
        .dout(xlconcat_0_dout));
endmodule

module system_axi_mem_intercon_1
   (ACLK,
    ARESETN,
    M00_ACLK,
    M00_ARESETN,
    M00_AXI_araddr,
    M00_AXI_arburst,
    M00_AXI_arcache,
    M00_AXI_arlen,
    M00_AXI_arlock,
    M00_AXI_arprot,
    M00_AXI_arqos,
    M00_AXI_arready,
    M00_AXI_arsize,
    M00_AXI_arvalid,
    M00_AXI_awaddr,
    M00_AXI_awburst,
    M00_AXI_awcache,
    M00_AXI_awlen,
    M00_AXI_awlock,
    M00_AXI_awprot,
    M00_AXI_awqos,
    M00_AXI_awready,
    M00_AXI_awsize,
    M00_AXI_awvalid,
    M00_AXI_bready,
    M00_AXI_bresp,
    M00_AXI_bvalid,
    M00_AXI_rdata,
    M00_AXI_rlast,
    M00_AXI_rready,
    M00_AXI_rresp,
    M00_AXI_rvalid,
    M00_AXI_wdata,
    M00_AXI_wlast,
    M00_AXI_wready,
    M00_AXI_wstrb,
    M00_AXI_wvalid,
    S00_ACLK,
    S00_ARESETN,
    S00_AXI_awaddr,
    S00_AXI_awburst,
    S00_AXI_awcache,
    S00_AXI_awlen,
    S00_AXI_awprot,
    S00_AXI_awready,
    S00_AXI_awsize,
    S00_AXI_awvalid,
    S00_AXI_bready,
    S00_AXI_bresp,
    S00_AXI_bvalid,
    S00_AXI_wdata,
    S00_AXI_wlast,
    S00_AXI_wready,
    S00_AXI_wstrb,
    S00_AXI_wvalid);
  input ACLK;
  input ARESETN;
  input M00_ACLK;
  input M00_ARESETN;
  output [31:0]M00_AXI_araddr;
  output [1:0]M00_AXI_arburst;
  output [3:0]M00_AXI_arcache;
  output [7:0]M00_AXI_arlen;
  output [0:0]M00_AXI_arlock;
  output [2:0]M00_AXI_arprot;
  output [3:0]M00_AXI_arqos;
  input M00_AXI_arready;
  output [2:0]M00_AXI_arsize;
  output M00_AXI_arvalid;
  output [31:0]M00_AXI_awaddr;
  output [1:0]M00_AXI_awburst;
  output [3:0]M00_AXI_awcache;
  output [7:0]M00_AXI_awlen;
  output [0:0]M00_AXI_awlock;
  output [2:0]M00_AXI_awprot;
  output [3:0]M00_AXI_awqos;
  input M00_AXI_awready;
  output [2:0]M00_AXI_awsize;
  output M00_AXI_awvalid;
  output M00_AXI_bready;
  input [1:0]M00_AXI_bresp;
  input M00_AXI_bvalid;
  input [63:0]M00_AXI_rdata;
  input M00_AXI_rlast;
  output M00_AXI_rready;
  input [1:0]M00_AXI_rresp;
  input M00_AXI_rvalid;
  output [63:0]M00_AXI_wdata;
  output M00_AXI_wlast;
  input M00_AXI_wready;
  output [7:0]M00_AXI_wstrb;
  output M00_AXI_wvalid;
  input S00_ACLK;
  input S00_ARESETN;
  input [31:0]S00_AXI_awaddr;
  input [1:0]S00_AXI_awburst;
  input [3:0]S00_AXI_awcache;
  input [7:0]S00_AXI_awlen;
  input [2:0]S00_AXI_awprot;
  output S00_AXI_awready;
  input [2:0]S00_AXI_awsize;
  input S00_AXI_awvalid;
  input S00_AXI_bready;
  output [1:0]S00_AXI_bresp;
  output S00_AXI_bvalid;
  input [31:0]S00_AXI_wdata;
  input S00_AXI_wlast;
  output S00_AXI_wready;
  input [3:0]S00_AXI_wstrb;
  input S00_AXI_wvalid;

  wire S00_ACLK_1;
  wire S00_ARESETN_1;
  wire axi_mem_intercon_ACLK_net;
  wire axi_mem_intercon_ARESETN_net;
  wire [31:0]axi_mem_intercon_to_s00_couplers_AWADDR;
  wire [1:0]axi_mem_intercon_to_s00_couplers_AWBURST;
  wire [3:0]axi_mem_intercon_to_s00_couplers_AWCACHE;
  wire [7:0]axi_mem_intercon_to_s00_couplers_AWLEN;
  wire [2:0]axi_mem_intercon_to_s00_couplers_AWPROT;
  wire axi_mem_intercon_to_s00_couplers_AWREADY;
  wire [2:0]axi_mem_intercon_to_s00_couplers_AWSIZE;
  wire axi_mem_intercon_to_s00_couplers_AWVALID;
  wire axi_mem_intercon_to_s00_couplers_BREADY;
  wire [1:0]axi_mem_intercon_to_s00_couplers_BRESP;
  wire axi_mem_intercon_to_s00_couplers_BVALID;
  wire [31:0]axi_mem_intercon_to_s00_couplers_WDATA;
  wire axi_mem_intercon_to_s00_couplers_WLAST;
  wire axi_mem_intercon_to_s00_couplers_WREADY;
  wire [3:0]axi_mem_intercon_to_s00_couplers_WSTRB;
  wire axi_mem_intercon_to_s00_couplers_WVALID;
  wire [31:0]s00_couplers_to_axi_mem_intercon_ARADDR;
  wire [1:0]s00_couplers_to_axi_mem_intercon_ARBURST;
  wire [3:0]s00_couplers_to_axi_mem_intercon_ARCACHE;
  wire [7:0]s00_couplers_to_axi_mem_intercon_ARLEN;
  wire [0:0]s00_couplers_to_axi_mem_intercon_ARLOCK;
  wire [2:0]s00_couplers_to_axi_mem_intercon_ARPROT;
  wire [3:0]s00_couplers_to_axi_mem_intercon_ARQOS;
  wire s00_couplers_to_axi_mem_intercon_ARREADY;
  wire [2:0]s00_couplers_to_axi_mem_intercon_ARSIZE;
  wire s00_couplers_to_axi_mem_intercon_ARVALID;
  wire [31:0]s00_couplers_to_axi_mem_intercon_AWADDR;
  wire [1:0]s00_couplers_to_axi_mem_intercon_AWBURST;
  wire [3:0]s00_couplers_to_axi_mem_intercon_AWCACHE;
  wire [7:0]s00_couplers_to_axi_mem_intercon_AWLEN;
  wire [0:0]s00_couplers_to_axi_mem_intercon_AWLOCK;
  wire [2:0]s00_couplers_to_axi_mem_intercon_AWPROT;
  wire [3:0]s00_couplers_to_axi_mem_intercon_AWQOS;
  wire s00_couplers_to_axi_mem_intercon_AWREADY;
  wire [2:0]s00_couplers_to_axi_mem_intercon_AWSIZE;
  wire s00_couplers_to_axi_mem_intercon_AWVALID;
  wire s00_couplers_to_axi_mem_intercon_BREADY;
  wire [1:0]s00_couplers_to_axi_mem_intercon_BRESP;
  wire s00_couplers_to_axi_mem_intercon_BVALID;
  wire [63:0]s00_couplers_to_axi_mem_intercon_RDATA;
  wire s00_couplers_to_axi_mem_intercon_RLAST;
  wire s00_couplers_to_axi_mem_intercon_RREADY;
  wire [1:0]s00_couplers_to_axi_mem_intercon_RRESP;
  wire s00_couplers_to_axi_mem_intercon_RVALID;
  wire [63:0]s00_couplers_to_axi_mem_intercon_WDATA;
  wire s00_couplers_to_axi_mem_intercon_WLAST;
  wire s00_couplers_to_axi_mem_intercon_WREADY;
  wire [7:0]s00_couplers_to_axi_mem_intercon_WSTRB;
  wire s00_couplers_to_axi_mem_intercon_WVALID;

  assign M00_AXI_araddr[31:0] = s00_couplers_to_axi_mem_intercon_ARADDR;
  assign M00_AXI_arburst[1:0] = s00_couplers_to_axi_mem_intercon_ARBURST;
  assign M00_AXI_arcache[3:0] = s00_couplers_to_axi_mem_intercon_ARCACHE;
  assign M00_AXI_arlen[7:0] = s00_couplers_to_axi_mem_intercon_ARLEN;
  assign M00_AXI_arlock[0] = s00_couplers_to_axi_mem_intercon_ARLOCK;
  assign M00_AXI_arprot[2:0] = s00_couplers_to_axi_mem_intercon_ARPROT;
  assign M00_AXI_arqos[3:0] = s00_couplers_to_axi_mem_intercon_ARQOS;
  assign M00_AXI_arsize[2:0] = s00_couplers_to_axi_mem_intercon_ARSIZE;
  assign M00_AXI_arvalid = s00_couplers_to_axi_mem_intercon_ARVALID;
  assign M00_AXI_awaddr[31:0] = s00_couplers_to_axi_mem_intercon_AWADDR;
  assign M00_AXI_awburst[1:0] = s00_couplers_to_axi_mem_intercon_AWBURST;
  assign M00_AXI_awcache[3:0] = s00_couplers_to_axi_mem_intercon_AWCACHE;
  assign M00_AXI_awlen[7:0] = s00_couplers_to_axi_mem_intercon_AWLEN;
  assign M00_AXI_awlock[0] = s00_couplers_to_axi_mem_intercon_AWLOCK;
  assign M00_AXI_awprot[2:0] = s00_couplers_to_axi_mem_intercon_AWPROT;
  assign M00_AXI_awqos[3:0] = s00_couplers_to_axi_mem_intercon_AWQOS;
  assign M00_AXI_awsize[2:0] = s00_couplers_to_axi_mem_intercon_AWSIZE;
  assign M00_AXI_awvalid = s00_couplers_to_axi_mem_intercon_AWVALID;
  assign M00_AXI_bready = s00_couplers_to_axi_mem_intercon_BREADY;
  assign M00_AXI_rready = s00_couplers_to_axi_mem_intercon_RREADY;
  assign M00_AXI_wdata[63:0] = s00_couplers_to_axi_mem_intercon_WDATA;
  assign M00_AXI_wlast = s00_couplers_to_axi_mem_intercon_WLAST;
  assign M00_AXI_wstrb[7:0] = s00_couplers_to_axi_mem_intercon_WSTRB;
  assign M00_AXI_wvalid = s00_couplers_to_axi_mem_intercon_WVALID;
  assign S00_ACLK_1 = S00_ACLK;
  assign S00_ARESETN_1 = S00_ARESETN;
  assign S00_AXI_awready = axi_mem_intercon_to_s00_couplers_AWREADY;
  assign S00_AXI_bresp[1:0] = axi_mem_intercon_to_s00_couplers_BRESP;
  assign S00_AXI_bvalid = axi_mem_intercon_to_s00_couplers_BVALID;
  assign S00_AXI_wready = axi_mem_intercon_to_s00_couplers_WREADY;
  assign axi_mem_intercon_ACLK_net = M00_ACLK;
  assign axi_mem_intercon_ARESETN_net = M00_ARESETN;
  assign axi_mem_intercon_to_s00_couplers_AWADDR = S00_AXI_awaddr[31:0];
  assign axi_mem_intercon_to_s00_couplers_AWBURST = S00_AXI_awburst[1:0];
  assign axi_mem_intercon_to_s00_couplers_AWCACHE = S00_AXI_awcache[3:0];
  assign axi_mem_intercon_to_s00_couplers_AWLEN = S00_AXI_awlen[7:0];
  assign axi_mem_intercon_to_s00_couplers_AWPROT = S00_AXI_awprot[2:0];
  assign axi_mem_intercon_to_s00_couplers_AWSIZE = S00_AXI_awsize[2:0];
  assign axi_mem_intercon_to_s00_couplers_AWVALID = S00_AXI_awvalid;
  assign axi_mem_intercon_to_s00_couplers_BREADY = S00_AXI_bready;
  assign axi_mem_intercon_to_s00_couplers_WDATA = S00_AXI_wdata[31:0];
  assign axi_mem_intercon_to_s00_couplers_WLAST = S00_AXI_wlast;
  assign axi_mem_intercon_to_s00_couplers_WSTRB = S00_AXI_wstrb[3:0];
  assign axi_mem_intercon_to_s00_couplers_WVALID = S00_AXI_wvalid;
  assign s00_couplers_to_axi_mem_intercon_ARREADY = M00_AXI_arready;
  assign s00_couplers_to_axi_mem_intercon_AWREADY = M00_AXI_awready;
  assign s00_couplers_to_axi_mem_intercon_BRESP = M00_AXI_bresp[1:0];
  assign s00_couplers_to_axi_mem_intercon_BVALID = M00_AXI_bvalid;
  assign s00_couplers_to_axi_mem_intercon_RDATA = M00_AXI_rdata[63:0];
  assign s00_couplers_to_axi_mem_intercon_RLAST = M00_AXI_rlast;
  assign s00_couplers_to_axi_mem_intercon_RRESP = M00_AXI_rresp[1:0];
  assign s00_couplers_to_axi_mem_intercon_RVALID = M00_AXI_rvalid;
  assign s00_couplers_to_axi_mem_intercon_WREADY = M00_AXI_wready;
  s00_couplers_imp_1P403ZT s00_couplers
       (.M_ACLK(axi_mem_intercon_ACLK_net),
        .M_ARESETN(axi_mem_intercon_ARESETN_net),
        .M_AXI_araddr(s00_couplers_to_axi_mem_intercon_ARADDR),
        .M_AXI_arburst(s00_couplers_to_axi_mem_intercon_ARBURST),
        .M_AXI_arcache(s00_couplers_to_axi_mem_intercon_ARCACHE),
        .M_AXI_arlen(s00_couplers_to_axi_mem_intercon_ARLEN),
        .M_AXI_arlock(s00_couplers_to_axi_mem_intercon_ARLOCK),
        .M_AXI_arprot(s00_couplers_to_axi_mem_intercon_ARPROT),
        .M_AXI_arqos(s00_couplers_to_axi_mem_intercon_ARQOS),
        .M_AXI_arready(s00_couplers_to_axi_mem_intercon_ARREADY),
        .M_AXI_arsize(s00_couplers_to_axi_mem_intercon_ARSIZE),
        .M_AXI_arvalid(s00_couplers_to_axi_mem_intercon_ARVALID),
        .M_AXI_awaddr(s00_couplers_to_axi_mem_intercon_AWADDR),
        .M_AXI_awburst(s00_couplers_to_axi_mem_intercon_AWBURST),
        .M_AXI_awcache(s00_couplers_to_axi_mem_intercon_AWCACHE),
        .M_AXI_awlen(s00_couplers_to_axi_mem_intercon_AWLEN),
        .M_AXI_awlock(s00_couplers_to_axi_mem_intercon_AWLOCK),
        .M_AXI_awprot(s00_couplers_to_axi_mem_intercon_AWPROT),
        .M_AXI_awqos(s00_couplers_to_axi_mem_intercon_AWQOS),
        .M_AXI_awready(s00_couplers_to_axi_mem_intercon_AWREADY),
        .M_AXI_awsize(s00_couplers_to_axi_mem_intercon_AWSIZE),
        .M_AXI_awvalid(s00_couplers_to_axi_mem_intercon_AWVALID),
        .M_AXI_bready(s00_couplers_to_axi_mem_intercon_BREADY),
        .M_AXI_bresp(s00_couplers_to_axi_mem_intercon_BRESP),
        .M_AXI_bvalid(s00_couplers_to_axi_mem_intercon_BVALID),
        .M_AXI_rdata(s00_couplers_to_axi_mem_intercon_RDATA),
        .M_AXI_rlast(s00_couplers_to_axi_mem_intercon_RLAST),
        .M_AXI_rready(s00_couplers_to_axi_mem_intercon_RREADY),
        .M_AXI_rresp(s00_couplers_to_axi_mem_intercon_RRESP),
        .M_AXI_rvalid(s00_couplers_to_axi_mem_intercon_RVALID),
        .M_AXI_wdata(s00_couplers_to_axi_mem_intercon_WDATA),
        .M_AXI_wlast(s00_couplers_to_axi_mem_intercon_WLAST),
        .M_AXI_wready(s00_couplers_to_axi_mem_intercon_WREADY),
        .M_AXI_wstrb(s00_couplers_to_axi_mem_intercon_WSTRB),
        .M_AXI_wvalid(s00_couplers_to_axi_mem_intercon_WVALID),
        .S_ACLK(S00_ACLK_1),
        .S_ARESETN(S00_ARESETN_1),
        .S_AXI_awaddr(axi_mem_intercon_to_s00_couplers_AWADDR),
        .S_AXI_awburst(axi_mem_intercon_to_s00_couplers_AWBURST),
        .S_AXI_awcache(axi_mem_intercon_to_s00_couplers_AWCACHE),
        .S_AXI_awlen(axi_mem_intercon_to_s00_couplers_AWLEN),
        .S_AXI_awprot(axi_mem_intercon_to_s00_couplers_AWPROT),
        .S_AXI_awready(axi_mem_intercon_to_s00_couplers_AWREADY),
        .S_AXI_awsize(axi_mem_intercon_to_s00_couplers_AWSIZE),
        .S_AXI_awvalid(axi_mem_intercon_to_s00_couplers_AWVALID),
        .S_AXI_bready(axi_mem_intercon_to_s00_couplers_BREADY),
        .S_AXI_bresp(axi_mem_intercon_to_s00_couplers_BRESP),
        .S_AXI_bvalid(axi_mem_intercon_to_s00_couplers_BVALID),
        .S_AXI_wdata(axi_mem_intercon_to_s00_couplers_WDATA),
        .S_AXI_wlast(axi_mem_intercon_to_s00_couplers_WLAST),
        .S_AXI_wready(axi_mem_intercon_to_s00_couplers_WREADY),
        .S_AXI_wstrb(axi_mem_intercon_to_s00_couplers_WSTRB),
        .S_AXI_wvalid(axi_mem_intercon_to_s00_couplers_WVALID));
endmodule

module system_ps7_0_axi_periph_2
   (ACLK,
    ARESETN,
    M00_ACLK,
    M00_ARESETN,
    M00_AXI_araddr,
    M00_AXI_arready,
    M00_AXI_arvalid,
    M00_AXI_awaddr,
    M00_AXI_awready,
    M00_AXI_awvalid,
    M00_AXI_bready,
    M00_AXI_bresp,
    M00_AXI_bvalid,
    M00_AXI_rdata,
    M00_AXI_rready,
    M00_AXI_rresp,
    M00_AXI_rvalid,
    M00_AXI_wdata,
    M00_AXI_wready,
    M00_AXI_wvalid,
    M01_ACLK,
    M01_ARESETN,
    M01_AXI_araddr,
    M01_AXI_arready,
    M01_AXI_arvalid,
    M01_AXI_awaddr,
    M01_AXI_awready,
    M01_AXI_awvalid,
    M01_AXI_bready,
    M01_AXI_bresp,
    M01_AXI_bvalid,
    M01_AXI_rdata,
    M01_AXI_rready,
    M01_AXI_rresp,
    M01_AXI_rvalid,
    M01_AXI_wdata,
    M01_AXI_wready,
    M01_AXI_wstrb,
    M01_AXI_wvalid,
    M02_ACLK,
    M02_ARESETN,
    M02_AXI_araddr,
    M02_AXI_arprot,
    M02_AXI_arready,
    M02_AXI_arvalid,
    M02_AXI_awaddr,
    M02_AXI_awprot,
    M02_AXI_awready,
    M02_AXI_awvalid,
    M02_AXI_bready,
    M02_AXI_bresp,
    M02_AXI_bvalid,
    M02_AXI_rdata,
    M02_AXI_rready,
    M02_AXI_rresp,
    M02_AXI_rvalid,
    M02_AXI_wdata,
    M02_AXI_wready,
    M02_AXI_wstrb,
    M02_AXI_wvalid,
    S00_ACLK,
    S00_ARESETN,
    S00_AXI_araddr,
    S00_AXI_arburst,
    S00_AXI_arcache,
    S00_AXI_arlen,
    S00_AXI_arlock,
    S00_AXI_arprot,
    S00_AXI_arqos,
    S00_AXI_arready,
    S00_AXI_arsize,
    S00_AXI_arvalid,
    S00_AXI_awaddr,
    S00_AXI_awburst,
    S00_AXI_awcache,
    S00_AXI_awlen,
    S00_AXI_awlock,
    S00_AXI_awprot,
    S00_AXI_awqos,
    S00_AXI_awready,
    S00_AXI_awsize,
    S00_AXI_awvalid,
    S00_AXI_bready,
    S00_AXI_bresp,
    S00_AXI_bvalid,
    S00_AXI_rdata,
    S00_AXI_rlast,
    S00_AXI_rready,
    S00_AXI_rresp,
    S00_AXI_rvalid,
    S00_AXI_wdata,
    S00_AXI_wlast,
    S00_AXI_wready,
    S00_AXI_wstrb,
    S00_AXI_wvalid);
  input ACLK;
  input ARESETN;
  input M00_ACLK;
  input M00_ARESETN;
  output [31:0]M00_AXI_araddr;
  input [0:0]M00_AXI_arready;
  output [0:0]M00_AXI_arvalid;
  output [31:0]M00_AXI_awaddr;
  input [0:0]M00_AXI_awready;
  output [0:0]M00_AXI_awvalid;
  output [0:0]M00_AXI_bready;
  input [1:0]M00_AXI_bresp;
  input [0:0]M00_AXI_bvalid;
  input [31:0]M00_AXI_rdata;
  output [0:0]M00_AXI_rready;
  input [1:0]M00_AXI_rresp;
  input [0:0]M00_AXI_rvalid;
  output [31:0]M00_AXI_wdata;
  input [0:0]M00_AXI_wready;
  output [0:0]M00_AXI_wvalid;
  input M01_ACLK;
  input M01_ARESETN;
  output [31:0]M01_AXI_araddr;
  input [0:0]M01_AXI_arready;
  output [0:0]M01_AXI_arvalid;
  output [31:0]M01_AXI_awaddr;
  input [0:0]M01_AXI_awready;
  output [0:0]M01_AXI_awvalid;
  output [0:0]M01_AXI_bready;
  input [1:0]M01_AXI_bresp;
  input [0:0]M01_AXI_bvalid;
  input [31:0]M01_AXI_rdata;
  output [0:0]M01_AXI_rready;
  input [1:0]M01_AXI_rresp;
  input [0:0]M01_AXI_rvalid;
  output [31:0]M01_AXI_wdata;
  input [0:0]M01_AXI_wready;
  output [3:0]M01_AXI_wstrb;
  output [0:0]M01_AXI_wvalid;
  input M02_ACLK;
  input M02_ARESETN;
  output [31:0]M02_AXI_araddr;
  output [2:0]M02_AXI_arprot;
  input M02_AXI_arready;
  output M02_AXI_arvalid;
  output [31:0]M02_AXI_awaddr;
  output [2:0]M02_AXI_awprot;
  input M02_AXI_awready;
  output M02_AXI_awvalid;
  output M02_AXI_bready;
  input [1:0]M02_AXI_bresp;
  input M02_AXI_bvalid;
  input [31:0]M02_AXI_rdata;
  output M02_AXI_rready;
  input [1:0]M02_AXI_rresp;
  input M02_AXI_rvalid;
  output [31:0]M02_AXI_wdata;
  input M02_AXI_wready;
  output [3:0]M02_AXI_wstrb;
  output M02_AXI_wvalid;
  input S00_ACLK;
  input S00_ARESETN;
  input [31:0]S00_AXI_araddr;
  input [1:0]S00_AXI_arburst;
  input [3:0]S00_AXI_arcache;
  input [3:0]S00_AXI_arlen;
  input [1:0]S00_AXI_arlock;
  input [2:0]S00_AXI_arprot;
  input [3:0]S00_AXI_arqos;
  output S00_AXI_arready;
  input [2:0]S00_AXI_arsize;
  input S00_AXI_arvalid;
  input [31:0]S00_AXI_awaddr;
  input [1:0]S00_AXI_awburst;
  input [3:0]S00_AXI_awcache;
  input [3:0]S00_AXI_awlen;
  input [1:0]S00_AXI_awlock;
  input [2:0]S00_AXI_awprot;
  input [3:0]S00_AXI_awqos;
  output S00_AXI_awready;
  input [2:0]S00_AXI_awsize;
  input S00_AXI_awvalid;
  input S00_AXI_bready;
  output [1:0]S00_AXI_bresp;
  output S00_AXI_bvalid;
  output [31:0]S00_AXI_rdata;
  output S00_AXI_rlast;
  input S00_AXI_rready;
  output [1:0]S00_AXI_rresp;
  output S00_AXI_rvalid;
  input [31:0]S00_AXI_wdata;
  input S00_AXI_wlast;
  output S00_AXI_wready;
  input [3:0]S00_AXI_wstrb;
  input S00_AXI_wvalid;

  wire [31:0]m00_couplers_to_ps7_0_axi_periph_ARADDR;
  wire [0:0]m00_couplers_to_ps7_0_axi_periph_ARREADY;
  wire [0:0]m00_couplers_to_ps7_0_axi_periph_ARVALID;
  wire [31:0]m00_couplers_to_ps7_0_axi_periph_AWADDR;
  wire [0:0]m00_couplers_to_ps7_0_axi_periph_AWREADY;
  wire [0:0]m00_couplers_to_ps7_0_axi_periph_AWVALID;
  wire [0:0]m00_couplers_to_ps7_0_axi_periph_BREADY;
  wire [1:0]m00_couplers_to_ps7_0_axi_periph_BRESP;
  wire [0:0]m00_couplers_to_ps7_0_axi_periph_BVALID;
  wire [31:0]m00_couplers_to_ps7_0_axi_periph_RDATA;
  wire [0:0]m00_couplers_to_ps7_0_axi_periph_RREADY;
  wire [1:0]m00_couplers_to_ps7_0_axi_periph_RRESP;
  wire [0:0]m00_couplers_to_ps7_0_axi_periph_RVALID;
  wire [31:0]m00_couplers_to_ps7_0_axi_periph_WDATA;
  wire [0:0]m00_couplers_to_ps7_0_axi_periph_WREADY;
  wire [0:0]m00_couplers_to_ps7_0_axi_periph_WVALID;
  wire [31:0]m01_couplers_to_ps7_0_axi_periph_ARADDR;
  wire [0:0]m01_couplers_to_ps7_0_axi_periph_ARREADY;
  wire [0:0]m01_couplers_to_ps7_0_axi_periph_ARVALID;
  wire [31:0]m01_couplers_to_ps7_0_axi_periph_AWADDR;
  wire [0:0]m01_couplers_to_ps7_0_axi_periph_AWREADY;
  wire [0:0]m01_couplers_to_ps7_0_axi_periph_AWVALID;
  wire [0:0]m01_couplers_to_ps7_0_axi_periph_BREADY;
  wire [1:0]m01_couplers_to_ps7_0_axi_periph_BRESP;
  wire [0:0]m01_couplers_to_ps7_0_axi_periph_BVALID;
  wire [31:0]m01_couplers_to_ps7_0_axi_periph_RDATA;
  wire [0:0]m01_couplers_to_ps7_0_axi_periph_RREADY;
  wire [1:0]m01_couplers_to_ps7_0_axi_periph_RRESP;
  wire [0:0]m01_couplers_to_ps7_0_axi_periph_RVALID;
  wire [31:0]m01_couplers_to_ps7_0_axi_periph_WDATA;
  wire [0:0]m01_couplers_to_ps7_0_axi_periph_WREADY;
  wire [3:0]m01_couplers_to_ps7_0_axi_periph_WSTRB;
  wire [0:0]m01_couplers_to_ps7_0_axi_periph_WVALID;
  wire [31:0]m02_couplers_to_ps7_0_axi_periph_ARADDR;
  wire [2:0]m02_couplers_to_ps7_0_axi_periph_ARPROT;
  wire m02_couplers_to_ps7_0_axi_periph_ARREADY;
  wire m02_couplers_to_ps7_0_axi_periph_ARVALID;
  wire [31:0]m02_couplers_to_ps7_0_axi_periph_AWADDR;
  wire [2:0]m02_couplers_to_ps7_0_axi_periph_AWPROT;
  wire m02_couplers_to_ps7_0_axi_periph_AWREADY;
  wire m02_couplers_to_ps7_0_axi_periph_AWVALID;
  wire m02_couplers_to_ps7_0_axi_periph_BREADY;
  wire [1:0]m02_couplers_to_ps7_0_axi_periph_BRESP;
  wire m02_couplers_to_ps7_0_axi_periph_BVALID;
  wire [31:0]m02_couplers_to_ps7_0_axi_periph_RDATA;
  wire m02_couplers_to_ps7_0_axi_periph_RREADY;
  wire [1:0]m02_couplers_to_ps7_0_axi_periph_RRESP;
  wire m02_couplers_to_ps7_0_axi_periph_RVALID;
  wire [31:0]m02_couplers_to_ps7_0_axi_periph_WDATA;
  wire m02_couplers_to_ps7_0_axi_periph_WREADY;
  wire [3:0]m02_couplers_to_ps7_0_axi_periph_WSTRB;
  wire m02_couplers_to_ps7_0_axi_periph_WVALID;
  wire ps7_0_axi_periph_ACLK_net;
  wire ps7_0_axi_periph_ARESETN_net;
  wire [31:0]ps7_0_axi_periph_to_s00_couplers_ARADDR;
  wire [1:0]ps7_0_axi_periph_to_s00_couplers_ARBURST;
  wire [3:0]ps7_0_axi_periph_to_s00_couplers_ARCACHE;
  wire [3:0]ps7_0_axi_periph_to_s00_couplers_ARLEN;
  wire [1:0]ps7_0_axi_periph_to_s00_couplers_ARLOCK;
  wire [2:0]ps7_0_axi_periph_to_s00_couplers_ARPROT;
  wire [3:0]ps7_0_axi_periph_to_s00_couplers_ARQOS;
  wire ps7_0_axi_periph_to_s00_couplers_ARREADY;
  wire [2:0]ps7_0_axi_periph_to_s00_couplers_ARSIZE;
  wire ps7_0_axi_periph_to_s00_couplers_ARVALID;
  wire [31:0]ps7_0_axi_periph_to_s00_couplers_AWADDR;
  wire [1:0]ps7_0_axi_periph_to_s00_couplers_AWBURST;
  wire [3:0]ps7_0_axi_periph_to_s00_couplers_AWCACHE;
  wire [3:0]ps7_0_axi_periph_to_s00_couplers_AWLEN;
  wire [1:0]ps7_0_axi_periph_to_s00_couplers_AWLOCK;
  wire [2:0]ps7_0_axi_periph_to_s00_couplers_AWPROT;
  wire [3:0]ps7_0_axi_periph_to_s00_couplers_AWQOS;
  wire ps7_0_axi_periph_to_s00_couplers_AWREADY;
  wire [2:0]ps7_0_axi_periph_to_s00_couplers_AWSIZE;
  wire ps7_0_axi_periph_to_s00_couplers_AWVALID;
  wire ps7_0_axi_periph_to_s00_couplers_BREADY;
  wire [1:0]ps7_0_axi_periph_to_s00_couplers_BRESP;
  wire ps7_0_axi_periph_to_s00_couplers_BVALID;
  wire [31:0]ps7_0_axi_periph_to_s00_couplers_RDATA;
  wire ps7_0_axi_periph_to_s00_couplers_RLAST;
  wire ps7_0_axi_periph_to_s00_couplers_RREADY;
  wire [1:0]ps7_0_axi_periph_to_s00_couplers_RRESP;
  wire ps7_0_axi_periph_to_s00_couplers_RVALID;
  wire [31:0]ps7_0_axi_periph_to_s00_couplers_WDATA;
  wire ps7_0_axi_periph_to_s00_couplers_WLAST;
  wire ps7_0_axi_periph_to_s00_couplers_WREADY;
  wire [3:0]ps7_0_axi_periph_to_s00_couplers_WSTRB;
  wire ps7_0_axi_periph_to_s00_couplers_WVALID;
  wire [31:0]s00_couplers_to_xbar_ARADDR;
  wire [2:0]s00_couplers_to_xbar_ARPROT;
  wire [0:0]s00_couplers_to_xbar_ARREADY;
  wire s00_couplers_to_xbar_ARVALID;
  wire [31:0]s00_couplers_to_xbar_AWADDR;
  wire [2:0]s00_couplers_to_xbar_AWPROT;
  wire [0:0]s00_couplers_to_xbar_AWREADY;
  wire s00_couplers_to_xbar_AWVALID;
  wire s00_couplers_to_xbar_BREADY;
  wire [1:0]s00_couplers_to_xbar_BRESP;
  wire [0:0]s00_couplers_to_xbar_BVALID;
  wire [31:0]s00_couplers_to_xbar_RDATA;
  wire s00_couplers_to_xbar_RREADY;
  wire [1:0]s00_couplers_to_xbar_RRESP;
  wire [0:0]s00_couplers_to_xbar_RVALID;
  wire [31:0]s00_couplers_to_xbar_WDATA;
  wire [0:0]s00_couplers_to_xbar_WREADY;
  wire [3:0]s00_couplers_to_xbar_WSTRB;
  wire s00_couplers_to_xbar_WVALID;
  wire [31:0]xbar_to_m00_couplers_ARADDR;
  wire [0:0]xbar_to_m00_couplers_ARREADY;
  wire [0:0]xbar_to_m00_couplers_ARVALID;
  wire [31:0]xbar_to_m00_couplers_AWADDR;
  wire [0:0]xbar_to_m00_couplers_AWREADY;
  wire [0:0]xbar_to_m00_couplers_AWVALID;
  wire [0:0]xbar_to_m00_couplers_BREADY;
  wire [1:0]xbar_to_m00_couplers_BRESP;
  wire [0:0]xbar_to_m00_couplers_BVALID;
  wire [31:0]xbar_to_m00_couplers_RDATA;
  wire [0:0]xbar_to_m00_couplers_RREADY;
  wire [1:0]xbar_to_m00_couplers_RRESP;
  wire [0:0]xbar_to_m00_couplers_RVALID;
  wire [31:0]xbar_to_m00_couplers_WDATA;
  wire [0:0]xbar_to_m00_couplers_WREADY;
  wire [0:0]xbar_to_m00_couplers_WVALID;
  wire [63:32]xbar_to_m01_couplers_ARADDR;
  wire [0:0]xbar_to_m01_couplers_ARREADY;
  wire [1:1]xbar_to_m01_couplers_ARVALID;
  wire [63:32]xbar_to_m01_couplers_AWADDR;
  wire [0:0]xbar_to_m01_couplers_AWREADY;
  wire [1:1]xbar_to_m01_couplers_AWVALID;
  wire [1:1]xbar_to_m01_couplers_BREADY;
  wire [1:0]xbar_to_m01_couplers_BRESP;
  wire [0:0]xbar_to_m01_couplers_BVALID;
  wire [31:0]xbar_to_m01_couplers_RDATA;
  wire [1:1]xbar_to_m01_couplers_RREADY;
  wire [1:0]xbar_to_m01_couplers_RRESP;
  wire [0:0]xbar_to_m01_couplers_RVALID;
  wire [63:32]xbar_to_m01_couplers_WDATA;
  wire [0:0]xbar_to_m01_couplers_WREADY;
  wire [7:4]xbar_to_m01_couplers_WSTRB;
  wire [1:1]xbar_to_m01_couplers_WVALID;
  wire [95:64]xbar_to_m02_couplers_ARADDR;
  wire [8:6]xbar_to_m02_couplers_ARPROT;
  wire xbar_to_m02_couplers_ARREADY;
  wire [2:2]xbar_to_m02_couplers_ARVALID;
  wire [95:64]xbar_to_m02_couplers_AWADDR;
  wire [8:6]xbar_to_m02_couplers_AWPROT;
  wire xbar_to_m02_couplers_AWREADY;
  wire [2:2]xbar_to_m02_couplers_AWVALID;
  wire [2:2]xbar_to_m02_couplers_BREADY;
  wire [1:0]xbar_to_m02_couplers_BRESP;
  wire xbar_to_m02_couplers_BVALID;
  wire [31:0]xbar_to_m02_couplers_RDATA;
  wire [2:2]xbar_to_m02_couplers_RREADY;
  wire [1:0]xbar_to_m02_couplers_RRESP;
  wire xbar_to_m02_couplers_RVALID;
  wire [95:64]xbar_to_m02_couplers_WDATA;
  wire xbar_to_m02_couplers_WREADY;
  wire [11:8]xbar_to_m02_couplers_WSTRB;
  wire [2:2]xbar_to_m02_couplers_WVALID;
  wire [8:0]NLW_xbar_m_axi_arprot_UNCONNECTED;
  wire [8:0]NLW_xbar_m_axi_awprot_UNCONNECTED;
  wire [11:0]NLW_xbar_m_axi_wstrb_UNCONNECTED;

  assign M00_AXI_araddr[31:0] = m00_couplers_to_ps7_0_axi_periph_ARADDR;
  assign M00_AXI_arvalid[0] = m00_couplers_to_ps7_0_axi_periph_ARVALID;
  assign M00_AXI_awaddr[31:0] = m00_couplers_to_ps7_0_axi_periph_AWADDR;
  assign M00_AXI_awvalid[0] = m00_couplers_to_ps7_0_axi_periph_AWVALID;
  assign M00_AXI_bready[0] = m00_couplers_to_ps7_0_axi_periph_BREADY;
  assign M00_AXI_rready[0] = m00_couplers_to_ps7_0_axi_periph_RREADY;
  assign M00_AXI_wdata[31:0] = m00_couplers_to_ps7_0_axi_periph_WDATA;
  assign M00_AXI_wvalid[0] = m00_couplers_to_ps7_0_axi_periph_WVALID;
  assign M01_AXI_araddr[31:0] = m01_couplers_to_ps7_0_axi_periph_ARADDR;
  assign M01_AXI_arvalid[0] = m01_couplers_to_ps7_0_axi_periph_ARVALID;
  assign M01_AXI_awaddr[31:0] = m01_couplers_to_ps7_0_axi_periph_AWADDR;
  assign M01_AXI_awvalid[0] = m01_couplers_to_ps7_0_axi_periph_AWVALID;
  assign M01_AXI_bready[0] = m01_couplers_to_ps7_0_axi_periph_BREADY;
  assign M01_AXI_rready[0] = m01_couplers_to_ps7_0_axi_periph_RREADY;
  assign M01_AXI_wdata[31:0] = m01_couplers_to_ps7_0_axi_periph_WDATA;
  assign M01_AXI_wstrb[3:0] = m01_couplers_to_ps7_0_axi_periph_WSTRB;
  assign M01_AXI_wvalid[0] = m01_couplers_to_ps7_0_axi_periph_WVALID;
  assign M02_AXI_araddr[31:0] = m02_couplers_to_ps7_0_axi_periph_ARADDR;
  assign M02_AXI_arprot[2:0] = m02_couplers_to_ps7_0_axi_periph_ARPROT;
  assign M02_AXI_arvalid = m02_couplers_to_ps7_0_axi_periph_ARVALID;
  assign M02_AXI_awaddr[31:0] = m02_couplers_to_ps7_0_axi_periph_AWADDR;
  assign M02_AXI_awprot[2:0] = m02_couplers_to_ps7_0_axi_periph_AWPROT;
  assign M02_AXI_awvalid = m02_couplers_to_ps7_0_axi_periph_AWVALID;
  assign M02_AXI_bready = m02_couplers_to_ps7_0_axi_periph_BREADY;
  assign M02_AXI_rready = m02_couplers_to_ps7_0_axi_periph_RREADY;
  assign M02_AXI_wdata[31:0] = m02_couplers_to_ps7_0_axi_periph_WDATA;
  assign M02_AXI_wstrb[3:0] = m02_couplers_to_ps7_0_axi_periph_WSTRB;
  assign M02_AXI_wvalid = m02_couplers_to_ps7_0_axi_periph_WVALID;
  assign S00_AXI_arready = ps7_0_axi_periph_to_s00_couplers_ARREADY;
  assign S00_AXI_awready = ps7_0_axi_periph_to_s00_couplers_AWREADY;
  assign S00_AXI_bresp[1:0] = ps7_0_axi_periph_to_s00_couplers_BRESP;
  assign S00_AXI_bvalid = ps7_0_axi_periph_to_s00_couplers_BVALID;
  assign S00_AXI_rdata[31:0] = ps7_0_axi_periph_to_s00_couplers_RDATA;
  assign S00_AXI_rlast = ps7_0_axi_periph_to_s00_couplers_RLAST;
  assign S00_AXI_rresp[1:0] = ps7_0_axi_periph_to_s00_couplers_RRESP;
  assign S00_AXI_rvalid = ps7_0_axi_periph_to_s00_couplers_RVALID;
  assign S00_AXI_wready = ps7_0_axi_periph_to_s00_couplers_WREADY;
  assign m00_couplers_to_ps7_0_axi_periph_ARREADY = M00_AXI_arready[0];
  assign m00_couplers_to_ps7_0_axi_periph_AWREADY = M00_AXI_awready[0];
  assign m00_couplers_to_ps7_0_axi_periph_BRESP = M00_AXI_bresp[1:0];
  assign m00_couplers_to_ps7_0_axi_periph_BVALID = M00_AXI_bvalid[0];
  assign m00_couplers_to_ps7_0_axi_periph_RDATA = M00_AXI_rdata[31:0];
  assign m00_couplers_to_ps7_0_axi_periph_RRESP = M00_AXI_rresp[1:0];
  assign m00_couplers_to_ps7_0_axi_periph_RVALID = M00_AXI_rvalid[0];
  assign m00_couplers_to_ps7_0_axi_periph_WREADY = M00_AXI_wready[0];
  assign m01_couplers_to_ps7_0_axi_periph_ARREADY = M01_AXI_arready[0];
  assign m01_couplers_to_ps7_0_axi_periph_AWREADY = M01_AXI_awready[0];
  assign m01_couplers_to_ps7_0_axi_periph_BRESP = M01_AXI_bresp[1:0];
  assign m01_couplers_to_ps7_0_axi_periph_BVALID = M01_AXI_bvalid[0];
  assign m01_couplers_to_ps7_0_axi_periph_RDATA = M01_AXI_rdata[31:0];
  assign m01_couplers_to_ps7_0_axi_periph_RRESP = M01_AXI_rresp[1:0];
  assign m01_couplers_to_ps7_0_axi_periph_RVALID = M01_AXI_rvalid[0];
  assign m01_couplers_to_ps7_0_axi_periph_WREADY = M01_AXI_wready[0];
  assign m02_couplers_to_ps7_0_axi_periph_ARREADY = M02_AXI_arready;
  assign m02_couplers_to_ps7_0_axi_periph_AWREADY = M02_AXI_awready;
  assign m02_couplers_to_ps7_0_axi_periph_BRESP = M02_AXI_bresp[1:0];
  assign m02_couplers_to_ps7_0_axi_periph_BVALID = M02_AXI_bvalid;
  assign m02_couplers_to_ps7_0_axi_periph_RDATA = M02_AXI_rdata[31:0];
  assign m02_couplers_to_ps7_0_axi_periph_RRESP = M02_AXI_rresp[1:0];
  assign m02_couplers_to_ps7_0_axi_periph_RVALID = M02_AXI_rvalid;
  assign m02_couplers_to_ps7_0_axi_periph_WREADY = M02_AXI_wready;
  assign ps7_0_axi_periph_ACLK_net = ACLK;
  assign ps7_0_axi_periph_ARESETN_net = ARESETN;
  assign ps7_0_axi_periph_to_s00_couplers_ARADDR = S00_AXI_araddr[31:0];
  assign ps7_0_axi_periph_to_s00_couplers_ARBURST = S00_AXI_arburst[1:0];
  assign ps7_0_axi_periph_to_s00_couplers_ARCACHE = S00_AXI_arcache[3:0];
  assign ps7_0_axi_periph_to_s00_couplers_ARLEN = S00_AXI_arlen[3:0];
  assign ps7_0_axi_periph_to_s00_couplers_ARLOCK = S00_AXI_arlock[1:0];
  assign ps7_0_axi_periph_to_s00_couplers_ARPROT = S00_AXI_arprot[2:0];
  assign ps7_0_axi_periph_to_s00_couplers_ARQOS = S00_AXI_arqos[3:0];
  assign ps7_0_axi_periph_to_s00_couplers_ARSIZE = S00_AXI_arsize[2:0];
  assign ps7_0_axi_periph_to_s00_couplers_ARVALID = S00_AXI_arvalid;
  assign ps7_0_axi_periph_to_s00_couplers_AWADDR = S00_AXI_awaddr[31:0];
  assign ps7_0_axi_periph_to_s00_couplers_AWBURST = S00_AXI_awburst[1:0];
  assign ps7_0_axi_periph_to_s00_couplers_AWCACHE = S00_AXI_awcache[3:0];
  assign ps7_0_axi_periph_to_s00_couplers_AWLEN = S00_AXI_awlen[3:0];
  assign ps7_0_axi_periph_to_s00_couplers_AWLOCK = S00_AXI_awlock[1:0];
  assign ps7_0_axi_periph_to_s00_couplers_AWPROT = S00_AXI_awprot[2:0];
  assign ps7_0_axi_periph_to_s00_couplers_AWQOS = S00_AXI_awqos[3:0];
  assign ps7_0_axi_periph_to_s00_couplers_AWSIZE = S00_AXI_awsize[2:0];
  assign ps7_0_axi_periph_to_s00_couplers_AWVALID = S00_AXI_awvalid;
  assign ps7_0_axi_periph_to_s00_couplers_BREADY = S00_AXI_bready;
  assign ps7_0_axi_periph_to_s00_couplers_RREADY = S00_AXI_rready;
  assign ps7_0_axi_periph_to_s00_couplers_WDATA = S00_AXI_wdata[31:0];
  assign ps7_0_axi_periph_to_s00_couplers_WLAST = S00_AXI_wlast;
  assign ps7_0_axi_periph_to_s00_couplers_WSTRB = S00_AXI_wstrb[3:0];
  assign ps7_0_axi_periph_to_s00_couplers_WVALID = S00_AXI_wvalid;
  m00_couplers_imp_1H7AUOX m00_couplers
       (.M_ACLK(ps7_0_axi_periph_ACLK_net),
        .M_ARESETN(ps7_0_axi_periph_ARESETN_net),
        .M_AXI_araddr(m00_couplers_to_ps7_0_axi_periph_ARADDR),
        .M_AXI_arready(m00_couplers_to_ps7_0_axi_periph_ARREADY),
        .M_AXI_arvalid(m00_couplers_to_ps7_0_axi_periph_ARVALID),
        .M_AXI_awaddr(m00_couplers_to_ps7_0_axi_periph_AWADDR),
        .M_AXI_awready(m00_couplers_to_ps7_0_axi_periph_AWREADY),
        .M_AXI_awvalid(m00_couplers_to_ps7_0_axi_periph_AWVALID),
        .M_AXI_bready(m00_couplers_to_ps7_0_axi_periph_BREADY),
        .M_AXI_bresp(m00_couplers_to_ps7_0_axi_periph_BRESP),
        .M_AXI_bvalid(m00_couplers_to_ps7_0_axi_periph_BVALID),
        .M_AXI_rdata(m00_couplers_to_ps7_0_axi_periph_RDATA),
        .M_AXI_rready(m00_couplers_to_ps7_0_axi_periph_RREADY),
        .M_AXI_rresp(m00_couplers_to_ps7_0_axi_periph_RRESP),
        .M_AXI_rvalid(m00_couplers_to_ps7_0_axi_periph_RVALID),
        .M_AXI_wdata(m00_couplers_to_ps7_0_axi_periph_WDATA),
        .M_AXI_wready(m00_couplers_to_ps7_0_axi_periph_WREADY),
        .M_AXI_wvalid(m00_couplers_to_ps7_0_axi_periph_WVALID),
        .S_ACLK(ps7_0_axi_periph_ACLK_net),
        .S_ARESETN(ps7_0_axi_periph_ARESETN_net),
        .S_AXI_araddr(xbar_to_m00_couplers_ARADDR),
        .S_AXI_arready(xbar_to_m00_couplers_ARREADY),
        .S_AXI_arvalid(xbar_to_m00_couplers_ARVALID),
        .S_AXI_awaddr(xbar_to_m00_couplers_AWADDR),
        .S_AXI_awready(xbar_to_m00_couplers_AWREADY),
        .S_AXI_awvalid(xbar_to_m00_couplers_AWVALID),
        .S_AXI_bready(xbar_to_m00_couplers_BREADY),
        .S_AXI_bresp(xbar_to_m00_couplers_BRESP),
        .S_AXI_bvalid(xbar_to_m00_couplers_BVALID),
        .S_AXI_rdata(xbar_to_m00_couplers_RDATA),
        .S_AXI_rready(xbar_to_m00_couplers_RREADY),
        .S_AXI_rresp(xbar_to_m00_couplers_RRESP),
        .S_AXI_rvalid(xbar_to_m00_couplers_RVALID),
        .S_AXI_wdata(xbar_to_m00_couplers_WDATA),
        .S_AXI_wready(xbar_to_m00_couplers_WREADY),
        .S_AXI_wvalid(xbar_to_m00_couplers_WVALID));
  m01_couplers_imp_4Y7TYO m01_couplers
       (.M_ACLK(ps7_0_axi_periph_ACLK_net),
        .M_ARESETN(ps7_0_axi_periph_ARESETN_net),
        .M_AXI_araddr(m01_couplers_to_ps7_0_axi_periph_ARADDR),
        .M_AXI_arready(m01_couplers_to_ps7_0_axi_periph_ARREADY),
        .M_AXI_arvalid(m01_couplers_to_ps7_0_axi_periph_ARVALID),
        .M_AXI_awaddr(m01_couplers_to_ps7_0_axi_periph_AWADDR),
        .M_AXI_awready(m01_couplers_to_ps7_0_axi_periph_AWREADY),
        .M_AXI_awvalid(m01_couplers_to_ps7_0_axi_periph_AWVALID),
        .M_AXI_bready(m01_couplers_to_ps7_0_axi_periph_BREADY),
        .M_AXI_bresp(m01_couplers_to_ps7_0_axi_periph_BRESP),
        .M_AXI_bvalid(m01_couplers_to_ps7_0_axi_periph_BVALID),
        .M_AXI_rdata(m01_couplers_to_ps7_0_axi_periph_RDATA),
        .M_AXI_rready(m01_couplers_to_ps7_0_axi_periph_RREADY),
        .M_AXI_rresp(m01_couplers_to_ps7_0_axi_periph_RRESP),
        .M_AXI_rvalid(m01_couplers_to_ps7_0_axi_periph_RVALID),
        .M_AXI_wdata(m01_couplers_to_ps7_0_axi_periph_WDATA),
        .M_AXI_wready(m01_couplers_to_ps7_0_axi_periph_WREADY),
        .M_AXI_wstrb(m01_couplers_to_ps7_0_axi_periph_WSTRB),
        .M_AXI_wvalid(m01_couplers_to_ps7_0_axi_periph_WVALID),
        .S_ACLK(ps7_0_axi_periph_ACLK_net),
        .S_ARESETN(ps7_0_axi_periph_ARESETN_net),
        .S_AXI_araddr(xbar_to_m01_couplers_ARADDR),
        .S_AXI_arready(xbar_to_m01_couplers_ARREADY),
        .S_AXI_arvalid(xbar_to_m01_couplers_ARVALID),
        .S_AXI_awaddr(xbar_to_m01_couplers_AWADDR),
        .S_AXI_awready(xbar_to_m01_couplers_AWREADY),
        .S_AXI_awvalid(xbar_to_m01_couplers_AWVALID),
        .S_AXI_bready(xbar_to_m01_couplers_BREADY),
        .S_AXI_bresp(xbar_to_m01_couplers_BRESP),
        .S_AXI_bvalid(xbar_to_m01_couplers_BVALID),
        .S_AXI_rdata(xbar_to_m01_couplers_RDATA),
        .S_AXI_rready(xbar_to_m01_couplers_RREADY),
        .S_AXI_rresp(xbar_to_m01_couplers_RRESP),
        .S_AXI_rvalid(xbar_to_m01_couplers_RVALID),
        .S_AXI_wdata(xbar_to_m01_couplers_WDATA),
        .S_AXI_wready(xbar_to_m01_couplers_WREADY),
        .S_AXI_wstrb(xbar_to_m01_couplers_WSTRB),
        .S_AXI_wvalid(xbar_to_m01_couplers_WVALID));
  m02_couplers_imp_FKL2TE m02_couplers
       (.M_ACLK(ps7_0_axi_periph_ACLK_net),
        .M_ARESETN(ps7_0_axi_periph_ARESETN_net),
        .M_AXI_araddr(m02_couplers_to_ps7_0_axi_periph_ARADDR),
        .M_AXI_arprot(m02_couplers_to_ps7_0_axi_periph_ARPROT),
        .M_AXI_arready(m02_couplers_to_ps7_0_axi_periph_ARREADY),
        .M_AXI_arvalid(m02_couplers_to_ps7_0_axi_periph_ARVALID),
        .M_AXI_awaddr(m02_couplers_to_ps7_0_axi_periph_AWADDR),
        .M_AXI_awprot(m02_couplers_to_ps7_0_axi_periph_AWPROT),
        .M_AXI_awready(m02_couplers_to_ps7_0_axi_periph_AWREADY),
        .M_AXI_awvalid(m02_couplers_to_ps7_0_axi_periph_AWVALID),
        .M_AXI_bready(m02_couplers_to_ps7_0_axi_periph_BREADY),
        .M_AXI_bresp(m02_couplers_to_ps7_0_axi_periph_BRESP),
        .M_AXI_bvalid(m02_couplers_to_ps7_0_axi_periph_BVALID),
        .M_AXI_rdata(m02_couplers_to_ps7_0_axi_periph_RDATA),
        .M_AXI_rready(m02_couplers_to_ps7_0_axi_periph_RREADY),
        .M_AXI_rresp(m02_couplers_to_ps7_0_axi_periph_RRESP),
        .M_AXI_rvalid(m02_couplers_to_ps7_0_axi_periph_RVALID),
        .M_AXI_wdata(m02_couplers_to_ps7_0_axi_periph_WDATA),
        .M_AXI_wready(m02_couplers_to_ps7_0_axi_periph_WREADY),
        .M_AXI_wstrb(m02_couplers_to_ps7_0_axi_periph_WSTRB),
        .M_AXI_wvalid(m02_couplers_to_ps7_0_axi_periph_WVALID),
        .S_ACLK(ps7_0_axi_periph_ACLK_net),
        .S_ARESETN(ps7_0_axi_periph_ARESETN_net),
        .S_AXI_araddr(xbar_to_m02_couplers_ARADDR),
        .S_AXI_arprot(xbar_to_m02_couplers_ARPROT),
        .S_AXI_arready(xbar_to_m02_couplers_ARREADY),
        .S_AXI_arvalid(xbar_to_m02_couplers_ARVALID),
        .S_AXI_awaddr(xbar_to_m02_couplers_AWADDR),
        .S_AXI_awprot(xbar_to_m02_couplers_AWPROT),
        .S_AXI_awready(xbar_to_m02_couplers_AWREADY),
        .S_AXI_awvalid(xbar_to_m02_couplers_AWVALID),
        .S_AXI_bready(xbar_to_m02_couplers_BREADY),
        .S_AXI_bresp(xbar_to_m02_couplers_BRESP),
        .S_AXI_bvalid(xbar_to_m02_couplers_BVALID),
        .S_AXI_rdata(xbar_to_m02_couplers_RDATA),
        .S_AXI_rready(xbar_to_m02_couplers_RREADY),
        .S_AXI_rresp(xbar_to_m02_couplers_RRESP),
        .S_AXI_rvalid(xbar_to_m02_couplers_RVALID),
        .S_AXI_wdata(xbar_to_m02_couplers_WDATA),
        .S_AXI_wready(xbar_to_m02_couplers_WREADY),
        .S_AXI_wstrb(xbar_to_m02_couplers_WSTRB),
        .S_AXI_wvalid(xbar_to_m02_couplers_WVALID));
  s00_couplers_imp_11SE3QO s00_couplers
       (.M_ACLK(ps7_0_axi_periph_ACLK_net),
        .M_ARESETN(ps7_0_axi_periph_ARESETN_net),
        .M_AXI_araddr(s00_couplers_to_xbar_ARADDR),
        .M_AXI_arprot(s00_couplers_to_xbar_ARPROT),
        .M_AXI_arready(s00_couplers_to_xbar_ARREADY),
        .M_AXI_arvalid(s00_couplers_to_xbar_ARVALID),
        .M_AXI_awaddr(s00_couplers_to_xbar_AWADDR),
        .M_AXI_awprot(s00_couplers_to_xbar_AWPROT),
        .M_AXI_awready(s00_couplers_to_xbar_AWREADY),
        .M_AXI_awvalid(s00_couplers_to_xbar_AWVALID),
        .M_AXI_bready(s00_couplers_to_xbar_BREADY),
        .M_AXI_bresp(s00_couplers_to_xbar_BRESP),
        .M_AXI_bvalid(s00_couplers_to_xbar_BVALID),
        .M_AXI_rdata(s00_couplers_to_xbar_RDATA),
        .M_AXI_rready(s00_couplers_to_xbar_RREADY),
        .M_AXI_rresp(s00_couplers_to_xbar_RRESP),
        .M_AXI_rvalid(s00_couplers_to_xbar_RVALID),
        .M_AXI_wdata(s00_couplers_to_xbar_WDATA),
        .M_AXI_wready(s00_couplers_to_xbar_WREADY),
        .M_AXI_wstrb(s00_couplers_to_xbar_WSTRB),
        .M_AXI_wvalid(s00_couplers_to_xbar_WVALID),
        .S_ACLK(ps7_0_axi_periph_ACLK_net),
        .S_ARESETN(ps7_0_axi_periph_ARESETN_net),
        .S_AXI_araddr(ps7_0_axi_periph_to_s00_couplers_ARADDR),
        .S_AXI_arburst(ps7_0_axi_periph_to_s00_couplers_ARBURST),
        .S_AXI_arcache(ps7_0_axi_periph_to_s00_couplers_ARCACHE),
        .S_AXI_arlen(ps7_0_axi_periph_to_s00_couplers_ARLEN),
        .S_AXI_arlock(ps7_0_axi_periph_to_s00_couplers_ARLOCK),
        .S_AXI_arprot(ps7_0_axi_periph_to_s00_couplers_ARPROT),
        .S_AXI_arqos(ps7_0_axi_periph_to_s00_couplers_ARQOS),
        .S_AXI_arready(ps7_0_axi_periph_to_s00_couplers_ARREADY),
        .S_AXI_arsize(ps7_0_axi_periph_to_s00_couplers_ARSIZE),
        .S_AXI_arvalid(ps7_0_axi_periph_to_s00_couplers_ARVALID),
        .S_AXI_awaddr(ps7_0_axi_periph_to_s00_couplers_AWADDR),
        .S_AXI_awburst(ps7_0_axi_periph_to_s00_couplers_AWBURST),
        .S_AXI_awcache(ps7_0_axi_periph_to_s00_couplers_AWCACHE),
        .S_AXI_awlen(ps7_0_axi_periph_to_s00_couplers_AWLEN),
        .S_AXI_awlock(ps7_0_axi_periph_to_s00_couplers_AWLOCK),
        .S_AXI_awprot(ps7_0_axi_periph_to_s00_couplers_AWPROT),
        .S_AXI_awqos(ps7_0_axi_periph_to_s00_couplers_AWQOS),
        .S_AXI_awready(ps7_0_axi_periph_to_s00_couplers_AWREADY),
        .S_AXI_awsize(ps7_0_axi_periph_to_s00_couplers_AWSIZE),
        .S_AXI_awvalid(ps7_0_axi_periph_to_s00_couplers_AWVALID),
        .S_AXI_bready(ps7_0_axi_periph_to_s00_couplers_BREADY),
        .S_AXI_bresp(ps7_0_axi_periph_to_s00_couplers_BRESP),
        .S_AXI_bvalid(ps7_0_axi_periph_to_s00_couplers_BVALID),
        .S_AXI_rdata(ps7_0_axi_periph_to_s00_couplers_RDATA),
        .S_AXI_rlast(ps7_0_axi_periph_to_s00_couplers_RLAST),
        .S_AXI_rready(ps7_0_axi_periph_to_s00_couplers_RREADY),
        .S_AXI_rresp(ps7_0_axi_periph_to_s00_couplers_RRESP),
        .S_AXI_rvalid(ps7_0_axi_periph_to_s00_couplers_RVALID),
        .S_AXI_wdata(ps7_0_axi_periph_to_s00_couplers_WDATA),
        .S_AXI_wlast(ps7_0_axi_periph_to_s00_couplers_WLAST),
        .S_AXI_wready(ps7_0_axi_periph_to_s00_couplers_WREADY),
        .S_AXI_wstrb(ps7_0_axi_periph_to_s00_couplers_WSTRB),
        .S_AXI_wvalid(ps7_0_axi_periph_to_s00_couplers_WVALID));
  system_xbar_2 xbar
       (.aclk(ps7_0_axi_periph_ACLK_net),
        .aresetn(ps7_0_axi_periph_ARESETN_net),
        .m_axi_araddr({xbar_to_m02_couplers_ARADDR,xbar_to_m01_couplers_ARADDR,xbar_to_m00_couplers_ARADDR}),
        .m_axi_arprot({xbar_to_m02_couplers_ARPROT,NLW_xbar_m_axi_arprot_UNCONNECTED[5:0]}),
        .m_axi_arready({xbar_to_m02_couplers_ARREADY,xbar_to_m01_couplers_ARREADY,xbar_to_m00_couplers_ARREADY}),
        .m_axi_arvalid({xbar_to_m02_couplers_ARVALID,xbar_to_m01_couplers_ARVALID,xbar_to_m00_couplers_ARVALID}),
        .m_axi_awaddr({xbar_to_m02_couplers_AWADDR,xbar_to_m01_couplers_AWADDR,xbar_to_m00_couplers_AWADDR}),
        .m_axi_awprot({xbar_to_m02_couplers_AWPROT,NLW_xbar_m_axi_awprot_UNCONNECTED[5:0]}),
        .m_axi_awready({xbar_to_m02_couplers_AWREADY,xbar_to_m01_couplers_AWREADY,xbar_to_m00_couplers_AWREADY}),
        .m_axi_awvalid({xbar_to_m02_couplers_AWVALID,xbar_to_m01_couplers_AWVALID,xbar_to_m00_couplers_AWVALID}),
        .m_axi_bready({xbar_to_m02_couplers_BREADY,xbar_to_m01_couplers_BREADY,xbar_to_m00_couplers_BREADY}),
        .m_axi_bresp({xbar_to_m02_couplers_BRESP,xbar_to_m01_couplers_BRESP,xbar_to_m00_couplers_BRESP}),
        .m_axi_bvalid({xbar_to_m02_couplers_BVALID,xbar_to_m01_couplers_BVALID,xbar_to_m00_couplers_BVALID}),
        .m_axi_rdata({xbar_to_m02_couplers_RDATA,xbar_to_m01_couplers_RDATA,xbar_to_m00_couplers_RDATA}),
        .m_axi_rready({xbar_to_m02_couplers_RREADY,xbar_to_m01_couplers_RREADY,xbar_to_m00_couplers_RREADY}),
        .m_axi_rresp({xbar_to_m02_couplers_RRESP,xbar_to_m01_couplers_RRESP,xbar_to_m00_couplers_RRESP}),
        .m_axi_rvalid({xbar_to_m02_couplers_RVALID,xbar_to_m01_couplers_RVALID,xbar_to_m00_couplers_RVALID}),
        .m_axi_wdata({xbar_to_m02_couplers_WDATA,xbar_to_m01_couplers_WDATA,xbar_to_m00_couplers_WDATA}),
        .m_axi_wready({xbar_to_m02_couplers_WREADY,xbar_to_m01_couplers_WREADY,xbar_to_m00_couplers_WREADY}),
        .m_axi_wstrb({xbar_to_m02_couplers_WSTRB,xbar_to_m01_couplers_WSTRB,NLW_xbar_m_axi_wstrb_UNCONNECTED[3:0]}),
        .m_axi_wvalid({xbar_to_m02_couplers_WVALID,xbar_to_m01_couplers_WVALID,xbar_to_m00_couplers_WVALID}),
        .s_axi_araddr(s00_couplers_to_xbar_ARADDR),
        .s_axi_arprot(s00_couplers_to_xbar_ARPROT),
        .s_axi_arready(s00_couplers_to_xbar_ARREADY),
        .s_axi_arvalid(s00_couplers_to_xbar_ARVALID),
        .s_axi_awaddr(s00_couplers_to_xbar_AWADDR),
        .s_axi_awprot(s00_couplers_to_xbar_AWPROT),
        .s_axi_awready(s00_couplers_to_xbar_AWREADY),
        .s_axi_awvalid(s00_couplers_to_xbar_AWVALID),
        .s_axi_bready(s00_couplers_to_xbar_BREADY),
        .s_axi_bresp(s00_couplers_to_xbar_BRESP),
        .s_axi_bvalid(s00_couplers_to_xbar_BVALID),
        .s_axi_rdata(s00_couplers_to_xbar_RDATA),
        .s_axi_rready(s00_couplers_to_xbar_RREADY),
        .s_axi_rresp(s00_couplers_to_xbar_RRESP),
        .s_axi_rvalid(s00_couplers_to_xbar_RVALID),
        .s_axi_wdata(s00_couplers_to_xbar_WDATA),
        .s_axi_wready(s00_couplers_to_xbar_WREADY),
        .s_axi_wstrb(s00_couplers_to_xbar_WSTRB),
        .s_axi_wvalid(s00_couplers_to_xbar_WVALID));
endmodule
