StevekDon/NaI-Tl-scintillator-gamma-ray-Digital-Multi-Channel-Analyzer/firmware/vivado/zynq_dmca.gen/sources_1/bd/system/hdl/system_wrapper.v

//Copyright 1986-2022 Xilinx, Inc. All Rights Reserved.
//--------------------------------------------------------------------------------
//Tool Version: Vivado v.2022.2 (win64) Build 3671981 Fri Oct 14 05:00:03 MDT 2022
//Date        : Sun Jul  6 14:56:05 2025
//Host        : Steve running 64-bit major release  (build 9200)
//Command     : generate_target system_wrapper.bd
//Design      : system_wrapper
//Purpose     : IP block netlist
//--------------------------------------------------------------------------------
`timescale 1 ps / 1 ps

module system_wrapper
   (DDR_addr,
    DDR_ba,
    DDR_cas_n,
    DDR_ck_n,
    DDR_ck_p,
    DDR_cke,
    DDR_cs_n,
    DDR_dm,
    DDR_dq,
    DDR_dqs_n,
    DDR_dqs_p,
    DDR_odt,
    DDR_ras_n,
    DDR_reset_n,
    DDR_we_n,
    FIXED_IO_ddr_vrn,
    FIXED_IO_ddr_vrp,
    FIXED_IO_mio,
    FIXED_IO_ps_clk,
    FIXED_IO_ps_porb,
    FIXED_IO_ps_srstb,
    GPIO_0_0_tri_io,
    UART_1_rxd,
    UART_1_txd,
    adc_datain,
    adc_driver_clk,
    adc_pwr_en);
  inout [14:0]DDR_addr;
  inout [2:0]DDR_ba;
  inout DDR_cas_n;
  inout DDR_ck_n;
  inout DDR_ck_p;
  inout DDR_cke;
  inout DDR_cs_n;
  inout [3:0]DDR_dm;
  inout [31:0]DDR_dq;
  inout [3:0]DDR_dqs_n;
  inout [3:0]DDR_dqs_p;
  inout DDR_odt;
  inout DDR_ras_n;
  inout DDR_reset_n;
  inout DDR_we_n;
  inout FIXED_IO_ddr_vrn;
  inout FIXED_IO_ddr_vrp;
  inout [53:0]FIXED_IO_mio;
  inout FIXED_IO_ps_clk;
  inout FIXED_IO_ps_porb;
  inout FIXED_IO_ps_srstb;
  inout [3:0]GPIO_0_0_tri_io;
  input UART_1_rxd;
  output UART_1_txd;
  input [13:0]adc_datain;
  output adc_driver_clk;
  output adc_pwr_en;

  wire [14:0]DDR_addr;
  wire [2:0]DDR_ba;
  wire DDR_cas_n;
  wire DDR_ck_n;
  wire DDR_ck_p;
  wire DDR_cke;
  wire DDR_cs_n;
  wire [3:0]DDR_dm;
  wire [31:0]DDR_dq;
  wire [3:0]DDR_dqs_n;
  wire [3:0]DDR_dqs_p;
  wire DDR_odt;
  wire DDR_ras_n;
  wire DDR_reset_n;
  wire DDR_we_n;
  wire FIXED_IO_ddr_vrn;
  wire FIXED_IO_ddr_vrp;
  wire [53:0]FIXED_IO_mio;
  wire FIXED_IO_ps_clk;
  wire FIXED_IO_ps_porb;
  wire FIXED_IO_ps_srstb;
  wire [0:0]GPIO_0_0_tri_i_0;
  wire [1:1]GPIO_0_0_tri_i_1;
  wire [2:2]GPIO_0_0_tri_i_2;
  wire [3:3]GPIO_0_0_tri_i_3;
  wire [0:0]GPIO_0_0_tri_io_0;
  wire [1:1]GPIO_0_0_tri_io_1;
  wire [2:2]GPIO_0_0_tri_io_2;
  wire [3:3]GPIO_0_0_tri_io_3;
  wire [0:0]GPIO_0_0_tri_o_0;
  wire [1:1]GPIO_0_0_tri_o_1;
  wire [2:2]GPIO_0_0_tri_o_2;
  wire [3:3]GPIO_0_0_tri_o_3;
  wire [0:0]GPIO_0_0_tri_t_0;
  wire [1:1]GPIO_0_0_tri_t_1;
  wire [2:2]GPIO_0_0_tri_t_2;
  wire [3:3]GPIO_0_0_tri_t_3;
  wire UART_1_rxd;
  wire UART_1_txd;
  wire [13:0]adc_datain;
  wire adc_driver_clk;
  wire adc_pwr_en;

  IOBUF GPIO_0_0_tri_iobuf_0
       (.I(GPIO_0_0_tri_o_0),
        .IO(GPIO_0_0_tri_io[0]),
        .O(GPIO_0_0_tri_i_0),
        .T(GPIO_0_0_tri_t_0));
  IOBUF GPIO_0_0_tri_iobuf_1
       (.I(GPIO_0_0_tri_o_1),
        .IO(GPIO_0_0_tri_io[1]),
        .O(GPIO_0_0_tri_i_1),
        .T(GPIO_0_0_tri_t_1));
  IOBUF GPIO_0_0_tri_iobuf_2
       (.I(GPIO_0_0_tri_o_2),
        .IO(GPIO_0_0_tri_io[2]),
        .O(GPIO_0_0_tri_i_2),
        .T(GPIO_0_0_tri_t_2));
  IOBUF GPIO_0_0_tri_iobuf_3
       (.I(GPIO_0_0_tri_o_3),
        .IO(GPIO_0_0_tri_io[3]),
        .O(GPIO_0_0_tri_i_3),
        .T(GPIO_0_0_tri_t_3));
  system system_i
       (.DDR_addr(DDR_addr),
        .DDR_ba(DDR_ba),
        .DDR_cas_n(DDR_cas_n),
        .DDR_ck_n(DDR_ck_n),
        .DDR_ck_p(DDR_ck_p),
        .DDR_cke(DDR_cke),
        .DDR_cs_n(DDR_cs_n),
        .DDR_dm(DDR_dm),
        .DDR_dq(DDR_dq),
        .DDR_dqs_n(DDR_dqs_n),
        .DDR_dqs_p(DDR_dqs_p),
        .DDR_odt(DDR_odt),
        .DDR_ras_n(DDR_ras_n),
        .DDR_reset_n(DDR_reset_n),
        .DDR_we_n(DDR_we_n),
        .FIXED_IO_ddr_vrn(FIXED_IO_ddr_vrn),
        .FIXED_IO_ddr_vrp(FIXED_IO_ddr_vrp),
        .FIXED_IO_mio(FIXED_IO_mio),
        .FIXED_IO_ps_clk(FIXED_IO_ps_clk),
        .FIXED_IO_ps_porb(FIXED_IO_ps_porb),
        .FIXED_IO_ps_srstb(FIXED_IO_ps_srstb),
        .GPIO_0_0_tri_i({GPIO_0_0_tri_i_3,GPIO_0_0_tri_i_2,GPIO_0_0_tri_i_1,GPIO_0_0_tri_i_0}),
        .GPIO_0_0_tri_o({GPIO_0_0_tri_o_3,GPIO_0_0_tri_o_2,GPIO_0_0_tri_o_1,GPIO_0_0_tri_o_0}),
        .GPIO_0_0_tri_t({GPIO_0_0_tri_t_3,GPIO_0_0_tri_t_2,GPIO_0_0_tri_t_1,GPIO_0_0_tri_t_0}),
        .UART_1_rxd(UART_1_rxd),
        .UART_1_txd(UART_1_txd),
        .adc_datain(adc_datain),
        .adc_driver_clk(adc_driver_clk),
        .adc_pwr_en(adc_pwr_en));
endmodule
