StevekDon/NaI-Tl-scintillator-gamma-ray-Digital-Multi-Channel-Analyzer/firmware/vivado/zynq_dmca.gen/sources_1/bd/system/ip/system_axi_ctrl_0_0/system_axi_ctrl_0_0_sim_netlist.v

// Copyright 1986-2022 Xilinx, Inc. All Rights Reserved.
// --------------------------------------------------------------------------------
// Tool Version: Vivado v.2022.2 (win64) Build 3671981 Fri Oct 14 05:00:03 MDT 2022
// Date        : Wed Jun  4 22:19:16 2025
// Host        : Steve running 64-bit major release  (build 9200)
// Command     : write_verilog -force -mode funcsim
//               c:/Users/Steve/Desktop/zynq7020/vivado_prj/zynq_dmca/zynq_dmca/zynq_dmca.gen/sources_1/bd/system/ip/system_axi_ctrl_0_0/system_axi_ctrl_0_0_sim_netlist.v
// Design      : system_axi_ctrl_0_0
// Purpose     : This verilog netlist is a functional simulation representation of the design and should not be modified
//               or synthesized. This netlist cannot be used for SDF annotated simulation.
// Device      : xc7z020clg400-2
// --------------------------------------------------------------------------------
`timescale 1 ps / 1 ps

(* CHECK_LICENSE_TYPE = "system_axi_ctrl_0_0,axi_ctrl_v0_1_0,{}" *) (* DowngradeIPIdentifiedWarnings = "yes" *) (* X_CORE_INFO = "axi_ctrl_v0_1_0,Vivado 2022.2" *) 
(* NotValidForBitStream *)
module system_axi_ctrl_0_0
   (s00_axi_aclk,
    s00_axi_aresetn,
    s00_axi_awaddr,
    s00_axi_awprot,
    s00_axi_awvalid,
    s00_axi_awready,
    s00_axi_wdata,
    s00_axi_wstrb,
    s00_axi_wvalid,
    s00_axi_wready,
    s00_axi_bresp,
    s00_axi_bvalid,
    s00_axi_bready,
    s00_axi_araddr,
    s00_axi_arprot,
    s00_axi_arvalid,
    s00_axi_arready,
    s00_axi_rdata,
    s00_axi_rresp,
    s00_axi_rvalid,
    s00_axi_rready,
    timer_counter,
    na,
    nb,
    na_1,
    d_na,
    peak_thd,
    peak_thd_count,
    peak_top_delay,
    adc_pwr_en,
    ms_en);
  (* X_INTERFACE_INFO = "xilinx.com:signal:clock:1.0 S00_AXI_CLK CLK" *) (* X_INTERFACE_PARAMETER = "XIL_INTERFACENAME S00_AXI_CLK, ASSOCIATED_BUSIF S00_AXI, ASSOCIATED_RESET s00_axi_aresetn, FREQ_HZ 8e+07, FREQ_TOLERANCE_HZ 0, PHASE 0.0, CLK_DOMAIN system_processing_system7_0_0_FCLK_CLK0, INSERT_VIP 0" *) input s00_axi_aclk;
  (* X_INTERFACE_INFO = "xilinx.com:signal:reset:1.0 S00_AXI_RST RST" *) (* X_INTERFACE_PARAMETER = "XIL_INTERFACENAME S00_AXI_RST, POLARITY ACTIVE_LOW, INSERT_VIP 0" *) input s00_axi_aresetn;
  (* X_INTERFACE_INFO = "xilinx.com:interface:aximm:1.0 S00_AXI AWADDR" *) input [4:0]s00_axi_awaddr;
  (* X_INTERFACE_INFO = "xilinx.com:interface:aximm:1.0 S00_AXI AWPROT" *) input [2:0]s00_axi_awprot;
  (* X_INTERFACE_INFO = "xilinx.com:interface:aximm:1.0 S00_AXI AWVALID" *) input s00_axi_awvalid;
  (* X_INTERFACE_INFO = "xilinx.com:interface:aximm:1.0 S00_AXI AWREADY" *) output s00_axi_awready;
  (* X_INTERFACE_INFO = "xilinx.com:interface:aximm:1.0 S00_AXI WDATA" *) input [31:0]s00_axi_wdata;
  (* X_INTERFACE_INFO = "xilinx.com:interface:aximm:1.0 S00_AXI WSTRB" *) input [3:0]s00_axi_wstrb;
  (* X_INTERFACE_INFO = "xilinx.com:interface:aximm:1.0 S00_AXI WVALID" *) input s00_axi_wvalid;
  (* X_INTERFACE_INFO = "xilinx.com:interface:aximm:1.0 S00_AXI WREADY" *) output s00_axi_wready;
  (* X_INTERFACE_INFO = "xilinx.com:interface:aximm:1.0 S00_AXI BRESP" *) output [1:0]s00_axi_bresp;
  (* X_INTERFACE_INFO = "xilinx.com:interface:aximm:1.0 S00_AXI BVALID" *) output s00_axi_bvalid;
  (* X_INTERFACE_INFO = "xilinx.com:interface:aximm:1.0 S00_AXI BREADY" *) input s00_axi_bready;
  (* X_INTERFACE_INFO = "xilinx.com:interface:aximm:1.0 S00_AXI ARADDR" *) input [4:0]s00_axi_araddr;
  (* X_INTERFACE_INFO = "xilinx.com:interface:aximm:1.0 S00_AXI ARPROT" *) input [2:0]s00_axi_arprot;
  (* X_INTERFACE_INFO = "xilinx.com:interface:aximm:1.0 S00_AXI ARVALID" *) input s00_axi_arvalid;
  (* X_INTERFACE_INFO = "xilinx.com:interface:aximm:1.0 S00_AXI ARREADY" *) output s00_axi_arready;
  (* X_INTERFACE_INFO = "xilinx.com:interface:aximm:1.0 S00_AXI RDATA" *) output [31:0]s00_axi_rdata;
  (* X_INTERFACE_INFO = "xilinx.com:interface:aximm:1.0 S00_AXI RRESP" *) output [1:0]s00_axi_rresp;
  (* X_INTERFACE_INFO = "xilinx.com:interface:aximm:1.0 S00_AXI RVALID" *) output s00_axi_rvalid;
  (* X_INTERFACE_INFO = "xilinx.com:interface:aximm:1.0 S00_AXI RREADY" *) (* X_INTERFACE_PARAMETER = "XIL_INTERFACENAME S00_AXI, WIZ_DATA_WIDTH 32, WIZ_NUM_REG 5, SUPPORTS_NARROW_BURST 0, DATA_WIDTH 32, PROTOCOL AXI4LITE, FREQ_HZ 8e+07, ID_WIDTH 0, ADDR_WIDTH 5, AWUSER_WIDTH 0, ARUSER_WIDTH 0, WUSER_WIDTH 0, RUSER_WIDTH 0, BUSER_WIDTH 0, READ_WRITE_MODE READ_WRITE, HAS_BURST 0, HAS_LOCK 0, HAS_PROT 1, HAS_CACHE 0, HAS_QOS 0, HAS_REGION 0, HAS_WSTRB 1, HAS_BRESP 1, HAS_RRESP 1, NUM_READ_OUTSTANDING 1, NUM_WRITE_OUTSTANDING 1, MAX_BURST_LENGTH 1, PHASE 0.0, CLK_DOMAIN system_processing_system7_0_0_FCLK_CLK0, NUM_READ_THREADS 1, NUM_WRITE_THREADS 1, RUSER_BITS_PER_BYTE 0, WUSER_BITS_PER_BYTE 0, INSERT_VIP 0" *) input s00_axi_rready;
  input [31:0]timer_counter;
  output [15:0]na;
  output [15:0]nb;
  output [15:0]na_1;
  output [15:0]d_na;
  output [15:0]peak_thd;
  output [7:0]peak_thd_count;
  output [7:0]peak_top_delay;
  output adc_pwr_en;
  output ms_en;

  wire \<const0> ;
  wire adc_pwr_en;
  wire [15:0]d_na;
  wire ms_en;
  wire [15:0]na;
  wire [15:0]na_1;
  wire [15:0]nb;
  wire [15:0]peak_thd;
  wire [7:0]peak_thd_count;
  wire [7:0]peak_top_delay;
  wire s00_axi_aclk;
  wire [4:0]s00_axi_araddr;
  wire s00_axi_aresetn;
  wire s00_axi_arready;
  wire s00_axi_arvalid;
  wire [4:0]s00_axi_awaddr;
  wire s00_axi_awready;
  wire s00_axi_awvalid;
  wire s00_axi_bready;
  wire s00_axi_bvalid;
  wire [31:0]s00_axi_rdata;
  wire s00_axi_rready;
  wire s00_axi_rvalid;
  wire [31:0]s00_axi_wdata;
  wire s00_axi_wready;
  wire [3:0]s00_axi_wstrb;
  wire s00_axi_wvalid;
  wire [31:0]timer_counter;

  assign s00_axi_bresp[1] = \<const0> ;
  assign s00_axi_bresp[0] = \<const0> ;
  assign s00_axi_rresp[1] = \<const0> ;
  assign s00_axi_rresp[0] = \<const0> ;
  GND GND
       (.G(\<const0> ));
  system_axi_ctrl_0_0_axi_ctrl_v0_1_0 inst
       (.Q({ms_en,adc_pwr_en}),
        .S_AXI_ARREADY(s00_axi_arready),
        .S_AXI_AWREADY(s00_axi_awready),
        .S_AXI_WREADY(s00_axi_wready),
        .peak_top_delay(peak_top_delay),
        .s00_axi_aclk(s00_axi_aclk),
        .s00_axi_araddr(s00_axi_araddr[4:2]),
        .s00_axi_aresetn(s00_axi_aresetn),
        .s00_axi_arvalid(s00_axi_arvalid),
        .s00_axi_awaddr(s00_axi_awaddr[4:2]),
        .s00_axi_awvalid(s00_axi_awvalid),
        .s00_axi_bready(s00_axi_bready),
        .s00_axi_bvalid(s00_axi_bvalid),
        .s00_axi_rdata(s00_axi_rdata),
        .s00_axi_rready(s00_axi_rready),
        .s00_axi_rvalid(s00_axi_rvalid),
        .s00_axi_wdata(s00_axi_wdata),
        .s00_axi_wstrb(s00_axi_wstrb),
        .s00_axi_wvalid(s00_axi_wvalid),
        .\slv_reg1_reg[31] ({nb,na}),
        .\slv_reg2_reg[31] ({d_na,na_1}),
        .\slv_reg3_reg[23] ({peak_thd_count,peak_thd}),
        .timer_counter(timer_counter));
endmodule

(* ORIG_REF_NAME = "axi_ctrl_v0_1_0" *) 
module system_axi_ctrl_0_0_axi_ctrl_v0_1_0
   (S_AXI_WREADY,
    S_AXI_AWREADY,
    S_AXI_ARREADY,
    Q,
    \slv_reg1_reg[31] ,
    \slv_reg2_reg[31] ,
    \slv_reg3_reg[23] ,
    peak_top_delay,
    s00_axi_rdata,
    s00_axi_rvalid,
    s00_axi_bvalid,
    s00_axi_aclk,
    s00_axi_awaddr,
    s00_axi_wvalid,
    s00_axi_awvalid,
    s00_axi_wdata,
    s00_axi_araddr,
    s00_axi_arvalid,
    timer_counter,
    s00_axi_wstrb,
    s00_axi_aresetn,
    s00_axi_bready,
    s00_axi_rready);
  output S_AXI_WREADY;
  output S_AXI_AWREADY;
  output S_AXI_ARREADY;
  output [1:0]Q;
  output [31:0]\slv_reg1_reg[31] ;
  output [31:0]\slv_reg2_reg[31] ;
  output [23:0]\slv_reg3_reg[23] ;
  output [7:0]peak_top_delay;
  output [31:0]s00_axi_rdata;
  output s00_axi_rvalid;
  output s00_axi_bvalid;
  input s00_axi_aclk;
  input [2:0]s00_axi_awaddr;
  input s00_axi_wvalid;
  input s00_axi_awvalid;
  input [31:0]s00_axi_wdata;
  input [2:0]s00_axi_araddr;
  input s00_axi_arvalid;
  input [31:0]timer_counter;
  input [3:0]s00_axi_wstrb;
  input s00_axi_aresetn;
  input s00_axi_bready;
  input s00_axi_rready;

  wire [1:0]Q;
  wire S_AXI_ARREADY;
  wire S_AXI_AWREADY;
  wire S_AXI_WREADY;
  wire [7:0]peak_top_delay;
  wire s00_axi_aclk;
  wire [2:0]s00_axi_araddr;
  wire s00_axi_aresetn;
  wire s00_axi_arvalid;
  wire [2:0]s00_axi_awaddr;
  wire s00_axi_awvalid;
  wire s00_axi_bready;
  wire s00_axi_bvalid;
  wire [31:0]s00_axi_rdata;
  wire s00_axi_rready;
  wire s00_axi_rvalid;
  wire [31:0]s00_axi_wdata;
  wire [3:0]s00_axi_wstrb;
  wire s00_axi_wvalid;
  wire [31:0]\slv_reg1_reg[31] ;
  wire [31:0]\slv_reg2_reg[31] ;
  wire [23:0]\slv_reg3_reg[23] ;
  wire [31:0]timer_counter;

  system_axi_ctrl_0_0_axi_ctrl_v0_1_0_S00_AXI axi_ctrl_v0_1_0_S00_AXI_inst
       (.Q(Q),
        .S_AXI_ARREADY(S_AXI_ARREADY),
        .S_AXI_AWREADY(S_AXI_AWREADY),
        .S_AXI_WREADY(S_AXI_WREADY),
        .peak_top_delay(peak_top_delay),
        .s00_axi_aclk(s00_axi_aclk),
        .s00_axi_araddr(s00_axi_araddr),
        .s00_axi_aresetn(s00_axi_aresetn),
        .s00_axi_arvalid(s00_axi_arvalid),
        .s00_axi_awaddr(s00_axi_awaddr),
        .s00_axi_awvalid(s00_axi_awvalid),
        .s00_axi_bready(s00_axi_bready),
        .s00_axi_bvalid(s00_axi_bvalid),
        .s00_axi_rdata(s00_axi_rdata),
        .s00_axi_rready(s00_axi_rready),
        .s00_axi_rvalid(s00_axi_rvalid),
        .s00_axi_wdata(s00_axi_wdata),
        .s00_axi_wstrb(s00_axi_wstrb),
        .s00_axi_wvalid(s00_axi_wvalid),
        .\slv_reg1_reg[31]_0 (\slv_reg1_reg[31] ),
        .\slv_reg2_reg[31]_0 (\slv_reg2_reg[31] ),
        .\slv_reg3_reg[23]_0 (\slv_reg3_reg[23] ),
        .timer_counter(timer_counter));
endmodule

(* ORIG_REF_NAME = "axi_ctrl_v0_1_0_S00_AXI" *) 
module system_axi_ctrl_0_0_axi_ctrl_v0_1_0_S00_AXI
   (S_AXI_WREADY,
    S_AXI_AWREADY,
    S_AXI_ARREADY,
    Q,
    \slv_reg1_reg[31]_0 ,
    \slv_reg2_reg[31]_0 ,
    \slv_reg3_reg[23]_0 ,
    peak_top_delay,
    s00_axi_rdata,
    s00_axi_rvalid,
    s00_axi_bvalid,
    s00_axi_aclk,
    s00_axi_awaddr,
    s00_axi_wvalid,
    s00_axi_awvalid,
    s00_axi_wdata,
    s00_axi_araddr,
    s00_axi_arvalid,
    timer_counter,
    s00_axi_wstrb,
    s00_axi_aresetn,
    s00_axi_bready,
    s00_axi_rready);
  output S_AXI_WREADY;
  output S_AXI_AWREADY;
  output S_AXI_ARREADY;
  output [1:0]Q;
  output [31:0]\slv_reg1_reg[31]_0 ;
  output [31:0]\slv_reg2_reg[31]_0 ;
  output [23:0]\slv_reg3_reg[23]_0 ;
  output [7:0]peak_top_delay;
  output [31:0]s00_axi_rdata;
  output s00_axi_rvalid;
  output s00_axi_bvalid;
  input s00_axi_aclk;
  input [2:0]s00_axi_awaddr;
  input s00_axi_wvalid;
  input s00_axi_awvalid;
  input [31:0]s00_axi_wdata;
  input [2:0]s00_axi_araddr;
  input s00_axi_arvalid;
  input [31:0]timer_counter;
  input [3:0]s00_axi_wstrb;
  input s00_axi_aresetn;
  input s00_axi_bready;
  input s00_axi_rready;

  wire [1:0]Q;
  wire S_AXI_ARREADY;
  wire S_AXI_AWREADY;
  wire S_AXI_WREADY;
  wire aw_en_i_1_n_0;
  wire aw_en_reg_n_0;
  wire \axi_araddr[2]_i_1_n_0 ;
  wire \axi_araddr[3]_i_1_n_0 ;
  wire \axi_araddr[4]_i_1_n_0 ;
  wire axi_arready0;
  wire \axi_awaddr[2]_i_1_n_0 ;
  wire \axi_awaddr[3]_i_1_n_0 ;
  wire \axi_awaddr[4]_i_1_n_0 ;
  wire axi_awready0;
  wire axi_awready_i_1_n_0;
  wire axi_bvalid_i_1_n_0;
  wire \axi_rdata[0]_i_2_n_0 ;
  wire \axi_rdata[10]_i_2_n_0 ;
  wire \axi_rdata[11]_i_2_n_0 ;
  wire \axi_rdata[12]_i_2_n_0 ;
  wire \axi_rdata[13]_i_2_n_0 ;
  wire \axi_rdata[14]_i_2_n_0 ;
  wire \axi_rdata[15]_i_2_n_0 ;
  wire \axi_rdata[16]_i_2_n_0 ;
  wire \axi_rdata[17]_i_2_n_0 ;
  wire \axi_rdata[18]_i_2_n_0 ;
  wire \axi_rdata[19]_i_2_n_0 ;
  wire \axi_rdata[1]_i_2_n_0 ;
  wire \axi_rdata[20]_i_2_n_0 ;
  wire \axi_rdata[21]_i_2_n_0 ;
  wire \axi_rdata[22]_i_2_n_0 ;
  wire \axi_rdata[23]_i_2_n_0 ;
  wire \axi_rdata[24]_i_2_n_0 ;
  wire \axi_rdata[25]_i_2_n_0 ;
  wire \axi_rdata[26]_i_2_n_0 ;
  wire \axi_rdata[27]_i_2_n_0 ;
  wire \axi_rdata[28]_i_2_n_0 ;
  wire \axi_rdata[29]_i_2_n_0 ;
  wire \axi_rdata[2]_i_2_n_0 ;
  wire \axi_rdata[30]_i_2_n_0 ;
  wire \axi_rdata[31]_i_2_n_0 ;
  wire \axi_rdata[3]_i_2_n_0 ;
  wire \axi_rdata[4]_i_2_n_0 ;
  wire \axi_rdata[5]_i_2_n_0 ;
  wire \axi_rdata[6]_i_2_n_0 ;
  wire \axi_rdata[7]_i_2_n_0 ;
  wire \axi_rdata[8]_i_2_n_0 ;
  wire \axi_rdata[9]_i_2_n_0 ;
  wire axi_rvalid_i_1_n_0;
  wire axi_wready0;
  wire [2:0]p_0_in;
  wire [31:0]p_1_in;
  wire [7:0]peak_top_delay;
  wire [31:0]reg_data_out;
  wire s00_axi_aclk;
  wire [2:0]s00_axi_araddr;
  wire s00_axi_aresetn;
  wire s00_axi_arvalid;
  wire [2:0]s00_axi_awaddr;
  wire s00_axi_awvalid;
  wire s00_axi_bready;
  wire s00_axi_bvalid;
  wire [31:0]s00_axi_rdata;
  wire s00_axi_rready;
  wire s00_axi_rvalid;
  wire [31:0]s00_axi_wdata;
  wire [3:0]s00_axi_wstrb;
  wire s00_axi_wvalid;
  wire [2:0]sel0;
  wire [31:2]slv_reg0;
  wire \slv_reg1[15]_i_1_n_0 ;
  wire \slv_reg1[23]_i_1_n_0 ;
  wire \slv_reg1[31]_i_1_n_0 ;
  wire \slv_reg1[7]_i_1_n_0 ;
  wire [31:0]\slv_reg1_reg[31]_0 ;
  wire \slv_reg2[15]_i_1_n_0 ;
  wire \slv_reg2[23]_i_1_n_0 ;
  wire \slv_reg2[31]_i_1_n_0 ;
  wire \slv_reg2[7]_i_1_n_0 ;
  wire [31:0]\slv_reg2_reg[31]_0 ;
  wire [31:24]slv_reg3;
  wire \slv_reg3[15]_i_1_n_0 ;
  wire \slv_reg3[23]_i_1_n_0 ;
  wire \slv_reg3[31]_i_1_n_0 ;
  wire \slv_reg3[7]_i_1_n_0 ;
  wire [23:0]\slv_reg3_reg[23]_0 ;
  wire [31:8]slv_reg4;
  wire \slv_reg4[15]_i_1_n_0 ;
  wire \slv_reg4[23]_i_1_n_0 ;
  wire \slv_reg4[31]_i_1_n_0 ;
  wire \slv_reg4[7]_i_1_n_0 ;
  wire slv_reg_rden__0;
  wire slv_reg_wren__0;
  wire [31:0]timer_counter;

  LUT6 #(
    .INIT(64'hF7FFC4CCC4CCC4CC)) 
    aw_en_i_1
       (.I0(s00_axi_awvalid),
        .I1(aw_en_reg_n_0),
        .I2(S_AXI_AWREADY),
        .I3(s00_axi_wvalid),
        .I4(s00_axi_bready),
        .I5(s00_axi_bvalid),
        .O(aw_en_i_1_n_0));
  FDSE aw_en_reg
       (.C(s00_axi_aclk),
        .CE(1'b1),
        .D(aw_en_i_1_n_0),
        .Q(aw_en_reg_n_0),
        .S(axi_awready_i_1_n_0));
  LUT4 #(
    .INIT(16'hFB08)) 
    \axi_araddr[2]_i_1 
       (.I0(s00_axi_araddr[0]),
        .I1(s00_axi_arvalid),
        .I2(S_AXI_ARREADY),
        .I3(sel0[0]),
        .O(\axi_araddr[2]_i_1_n_0 ));
  LUT4 #(
    .INIT(16'hFB08)) 
    \axi_araddr[3]_i_1 
       (.I0(s00_axi_araddr[1]),
        .I1(s00_axi_arvalid),
        .I2(S_AXI_ARREADY),
        .I3(sel0[1]),
        .O(\axi_araddr[3]_i_1_n_0 ));
  (* SOFT_HLUTNM = "soft_lutpair0" *) 
  LUT4 #(
    .INIT(16'hFB08)) 
    \axi_araddr[4]_i_1 
       (.I0(s00_axi_araddr[2]),
        .I1(s00_axi_arvalid),
        .I2(S_AXI_ARREADY),
        .I3(sel0[2]),
        .O(\axi_araddr[4]_i_1_n_0 ));
  FDRE \axi_araddr_reg[2] 
       (.C(s00_axi_aclk),
        .CE(1'b1),
        .D(\axi_araddr[2]_i_1_n_0 ),
        .Q(sel0[0]),
        .R(axi_awready_i_1_n_0));
  FDRE \axi_araddr_reg[3] 
       (.C(s00_axi_aclk),
        .CE(1'b1),
        .D(\axi_araddr[3]_i_1_n_0 ),
        .Q(sel0[1]),
        .R(axi_awready_i_1_n_0));
  FDRE \axi_araddr_reg[4] 
       (.C(s00_axi_aclk),
        .CE(1'b1),
        .D(\axi_araddr[4]_i_1_n_0 ),
        .Q(sel0[2]),
        .R(axi_awready_i_1_n_0));
  (* SOFT_HLUTNM = "soft_lutpair0" *) 
  LUT2 #(
    .INIT(4'h2)) 
    axi_arready_i_1
       (.I0(s00_axi_arvalid),
        .I1(S_AXI_ARREADY),
        .O(axi_arready0));
  FDRE axi_arready_reg
       (.C(s00_axi_aclk),
        .CE(1'b1),
        .D(axi_arready0),
        .Q(S_AXI_ARREADY),
        .R(axi_awready_i_1_n_0));
  LUT6 #(
    .INIT(64'hFBFFFFFF08000000)) 
    \axi_awaddr[2]_i_1 
       (.I0(s00_axi_awaddr[0]),
        .I1(s00_axi_wvalid),
        .I2(S_AXI_AWREADY),
        .I3(aw_en_reg_n_0),
        .I4(s00_axi_awvalid),
        .I5(p_0_in[0]),
        .O(\axi_awaddr[2]_i_1_n_0 ));
  LUT6 #(
    .INIT(64'hFBFFFFFF08000000)) 
    \axi_awaddr[3]_i_1 
       (.I0(s00_axi_awaddr[1]),
        .I1(s00_axi_wvalid),
        .I2(S_AXI_AWREADY),
        .I3(aw_en_reg_n_0),
        .I4(s00_axi_awvalid),
        .I5(p_0_in[1]),
        .O(\axi_awaddr[3]_i_1_n_0 ));
  LUT6 #(
    .INIT(64'hFBFFFFFF08000000)) 
    \axi_awaddr[4]_i_1 
       (.I0(s00_axi_awaddr[2]),
        .I1(s00_axi_wvalid),
        .I2(S_AXI_AWREADY),
        .I3(aw_en_reg_n_0),
        .I4(s00_axi_awvalid),
        .I5(p_0_in[2]),
        .O(\axi_awaddr[4]_i_1_n_0 ));
  FDRE \axi_awaddr_reg[2] 
       (.C(s00_axi_aclk),
        .CE(1'b1),
        .D(\axi_awaddr[2]_i_1_n_0 ),
        .Q(p_0_in[0]),
        .R(axi_awready_i_1_n_0));
  FDRE \axi_awaddr_reg[3] 
       (.C(s00_axi_aclk),
        .CE(1'b1),
        .D(\axi_awaddr[3]_i_1_n_0 ),
        .Q(p_0_in[1]),
        .R(axi_awready_i_1_n_0));
  FDRE \axi_awaddr_reg[4] 
       (.C(s00_axi_aclk),
        .CE(1'b1),
        .D(\axi_awaddr[4]_i_1_n_0 ),
        .Q(p_0_in[2]),
        .R(axi_awready_i_1_n_0));
  LUT1 #(
    .INIT(2'h1)) 
    axi_awready_i_1
       (.I0(s00_axi_aresetn),
        .O(axi_awready_i_1_n_0));
  LUT4 #(
    .INIT(16'h2000)) 
    axi_awready_i_2
       (.I0(s00_axi_wvalid),
        .I1(S_AXI_AWREADY),
        .I2(aw_en_reg_n_0),
        .I3(s00_axi_awvalid),
        .O(axi_awready0));
  FDRE axi_awready_reg
       (.C(s00_axi_aclk),
        .CE(1'b1),
        .D(axi_awready0),
        .Q(S_AXI_AWREADY),
        .R(axi_awready_i_1_n_0));
  LUT6 #(
    .INIT(64'h0000FFFF80008000)) 
    axi_bvalid_i_1
       (.I0(s00_axi_awvalid),
        .I1(s00_axi_wvalid),
        .I2(S_AXI_AWREADY),
        .I3(S_AXI_WREADY),
        .I4(s00_axi_bready),
        .I5(s00_axi_bvalid),
        .O(axi_bvalid_i_1_n_0));
  FDRE axi_bvalid_reg
       (.C(s00_axi_aclk),
        .CE(1'b1),
        .D(axi_bvalid_i_1_n_0),
        .Q(s00_axi_bvalid),
        .R(axi_awready_i_1_n_0));
  LUT6 #(
    .INIT(64'h3A0A3A3A3A0A0A0A)) 
    \axi_rdata[0]_i_1 
       (.I0(\axi_rdata[0]_i_2_n_0 ),
        .I1(sel0[1]),
        .I2(sel0[2]),
        .I3(timer_counter[0]),
        .I4(sel0[0]),
        .I5(peak_top_delay[0]),
        .O(reg_data_out[0]));
  LUT6 #(
    .INIT(64'hAFA0CFCFAFA0C0C0)) 
    \axi_rdata[0]_i_2 
       (.I0(\slv_reg3_reg[23]_0 [0]),
        .I1(\slv_reg2_reg[31]_0 [0]),
        .I2(sel0[1]),
        .I3(\slv_reg1_reg[31]_0 [0]),
        .I4(sel0[0]),
        .I5(Q[0]),
        .O(\axi_rdata[0]_i_2_n_0 ));
  LUT6 #(
    .INIT(64'h3A0A3A3A3A0A0A0A)) 
    \axi_rdata[10]_i_1 
       (.I0(\axi_rdata[10]_i_2_n_0 ),
        .I1(sel0[1]),
        .I2(sel0[2]),
        .I3(timer_counter[10]),
        .I4(sel0[0]),
        .I5(slv_reg4[10]),
        .O(reg_data_out[10]));
  LUT6 #(
    .INIT(64'hAFA0CFCFAFA0C0C0)) 
    \axi_rdata[10]_i_2 
       (.I0(\slv_reg3_reg[23]_0 [10]),
        .I1(\slv_reg2_reg[31]_0 [10]),
        .I2(sel0[1]),
        .I3(\slv_reg1_reg[31]_0 [10]),
        .I4(sel0[0]),
        .I5(slv_reg0[10]),
        .O(\axi_rdata[10]_i_2_n_0 ));
  LUT6 #(
    .INIT(64'h3A0A3A3A3A0A0A0A)) 
    \axi_rdata[11]_i_1 
       (.I0(\axi_rdata[11]_i_2_n_0 ),
        .I1(sel0[1]),
        .I2(sel0[2]),
        .I3(timer_counter[11]),
        .I4(sel0[0]),
        .I5(slv_reg4[11]),
        .O(reg_data_out[11]));
  LUT6 #(
    .INIT(64'hAFA0CFCFAFA0C0C0)) 
    \axi_rdata[11]_i_2 
       (.I0(\slv_reg3_reg[23]_0 [11]),
        .I1(\slv_reg2_reg[31]_0 [11]),
        .I2(sel0[1]),
        .I3(\slv_reg1_reg[31]_0 [11]),
        .I4(sel0[0]),
        .I5(slv_reg0[11]),
        .O(\axi_rdata[11]_i_2_n_0 ));
  LUT6 #(
    .INIT(64'h3A0A3A3A3A0A0A0A)) 
    \axi_rdata[12]_i_1 
       (.I0(\axi_rdata[12]_i_2_n_0 ),
        .I1(sel0[1]),
        .I2(sel0[2]),
        .I3(timer_counter[12]),
        .I4(sel0[0]),
        .I5(slv_reg4[12]),
        .O(reg_data_out[12]));
  LUT6 #(
    .INIT(64'hAFA0CFCFAFA0C0C0)) 
    \axi_rdata[12]_i_2 
       (.I0(\slv_reg3_reg[23]_0 [12]),
        .I1(\slv_reg2_reg[31]_0 [12]),
        .I2(sel0[1]),
        .I3(\slv_reg1_reg[31]_0 [12]),
        .I4(sel0[0]),
        .I5(slv_reg0[12]),
        .O(\axi_rdata[12]_i_2_n_0 ));
  LUT6 #(
    .INIT(64'h3A0A3A3A3A0A0A0A)) 
    \axi_rdata[13]_i_1 
       (.I0(\axi_rdata[13]_i_2_n_0 ),
        .I1(sel0[1]),
        .I2(sel0[2]),
        .I3(timer_counter[13]),
        .I4(sel0[0]),
        .I5(slv_reg4[13]),
        .O(reg_data_out[13]));
  LUT6 #(
    .INIT(64'hAFA0CFCFAFA0C0C0)) 
    \axi_rdata[13]_i_2 
       (.I0(\slv_reg3_reg[23]_0 [13]),
        .I1(\slv_reg2_reg[31]_0 [13]),
        .I2(sel0[1]),
        .I3(\slv_reg1_reg[31]_0 [13]),
        .I4(sel0[0]),
        .I5(slv_reg0[13]),
        .O(\axi_rdata[13]_i_2_n_0 ));
  LUT6 #(
    .INIT(64'h3A0A3A3A3A0A0A0A)) 
    \axi_rdata[14]_i_1 
       (.I0(\axi_rdata[14]_i_2_n_0 ),
        .I1(sel0[1]),
        .I2(sel0[2]),
        .I3(timer_counter[14]),
        .I4(sel0[0]),
        .I5(slv_reg4[14]),
        .O(reg_data_out[14]));
  LUT6 #(
    .INIT(64'hAFA0CFCFAFA0C0C0)) 
    \axi_rdata[14]_i_2 
       (.I0(\slv_reg3_reg[23]_0 [14]),
        .I1(\slv_reg2_reg[31]_0 [14]),
        .I2(sel0[1]),
        .I3(\slv_reg1_reg[31]_0 [14]),
        .I4(sel0[0]),
        .I5(slv_reg0[14]),
        .O(\axi_rdata[14]_i_2_n_0 ));
  LUT6 #(
    .INIT(64'h3A0A3A3A3A0A0A0A)) 
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
        .D(reg_data_out[5]),
        .Q(s00_axi_rdata[5]),
        .R(axi_awready_i_1_n_0));
  FDRE \axi_rdata_reg[6] 
       (.C(s00_axi_aclk),
        .CE(slv_reg_rden__0),
        .D(reg_data_out[6]),
        .Q(s00_axi_rdata[6]),
        .R(axi_awready_i_1_n_0));
  FDRE \axi_rdata_reg[7] 
       (.C(s00_axi_aclk),
        .CE(slv_reg_rden__0),
        .D(reg_data_out[7]),
        .Q(s00_axi_rdata[7]),
        .R(axi_awready_i_1_n_0));
  FDRE \axi_rdata_reg[8] 
       (.C(s00_axi_aclk),
        .CE(slv_reg_rden__0),
        .D(reg_data_out[8]),
        .Q(s00_axi_rdata[8]),
        .R(axi_awready_i_1_n_0));
  FDRE \axi_rdata_reg[9] 
       (.C(s00_axi_aclk),
        .CE(slv_reg_rden__0),
        .D(reg_data_out[9]),
        .Q(s00_axi_rdata[9]),
        .R(axi_awready_i_1_n_0));
  LUT4 #(
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
