StevekDon/NaI-Tl-scintillator-gamma-ray-Digital-Multi-Channel-Analyzer/(commit log)

2026-01-17 1st upload all the files
    [20251101_163339.csv, 3d_side_arm v6.stl, detector_cover.stl, param_cfgqt.txt, zynq_box.stl, zynq_cover.stl, 铅室Co60.csv]
2026-02-08 更新 README.md link
